sssamuelll/sam17/docs/superpowers/specs/2026-09-03-maestro-j2-recuperacion-design.md

# El maestro del J2: plazo, reinicio y cuenta, porque el silicio se cuelga

**Fecha**: 2026-09-03 · **Estado**: **v2 FIRMADA el 2026-09-10** · **Sujeto**: el cerebro (STM32N657, hub §S10) como maestro de las seis ranuras SPI del J2 · **Cierra**: #287 (puntos 1 a 3, cerrado) · **Cuelga de**: la cabecera del J2 (2026-09-02), el J2 punto a punto (2026-08-25), voz-total §9.2, el hub N657 (2026-08-30)

---

## 0. Qué es este papel, y qué no

Este papel decide **qué hace el cerebro cuando su propio periférico de SPI deja de responder**, y lo decide antes de escribir el driver, porque hay un defecto abierto en el silicio o en su driver que lo obliga: embassy-rs/embassy#5607, *«STM32N6 SPI Hanging»*, abierto desde 2026-03-05, sin diagnóstico, sin asignado, con la última actividad el 2026-06-24. El #287 trae la evidencia; aquí se diseña la respuesta.

Lo que el #287 destapó, en una línea: **el J2 tiene red de seguridad del lado del módulo y ninguna del lado del cerebro.** El módulo lleva watchdog de trama (voz-total §9.2), silencio por hardware sin CPU (motor-digital R-M5) y un receptor que rechaza entero y cuenta (cabecera D8). El cerebro, como maestro, no tiene nada: ni plazo, ni reinicio, ni cuenta. Un maestro colgado hoy se traduce en el módulo soltando las notas a los ~50 ms, y ahí se queda el instrumento.

Este papel lo arregla desde el marco de un fabricante, no desde el de un proyecto que espera a upstream: **el driver falla, se asume, y la recuperación es nuestra.** Lo que se pide del silicio es lo que el manual de referencia documenta; lo que se pide de embassy es lo que ya expone públicamente; y se dice cuál es la contribución que haría que el driver propio se retirara.

**Lo que NO es:**

- No diagnostica el defecto del N6. No hay Discovery (#231), y diagnosticar desde el sillón es fabricar.
- No rediseña la cabecera ni el punto a punto. El sobre, su CRC, la sesión, los registros de subida y `T_GAP` se quedan como están. Este papel les añade un cliente, y les manda dos enmiendas pequeñas (§10).
- No decide qué hace el instrumento con una ranura que reinicia mucho o que no contesta. Marca y sube; la política es de otro papel (§6).
- **Alcance: las seis ranuras SPI.** Las dos ranuras por USART síncrono con `CS` por GPIO que el censo del hub también sostiene (`micro_budget.py`, `HUB_RANURAS_USART = 2`; hub §10.3) son otro periférico con otra máquina de estados, y quedan fuera con su HUECO (§6, §9 riesgo 7). *(⚠ V-8)*
- No toca `pinout.rs`. El reparto de pines del hub es del censo y su reescritura es otra tanda.

---

## 1. Los clientes, con su fuente

| Cliente | Qué pide | Fuente |
|---|---|---|
| El músico | Que un fallo del bus no se oiga. Un cuelgue de 10-900 s de período no puede ser un release cada tanto | La regla del instrumento, y el #287 |
| El módulo de Voz | Que el maestro vuelva antes de que su watchdog de trama dispare | voz-total §9.2: *«sin trama válida en N ms (N del plan, ~50), todos los generadores van a release»* |
| La cabecera del J2 | Que la trama que llega, llegue entera o no llegue; que el CRC del sobre decida | D2: CRC-16/CCITT-FALSE *«de los PRIMEROS 4 + largo bytes»*, computado *«sobre el búfer al subir CS, con la unidad»*; D8: *«Un receptor que rechaza entero y cuenta»* |
| El censo del hub | Que el NSS lo maneje el periférico: `J2:SPI4_NSS=PE11` y equivalentes en SPI1-6 | `micro_budget.py`, hub §10.1 |
| El punto a punto | Que el reloj de cada enlace sea el sancionado, y que el maestro sea constante del cerebro por ranura | D2, D3 |
| El firmware del cerebro | Que la política se pruebe sin placa, en `core`, y que `fw` sea delgado | `fw/src/main.rs:6`: *«Capa DELGADA a propósito»* |
| El planificador del cerebro | Que siga siendo el único escritor del enlace | Cabecera R-C8: *«El enlace tiene un solo escritor en el cerebro: el planificador»* |
| Upstream | Que lo que aprendamos vuelva al hilo #5607 | El precedente de #911 y #6939 |

### 1.1 Lo que el issue dice, contra lo que tenemos *(⚠ filas 1 y 5 corregidas por S-2)*

| Hecho del hilo | Nuestro diseño | Consecuencia |
|---|---|---|
| En modo bloqueante, `RXP` no sube nunca: el maestro escribió, `TXC = 1`, y la recepción no vio nada. Con DMA se cuelga *«waiting for the end of transfer flag»* | El J2 es DMA en los dos extremos | El modo de fallo es **la recepción no termina** (H-1). Un plazo que solo cubra el fin de transferencia no lo ve: tiene que cubrir también la espera del DMA (D2) |
| Sale a 100 kHz y a alta frecuencia | 34,5 MHz (D8) | Bajar el reloj no es salida |
| Pasa con el bus al aire | 74 cm de cinta, sancionados | No es integridad de señal |
| Corrupción: el `CS` sube a mitad, un bit se duplica | CRC del sobre, receptor que rechaza entero | Se detecta; hay que absorberla sin que se oiga (D6) |
| El camino bloqueante y `write`/`transfer` con DMA van con `TSIZE = 0`; **`read` con DMA sí fija `TSIZE`** y también se cuelga | `TSIZE > 0` siempre (D1) | **`TSIZE` no es refugio.** Lo que sí es distinto: el `CS` lo mueve un GPIO en el hilo (`SSM = 1` en su volcado) y aquí lo mueve el periférico. Sin probar |
| Los dos reportantes usan `SPI5`; nadie probó otra instancia | Seis enlaces en `SPI1-6` | Pregunta upstream (§9, acción 1) |
| Escribir a `TXDR` desatasca el caso bloqueante; en DMA no | — | El reinicio es el del manual, no el paliativo |

> **Enmienda del 2026-09-08 (§1.1, alcance):** la premisa «nadie probó otra
> instancia» queda refutada. En [embassy-rs/embassy#5607](https://github.com/embassy-rs/embassy/issues/5607),
> jake-taf, uno de los reportantes originales, respondió el 2026-09-03:
> *«I have observed this problem on SPI1 as well»*. Hay cuelgues reportados en
> **dos instancias, SPI5 y SPI1**. El defecto no es exclusivo de SPI5; esta
> respuesta no demuestra que fallen todas las instancias del bloque ni
> identifica la causa. La pregunta de la fila ya tiene respuesta con ese alcance.

> **Enmienda del 2026-09-08 (§1.1, consecuencia de diseño):** cambiar de
> instancia no es una salida de esquemático acreditada por la evidencia. La
> recuperación es **obligatoria para las seis ranuras SPI**: el plazo de D3,
> los ocho pasos de D4 en su orden, la ventana deslizante y las dos marcas de
> salud de D7. La política vive en `software/nucleo/core/src/maestro_j2.rs` y
> el driver ejecuta la recuperación en `software/nucleo/fw/src/j2_spi.rs`
> (D8). Es un requisito del diseño aun sin diagnóstico, y ninguna ranura queda
> exenta por llevar una instancia distinta de SPI5.

### 1.2 Lo que embassy hace, leído en el código *(⚠ corregido por S-2)*

`embassy-stm32/src/spi/mod.rs`, `main` al 2026-09-03 (copia en el scratchpad de la sesión, 2130 líneas):

- **`read` con DMA** (`spi_v4`-`v6`) fija **`TSIZE = N`** por trozos (`:1332-1342`), arma el DMA de recepción, `SPE = 1`, `CSTART`, espera el futuro del DMA y luego `finish_dma`, que espera `EOT` en un bucle: `while !regs.sr().read().eot() {}` (`:1804-1808`). Al salir vuelve a `TSIZE = 0` (`:1372`).
- **`write` y `transfer`** no tocan `TSIZE`: heredan el `0` del constructor (`:488`) y `finish_dma` espera `TXC`. `transfer_inner` hace `join` de los dos futuros del DMA (`:1499`) y luego `finish_dma` (`:1501`).
- **Ese bucle es síncrono.** No cede al ejecutor. Un `embassy_time::with_timeout` alrededor de la llamada no puede vencerlo. Y el `join` de los futuros del DMA tampoco está bajo ningún plazo: si la recepción no termina (el modo del hilo), la tarea se queda ahí sin que exista siquiera un `TimeoutError` que recibir (H-1). Cuando el N6 se cuelga, **se congela la tarea y todo lo que comparta ejecutor con ella**.
- El SPI de embassy-stm32 **no usa su propia interrupción**: todo es DMA más sondeo. `EOTIE` no aparece en el archivo.
- **Sí maneja NSS por hardware**: `Spi` guarda `nss: CsPinType` (`:321`); `ssm = nss.is_none()` (`:390`); con pin de NSS y maestro, `SSOE = 1` (`:464`).
- **Sí apaga el SPI entre transferencias**: `set_spe(false)` al entrar a cada `write`/`read`/`transfer` y `set_spe(true)` antes de `CSTART`.

De aquí sigue: el driver de embassy tal cual **no sirve para el J2**, no por el defecto del N6, sino porque sus dos esperas no son cancelables. Eso contesta la fila 6 del §10 del hub para el SPI (§10, enmienda).

Lo que sí expone embassy, verificado en `main`, y que el driver propio usa sin tocar nada privado: `rcc::enable_and_reset::<T>()` (`rcc/mod.rs:622`), `dma::Channel::new` (`dma/mod.rs:80`) y `Channel::read`/`write(request, peri_addr, buf, opts) -> Transfer` (`gpdma/mod.rs:934`, `:1004`), el trait `spi::TxDma`/`RxDma` con `fn request(&self) -> Request` público (`macros.rs:162-173`), `embassy_time`, `InterruptExecutor` (`embassy-stm32/src/executor.rs:196`, `start(irq) -> SendSpawner`), y el `IWDG`, que el N657 sí trae (`stm32-data-generated/data/chips/STM32N657X0.json`).

---

## 2. Las decisiones

### D1. Toda transferencia del J2 lleva `TSIZE` y NSS por hardware, y son una sola decisión *(⚠ reescrita: la v1 ataba también el CRC de hardware, y la cabecera ya lo había descartado — S-1, V-1, H-4)*

El manual ata el NSS por hardware al contador. RM0486 Rev 4, §67.4.7, p. 3437:

> *«NSS output enable (SSOE = 1): this configuration is only used when the MCU is set as master. The NSS pin is managed by the hardware. The functionality is tied to CSTART and EOT control. As a consequence, the master must apply the proper TSIZE > 0 setting to control the NSS output correctly.»*

Y §67.4.12, p. 3447:

> *«If a hardware data counter is used (TSIZE bitfield of the SPI_CR2 register set to a nonzero value), the application software does not need to calculate the remaining number of data to be handled. The end of transfer automatically controls the CRC, as well as the hardware slave select management, when used.»*

O sea: el NSS por hardware que el censo ya reparte **no funciona sin `TSIZE`**. Los dos van juntos:

1. **`TSIZE = bytes clocados de la trama`**, la cuenta de la cabecera §4: `largo + 7` (sobre de 4, carga, CRC de 2, cola de 1), rellenada a la ventana del dialecto cuando toca (cabecera D6.3: en la Voz, ≥ `VENTANA_SUBIDA + 1 = 25`). Se conoce por construcción antes de cada transferencia. Nunca `0`. *(⚠ S-14, H-5: la v1 decía «sobre + cola» y omitía el CRC y el relleno)*
2. **`SSM = 0`, `SSOE = 1`, `SSOM = 0`**: el NSS baja con `CSTART` y sube con `EOT`. §67.4.7, p. 3438: *«When SSOM = 0 and SP = 000, the NSS signal is driven to the active level as soon as the master transfer starts (CSTART = 1) and it is kept active until its EOT flag is set or the transmission is suspended.»* El `CS` de la cabecera D3, *«el CS es la dirección»*, lo pone el periférico, no un GPIO.

**El CRC es el del sobre, y solo ese.** La cabecera D2 lo decidió: CRC-16/CCITT-FALSE sobre los primeros `4 + largo` bytes, dentro del sobre, computado con la unidad CRC del chip sobre el búfer, precisamente porque *«un receptor de largo variable no conoce `TSIZE`»*. El CRC del periférico SPI (`CRCEN`) viaja como trama aparte **después** de los `TSIZE` datos y se compara en el maestro contra lo que el esclavo shiftee en ese momento, que no es un CRC (§67.5.3, p. 3456: *«The length of the transfer must be defined by TSIZE. When the desired number of data is transferred, the TXCRC is transmitted and the data received on the line are compared to the RXCRC value.»*). Activarlo daría `CRCE` en cada giro y dos CRC en el cable. **`CRCEN = 0`.**

**Por qué importa contra el #5607, dicho sin exagerar:** el montaje del hilo mueve el `CS` con un GPIO. El nuestro lo mueve el periférico. Eso es lo único que separa los dos montajes, porque `TSIZE > 0` ya lo usa el `read` de embassy y también se cuelga (§1.1). No es prueba de nada; es una variable que el bring-up mueve (§9, riesgo 1).

> **Enmienda del 2026-09-08 (D1, NSS por hardware):** jake-taf respondió el
> 2026-09-03 en [#5607](https://github.com/embassy-rs/embassy/issues/5607):
> *«I haven't tried that mode.»*, sobre `SSM = 0, SSOE = 1`. No hay una prueba
> de ese modo documentada en la evidencia disponible. El bring-up (#231)
> aportará nuestro primer dato: si no se cuelga, será un hallazgo propio bajo
> las condiciones ensayadas; si se cuelga igual, el modo de NSS dejará de
> separar los casos con cuelgue. Sigue siendo **HUECO** el resultado con NSS
> por hardware; la recuperación de D4 sigue siendo requisito en ambos casos.

**Lo que trae de regalo:** con `TSIZE > 0` y `SSOM = 0`, el fin de la trama es un flanco de NSS generado por hardware al `EOT`, exacto al reloj. La cuenta de bytes en el flanco del esclavo (cabecera D6.4, H-14) recibe un flanco limpio.

### D2. Las dos esperas son cancelables, y el plazo abraza las dos *(⚠ reescrita: la v1 ponía el plazo solo sobre `EOT` — H-1, S-12, H-11)*

Una transferencia del J2 espera dos cosas: que el DMA termine (los dos canales, en full duplex) y que el periférico marque `EOT`. **Las dos esperas son futuros, y el plazo de D3 abraza las dos juntas:**

```
with_timeout(plazo, async {
    join(tx_dma, rx_dma).await;   // los Transfer de embassy, cancelables por Drop
    eot.await;                    // el futuro de la ISR
}).await
```

Si la recepción no termina nunca (el modo del hilo), el plazo vence en el `join`; si el DMA terminó y el periférico no marca `EOT`, vence en el segundo. En los dos casos la tarea recibe `TimeoutError` y ejecuta D4. Ninguna espera del J2 es un bucle sin cota (R-MJ2).

**El fin de transferencia es una interrupción.** El maestro habilita `EOTIE` y espera un futuro que resuelve la ISR. RM0486 §67.11.5, p. 3490: *«Bit 3 EOTIE: EOT, SUSP and TXC interrupt enable»*. Y §67.7, Tabla 661, p. 3458, la fila del evento:

| Interrupt event | Event flag | Enable control bit | Event clear method |
|---|---|---|---|
| End Of Transfer (full transfer sequence completed - based on TSIZE value) | EOT | EOTIE | Writing EOTC to 1 |

La ISR de `SPIn` hace lo mínimo: lee `SR`, guarda las banderas que importan (`EOT`, `SUSP`, `OVR`, `MODF`) junto con la **generación** de la transferencia en curso, limpia por `IFCR`, deshabilita `EOTIE`, y despierta (`AtomicWaker`). Solo `EOTIE` se habilita: con `TSIZE` y DMA no hay `OVR` en el maestro, `MODF` no aplica con un solo maestro por enlace (punto a punto D1), y el `CRCE` del periférico no se usa (D1). *(⚠ S-12c)*

**Tres reglas que cierran los huecos que la junta encontró en la espera** *(⚠ S-12, H-10, H-11)*:

1. **Cada transferencia tiene una generación** (`u32` por ranura, `+1` al armar). La tarea la escribe antes de armar y la ISR la copia junto a las banderas. La tarea acepta un resultado solo si la generación coincide; un `EOT` que llega después de vencido el plazo pertenece a una generación vieja, **se descarta y se cuenta** (`eot_tardios`), porque esa trama sí salió al cable y el módulo no la ve como perdida (§3.3, `perdidas ≥ rechazadas` cambia de lectura: ver §10).
2. **El resultado guardado se borra al armar**, antes de habilitar nada. Nunca se consume un búfer de la trama anterior.
3. **El `poll` del futuro de `EOT` registra el waker antes de mirar la bandera.** Al revés pierde el despertar y el plazo vence sobre una trama buena.

> **Enmienda del 2026-09-18 (D2 regla 1, lectura; revisión del driver, ruling R13):** el hardware no etiqueta el `EOT` con ninguna generación, así que lo único que la ISR puede copiar es la generación **armada en el instante en que corre**; la comparación de la regla 1 no puede fallar por sí sola. Lo que la regla 1 protege de verdad es un resultado guardado que la tarea no llegó a consumir: lo descarta y lo cuenta la regla 2 al armar (`Turno::armar`, en `core`). Y lo que protege a la generación es la disciplina de `EOTIE` (apagado en D4.1, encendido después de armar) más una cosa que faltaba: **una ISR ya pendiente en el NVIC cuando D4 apaga `EOTIE` corre después del reinicio**, y por eso D4 hace `NVIC::unpend` de la interrupción de la ranura tras el paso 1 y tras el paso 7.

**El orden de arranque, y por qué `EOTC` va donde va** *(⚠ S-12d, H-11)*: el manual dice en §67.11.6, p. 3492, que *«EOT is set by hardware as soon as a full transfer is complete, that is when SPI is re-enabled or when TSIZE number of data have been transmitted and/or received on the SPI. EOT is cleared when SPI is re-enabled or by writing 1 to the EOTC bit of the SPI_IFCR register optionally.»*, y en §67.11.6, p. 3490, que *«All the flags of this register are not cleared automatically when the SPI is reenabled.»* Las dos frases no encajan del todo, y este papel no elige cuál es la buena: **escribe `EOTC` después de `SPE = 1` y antes de `EOTIE = 1`**, con lo que da igual cuál sea. Es decisión propia por prudencia, no cita. El bring-up la mide (§9, riesgo 5). El orden completo:

```
SPE = 0 → TSIZE = N (CR2, solo con SPE = 0, p. 3484) → RXDMAEN → canales de DMA armados
→ TXDMAEN → SPE = 1 → EOTC → EOTIE = 1 → CSTART
```

Los pasos del DMA son los de §67.4.14, p. 3451: *«When starting communication using DMA, to prevent DMA channel management raising error events, these steps must be followed in order: 1. Enable the DMA Rx buffer in the RXDMAEN bit of the SPI_CFG1 register, if DMA Rx is used. 2. Enable DMA requests for Tx and Rx in DMA registers, if the DMA is used. 3. Enable the DMA Tx buffer in the TXDMAEN bit of the SPI_CFG1 register, if DMA Tx is used. 4. Enable the SPI by setting the SPE bit.»*

**El SPI está apagado entre transferencias, siempre.** El manual lo recomienda tres veces (p. 3448 *«it is recommended to disable the SPI and enable it again when the transfer is complete, even if the SPI configuration is not changed»*; p. 3492 *«SPI is strongly suggested to be disabled and re-enabled before next transfer starts despite its setting is not changed»*; y `TSIZE` solo se puede escribir con `SPE = 0`, p. 3484), embassy lo hace, y D4 lo necesita. *(⚠ S-4b)*

> **Enmienda del 2026-09-11 (D2, el hueco entre `SPE = 1` y `CSTART`; acta del 11-09, fichas 1 y 3):** el chip hermano tiene documentado un atasco del maestro que el orden de arriba no evita y, bajo una lectura del manual, provoca. ES0396 Rev 9 (STM32H750/H753, bloque `spi_v4`; el N657 es `spi_v5` y embassy los trata juntos), §2.14.2 «Master data transfer stall at system clock much faster than SCK», presente en todas las revisiones de silicio (A A A):
>
> *«With the system clock (spi_pclk) substantially faster than SCK (spi_ker_ck divided by a prescaler), SPI/I2S master data transfer can stall upon setting the CSTART bit within one SCK cycle after the EOT event (EOT flag raise) signaling the end of the previous transfer. Workaround. Apply one of the following measures: • Disable then enable SPI/I2S after each EOT event. • Upon EOT event, wait for at least one SCK cycle before setting CSTART. • Prevent EOT events from occurring, by setting transfer size to undefined (TSIZE = 0) and by triggering transmission exclusively by TXFIFO writes.»*
>
> Bajo la lectura literal de p. 3492 (*«EOT is set … when SPI is re-enabled»*), el `SPE = 1` del orden de arriba es él mismo un evento `EOT`, y `CSTART` llega tres escrituras APB después: **entre 15 y 60 ns** según pclk (cálculo de Halberg, junta del 11-09, H-1; no medido), contra **100 ns** de ciclo de SCK al piso de 10 MHz y 29 ns a los 34,5 MHz de D8. La solución 1 de la errata, apagar y encender, que D2 ya aplica, genera bajo esa lectura el evento que la solución 2 quiere evitar. Y ES0620 Rev 5 §2.2.1 (N657, #363) dice que el prescaler de APB no funciona y pclk replica siempre a hclk: la razón pclk/SCK no se puede bajar por ese camino.
>
> **Lo que cambia:** entre `SPE = 1` y `EOTC` el driver **lee de vuelta `CR1`** y **espera al menos un ciclo de SCK contado desde esa lectura**, en ciclos de CPU (80 a 800 MHz para 100 ns; 24 para 29 ns), no con `embassy_time`, cuyo grano de 1 µs es diez veces el ciclo. La lectura de vuelta es el anclaje: según Halberg, una escritura a memoria Device puede quedar en vuelo y el retardo transcurrir antes de que `SPE = 1` llegue al periférico; una lectura devuelve cuando el periférico contesta. Coste: 0,08 % del giro por ranura. El orden queda:
>
> ```
> SPE = 0 → TSIZE = N → RXDMAEN → canales de DMA armados → TXDMAEN
> → SPE = 1 → leer CR1 → esperar ≥ 1 T_SCK → EOTC → EOTIE = 1 → CSTART
> ```
>
> **Estado de la evidencia:** ES0620 Rev 5 (agosto 2026), la errata del N657, **no lista ningún ítem del periférico SPI**. La enmienda entra **por analogía** con el H7 y así queda marcada hasta que la placa la mida. La medida que dirime la lectura cuesta un acceso: con nada armado, escribir `SPE = 1` y leer `SR.EOT`. Si vuelve 1, la hipótesis está viva y todo armado cae dentro de la ventana al piso; si vuelve 0, el `EOT` anterior fue el de la trama del giro previo y D2 ya la cubría con más de 100 µs de sobra. Después, el barrido del retardo (§9, enmienda del 11-09, punto 3): una tasa de cuelgue que dependa del retardo es la firma de la errata; una que no, no lo es.
>
> **Medido el 2026-10-01 en la NUCLEO-N657X0-Q** (firmware `259bc91`, binario `control_positivo`; una corrida anterior con el mismo código sin commitear dio lo mismo): `eot_al_encender = 0` con el SPI5 recién reseteado (esclavo) y `= 0` con `MASTER = 1`. Prender no levanta `EOT`: por lo escrito arriba, D2 ya la cubría, y la errata 2.14.2 no es el mecanismo de #5607 en esta configuración (junta de Halberg, 11-09). Queda el barrido del retardo, que es lo que dice si la tasa depende de él.

> **Enmienda del 2026-10-14 (D2, `TXTF` al armar; medido en la NUCLEO-N657X0-Q):** el orden de arranque limpiaba `EOT` y nada más, y `TXTF` se queda puesto de una transferencia a la siguiente. §67.11.6, p. 3492: *«TXTF is set by hardware as soon as all of the data packets in a transfer have been submitted for transmission by application software or DMA, that is when TSIZE number of data have been pushed into the TxFIFO. This bit is cleared by software write 1 to the TXTFC bit of the SPI_IFCR exclusively.»* Ni `SPE = 0` ni rehabilitar lo borran, y el cierre de una transferencia buena no escribía `IFCR`. Con `TXTF` puesto al armar, el GPDMA no recibe ninguna petición de `TXDR`: en placa, el canal de transmisión se queda con sus 25 bytes (`CxBR1.BNDT = 25`), el maestro no saca reloj y el plazo vence. Pasaba en el **segundo giro de cada arranque**. Embassy limpia todas las banderas una sola vez, al configurar (`spi/mod.rs:462`), y transfiere con `TSIZE = 0`. El manual no dice si `TXTF` se pone con `TSIZE = 0` (p. 3492 lo liga a que `TSIZE` datos hayan entrado en la TxFIFO) y este banco no lo ha medido, así que no se sabe si el camino bloqueante de embassy lo sufre. **Lo que cambia:** `TXTFC` justo después del `SPE = 0` del armado, antes de tocar `TSIZE` y el DMA:
>
> ```
> SPE = 0 → TXTFC → TSIZE = N → RXDMAEN → canales de DMA armados → TXDMAEN
> → SPE = 1 → leer CR1 → esperar ≥ 1 T_SCK → EOTC → EOTIE = 1 → CSTART
> ```
>
> Medido después del cambio: 20 000 giros seguidos de 25 bytes a 8 MHz, los 20 000 con `EOT` en plazo y la subida exacta, y el esclavo contó 20 000 tramas enteras.

### D3. Toda espera tiene plazo, y el plazo sale de R-E1

El plazo es **por mensaje**, no global:

```
plazo(msg) = FACTOR_PLAZO × t_nominal(msg) + T_SUELO_PLAZO
t_nominal(msg) = bytes_clocados(msg) × 8 / f_reloj_sancionado(ranura)
```

- `bytes_clocados` es el de la cabecera §4 (sobre + carga + CRC + cola, con relleno), ya presupuestado en `trama_j2_budget.py`. Es el mismo número que `TSIZE` (D1).
- `f_reloj_sancionado` es el de la ranura (punto a punto D2, `sancion_j2.csv`), o el piso legado si no hay fila. Hoy no hay fila: el instrumento corre al piso.
- `FACTOR_PLAZO = 2` y `T_SUELO_PLAZO = 20 µs`: **ESTIMADO**, sin fuente. El factor cubre `T_GAP` (2 µs provisional), `MSSI`/`MIDI` si se usan, y la latencia de la ISR; el suelo evita que un `HOLA` de 9 bytes (cabecera §4) a 34,5 MHz, 2,1 µs, tenga un plazo de 4 µs. En el enlace de la Voz el `HOLA` va rellenado a 25 bytes, 5,8 µs. *(⚠ S-9: la v1 decía 7 bytes)* Los sella el bring-up con osciloscopio (§9, riesgo 2).
- **Cota:** por R-E1 ningún mensaje dura más de 100 µs al piso, así que `plazo ≤ 220 µs` para cualquier mensaje. El mensaje real más largo, `SET` de 16, son 82,4 µs al piso y 184,8 µs de plazo. El presupuesto asevera la cota.

**Lo que NO se pone bajo plazo:** el `T_GAP` entre mensajes y la cadencia del giro. Esos son del planificador (cabecera D8) y no tienen nada que colgarse.

> **Nota del 2026-09-19 (D3, la cota contra el reloj real):** los 82,4 µs y los 184,8 de arriba suponen que el enlace cloca a los 10 MHz del piso. **No es lo que sale.** El `MBR` solo da potencias de dos y redondea hacia abajo, y el kernel del SPI5 es `pclk2` = 32 MHz (no el HSI de 64: el mux se queda en su cero, `Spisel45::Pclk2`; la cadena está en `j2_spi::Ranura::f_sck_hz` y en el `//!` de `control_positivo`). Pedir 10 MHz da `/4`, o sea **8 MHz reales**, y con ese reloj:
> 
> - el `SET` de dieciséis, 103 bytes clocados, dura **103 µs** — por encima de los **100 µs de R-E1**;
> - su plazo sale `2 × 103 + 20` = **226 µs** — por encima de los **220 µs** que esta misma sección publica como cota.
> 
> Las dos son la misma cosa vista dos veces, y ninguna es un defecto del driver: **el driver usa el `f_sck` real y lo publica** (`Ranura::f_sck_hz`, la columna `reloj_MHz` del CSV y la línea de arranque de los cuatro binarios), así que el plazo que calcula es el correcto para el reloj que hay. Lo que está mal es la premisa de que el piso son 10 MHz clocados. Elegir el piso de verdad —subir el kernel, bajar el mensaje más largo, o sancionar la ranura— es el **#380**, y hasta entonces esta cota queda **declarada y no cumplida** para el `SET` de dieciséis. Ningún otro mensaje de la tabla de la cabecera §4 la roza: el siguiente, `BAHIA` con 71 bytes, son 71 µs y 162 de plazo.

### D4. Al expirar, el periférico se reinicia según el manual, entero y en orden, y el reinicio se cuenta *(⚠ reescrita: la v1 omitía un paso, encendía al final y dejaba `EOTIE` armado — S-4, S-12a, S-13, H-8)*

Un plazo vencido no se reintenta: se reinicia. La receta es la del RM0486, completa, y termina con el SPI **apagado**, que es como está siempre entre transferencias (D2).

> **Enmendada el 2026-10-14:** los pasos 3 a 7 de la receta se sustituyen por un reset del periférico por RCC. La enmienda está dentro del paso 2, antes del paso 3.

1. **Silenciar la ISR.** `EOTIE = 0`. Si no, el `CSUSP` del paso 3 produce `SUSP`, `SUSP` dispara la ISR (`EOTIE` cubre `SUSP`, p. 3490), y la ISR limpia `SUSPC` antes de que el paso 3 lo vea. *(⚠ S-12a)*
2. **Soltar el DMA.** Los dos `Transfer` de embassy se sueltan: su `Drop` (`gpdma/mod.rs:1287-1295`) llama a `request_reset()` y espera a que el canal pare; `request_reset` (`:902-910`) hace `request_pause()`, espera `is_running() == false`, y resetea el canal. Esa espera es un bucle con cota práctica (la pausa actúa al fin de la ráfaga en curso) pero sin cota escrita: si el canal de GPDMA mismo no responde, ahí se queda, y eso lo cubre el IWDG del hub (D5), no este papel (§9, riesgo 6). Esto es el paso 1 del cierre del manual, §67.4.14, p. 3451: *«To close communication, it is mandatory to follow these steps in order: 1. Disable DMA requests for Tx and Rx in the DMA registers, if the DMA issued. 2. Disable the SPI by following the SPI disable procedure. 3. Disable DMA Tx and Rx buffers by clearing the TXDMAEN and RXDMAEN bits of the SPI_CFG1 register, if DMA Tx and/or DMA Rx are used.»*

   > **Enmienda del 2026-09-18 (D4 paso 2 y R-MJ2; #368, riesgo 6 de la junta del 11-09):**
   > la espera del `Drop` deja de ser «de embassy y declarada» y pasa a tener **cota
   > propia**. El driver no suelta ningún `Transfer` mientras su canal pueda estar
   > corriendo: pide `request_pause()` a los dos canales (una escritura de
   > `CxCR.SUSP`, sin bucle; `gpdma/mod.rs:882-887`), sondea `is_running()`
   > como máximo **`T_CANAL` (ESTIMADO 10 µs, de la clase de `T_SUSP`)** y solo
   > entonces los suelta: el `Drop` de embassy (`request_reset()` + su espera,
   > `gpdma/mod.rs:1287-1295`) entra y sale al instante con el canal ya suspendido.
   > Si un canal no para dentro de la cota, el driver **escala**: deja los dos
   > `Transfer` en su `ManuallyDrop` sin soltar (no se llama a `drop`; un
   > `mem::forget` sobre un `ManuallyDrop` no hace nada) y resetea el GPDMA1 entero por RCC
   > (`rcc::enable_and_reset::<GPDMA1>()`; el generador de embassy implementa
   > `RccPeripheral` para `GPDMA1`). Las otras cinco ranuras ven sus futuros de DMA
   > resolverse, no reciben `EOT`, vencen su plazo y ejecutan D4 cada una: un
   > reinicio de las seis ranuras **bajo control y dentro de los 50 ms del módulo**,
   > no un reinicio del chip. Se cuenta aparte (`escaladas_gpdma`, en `fw`, no en
   > la política). El IWDG del hub deja de ser la cobertura del riesgo 6: es la red
   > de lo que ni un reset de RCC arregla, que por construcción no existe. Por qué
   > no la otra salida del issue (correr el reinicio en una tarea fuera del
   > ejecutor): una espera sin cota bloquea al ejecutor donde gire, y todos tienen
   > algo debajo que no puede parar. Los pasos están en
   > `docs/superpowers/plans/2026-09-18-j2-fase-b.md`, tarea 7d.
   >
   > *Correccion del mismo 18-09:* la primera redaccion de esta enmienda mandaba
   > `request_reset()` y luego sondear con cota. `request_reset()` de embassy ya
   > contiene `request_pause(); while is_running() {}` sin cota (`gpdma/mod.rs:902-910`,
   > que este mismo paso cita arriba): la cota habria sido codigo muerto. Lo cazo
   > la revision del driver, no el plan. La forma que vale es la de arriba.

   > **Enmienda del 2026-10-14 (D4 pasos 3 a 7 y D4.2; medido en la NUCLEO-N657X0-Q): los pasos 3 a 7 de abajo se sustituyen por un reset del periférico por RCC.** La receta dejaba el SPI muerto. Si la suspensión del paso 3 no llega a aceptarse antes del `SPE = 0` del paso 5, queda pendiente: sobrevive al apagado y a rehabilitar, y ningún `CSTART` posterior saca un solo reloj. El DMA llena la FIFO (`CxBR1.BNDT` del canal de transmisión baja de 25 a 9), no sube nada y el plazo vence en cada giro, para siempre. La suspensión no se aceptó en los dos casos medidos:
   >
   > - **un maestro parado con `CSTART = 1` y la FIFO vacía**, que es el estado de un cuelgue: tras `CSUSP` y 10 µs, `CR1` sigue en `0x201` (`SPE` y `CSTART`) y `SUSP` no sube. La frase de p. 3483 (*«the CSTART bit is reset at the end of the current frame»*) no tiene trama en curso que terminar;
   > - **un aborto a mitad de trama a 125 kHz**, donde un byte dura 64 µs y `T_SUSP` eran 10.
   >
   > El mismo atasco limpiado solo con `SPE = 0`, sin `CSUSP`, sí se recupera. Pero el banco acaba de enseñar que `SPE = 0` no limpia todo el estado interno, aunque p. 3484 diga *«the internal state machine is reseted»*: la suspensión pendiente sobrevive. Lo único que revivió el SPI envenenado fue el reset por RCC, y es lo único que no depende de qué haya dentro. Esto contesta los hallazgos 9 y 15 de Serrano en la junta del 11-09 (*«¿el reinicio de D4 incluye reset por RCC o no?»*): sin él, el reinicio no curaba. Lo que sigue sin evidencia es que el reset cure **el cuelgue del N6**, que este banco no ha reproducido; cura los dos estados que sí se produjeron.
   >
   > La receta queda en seis pasos:
   >
   > 1. silenciar la ISR (`EOTIE = 0` y `NVIC::unpend`), sin cambios;
   > 2. soltar el DMA con cota `T_CANAL`, sin cambios;
   > 3. **resetear el SPI por RCC**, con el reset que de verdad resetea (`rcc::disable` y después `rcc::enable_and_reset`; ver el último párrafo). Deja todos los registros en su valor de reset: `SPE = 0`, los dos `DMAEN` y `IER` a cero y las banderas limpias, que es lo que hacían los pasos 5 a 7, y se lleva además lo que esos pasos no alcanzan;
   > 4. **reescribir `CFG2` y `CFG1`** tal como los dejó la construcción (D1). `CFG2` primero: con `AFCNTR = 1`, NSS y SCK vuelven a su nivel inactivo. Entre el reset y esa escritura el SPI no maneja NSS ni SCK, y el `CS` queda un instante a lo que ponga el esclavo (en el banco, el pull-up de PE11). La trama ya estaba perdida (p. 3449);
   > 5. `NVIC::unpend` otra vez, por lo mismo que antes;
   > 6. contar y seguir (el paso 8 de abajo).
   >
   > `T_SUSP` desaparece, y con él uno de los dos sondeos acotados de R-MJ2; queda `T_CANAL`. **Medido después del cambio:** un aborto a mitad de trama a 125 kHz deja el SPI en sus valores de reset y los dos giros siguientes salen bien; un SPI envenenado a propósito vence su primer giro, el D4 de ese giro lo revive y los dos siguientes salen bien.
   >
   > **D4.2, la escalada, tampoco reseteaba nada.** `rcc::enable_and_reset` de embassy solo pulsa el bit de reset si el reloj del periférico está apagado; con el reloj encendido se lo salta (`rcc/mod.rs`, `enable_and_reset_with_cs_inner`, rama `skip reset`). El GPDMA1 se enciende al arrancar, así que la escalada de la enmienda del 18-09 dejaba los canales como estaban y devolvía `Escalado` igual. Medido: con `enable_and_reset` solo, el `CxCR` del canal 0 no cambia; con `rcc::disable` delante vuelve a cero y los dos canales del esclavo quedan en reposo. La escalada va ahora por ese par, igual que el paso 3. Vale para SPI1-6 y GPDMA1 porque ninguno lleva cuenta de referencias en el `_generated.rs` (`refcount_idx = None`), y `disable` apaga el reloj sin preguntar.

3. **Suspender, con cota.** `CSUSP = 1` y sondear `SUSP = 1` **como máximo `T_SUSP` (ESTIMADO 10 µs)**, contando con `embassy_time::Instant` (tick declarado en el plan; 1 MHz cubre esta cota) o con ciclos. §67.11.1, p. 3483: *«In master mode, when this bit is set by software, the CSTART bit is reset at the end of the current frame and communication is suspended. The user has to check SUSP flag to check end of the frame transfer.»* Es una espera síncrona **acotada**, que R-MJ2 permite: es el único sitio donde un sondeo con cota es la herramienta honesta, porque el periférico está mintiendo. *(⚠ S-13, V-11)*
4. **Limpiar `SUSP` incondicionalmente.** `SUSPC = 1`, haya llegado `SUSP` o no. §67.11.6, p. 3491: *«This bit must be cleared prior to disabling the SPI. This is done by setting the SUSPC bit of SPI_IFCR exclusively.»* Escribir `SUSPC` sin `SUSP` no hace nada, y escribirlo con `SUSP` recién llegado (entre la cota y el apagado) evita apagar con la suspensión a medio aceptar. *(⚠ S-4c)*
5. **Apagar.** `SPE = 0`. §67.11.1, p. 3484:

   > *«When SPE = 0 any SPI operation is stopped and disabled, all the pending requests of the events with enabled interrupt are blocked except the MODF interrupt request (but their pending still propagates the request of the spi_plck clock), the NSS output is deactivated at master, the RDY signal keeps not ready status at slave, the internal state machine is reseted, all the FIFOs content is flushed, CRC calculation initialized, receive data register is read zero.»*

   Se acepta la pérdida de la trama en curso. §67.4.12, p. 3449: *«Caution: If the SPE bit is cleared in master mode while the transfer is ongoing without any suspension, the clock is stopped even if the current frame transmission is not complete, and the content of the FIFOs is flushed and lost.»* Esa trama ya estaba perdida. *(⚠ S-3: la cita va entera; la v1 la había recortado)*
6. **Apagar los búferes de DMA del periférico.** `TXDMAEN = 0`, `RXDMAEN = 0` en `CFG1`, que solo se puede escribir con `SPE = 0` (p. 3484: *«The content of this register is write protected when SPI is enabled.»*). Es el paso 3 del cierre del manual, y la v1 no lo tenía. *(⚠ S-4a)*
7. **Limpiar banderas.** `IFCR`: `EOTC`, `TXTFC`, `OVRC`, `SUSPC`, `MODFC`. Las de `SR` no se limpian solas (p. 3490).
8. **Contar y seguir.** `plazos_vencidos[ranura] += 1`. La ranura queda como entre transferencias: apagada y limpia. El planificador sigue con el **siguiente giro**, no con la trama perdida: el registro de subida se muestrea (cabecera D6), y lo que baja se reafirma (D7), así que no hay nada que retransmitir. *Salvo* un `EVENTO`: ese no tiene red, y así lo dice la cabecera (D7 tabla: *«un `dispara` perdido es un golpe perdido»*). Ver D6 y §3.

**Lo que le pasa al esclavo, y lo que este papel le manda al papel del módulo** *(⚠ S-5, V-9: la v1 decía «el flanco lo realinea», y la cita que lo sostenía es del esclavo recién habilitado, no del interrumpido)*: el `SPE = 0` desactiva el NSS del maestro (p. 3484), así que el módulo ve el `CS` subir a mitad de trama. Por la cabecera D6.4 cuenta bytes en el flanco y ve una trama corta; por D8 la rechaza entera y cuenta. Lo que el manual dice del esclavo interrumpido es una sola frase, §67.4.13, p. 3450: *«In slave mode, any ongoing data are lost when disabling the SPI.»* De aquí sigue que la limpieza del esclavo es **apagar y encender su SPI**, y que un esclavo que solo rearme el DMA puede arrastrar medio byte en el registro de desplazamiento y rechazar también las tramas siguientes. **Enmienda mandada al papel del módulo (§10):** al contar corto en el flanco de `CS`, el módulo hace `SPE = 0` → `SPE = 1` en su SPI antes de rearmar el DMA de recepción. Es una línea en su ISR, y es la única forma que el manual documenta de dejar el esclavo limpio.

**La `secuencia` de la trama abortada se consumió.** El planificador la asignó y el módulo no la aceptó, así que el módulo verá un hueco y lo contará en `perdidas` (cabecera §3.3, R-C3). Es correcto y esperable: en el bring-up, `perdidas` del módulo se cruza con `plazos_vencidos + eot_tardios` del cerebro (D2 regla 1), y la diferencia es lo que de verdad se perdió por el cable.

**Lo que NO se hace:** escribir a `TXDR` para desatascar. Es el paliativo del hilo para el caso bloqueante, no funciona en DMA, y meter un byte en el bus a mitad de un estado desconocido es peor que apagar.

> **Enmienda del 2026-09-08 (D4, dato del mecanismo):** jake-taf confirmó el
> 2026-09-03 en [#5607](https://github.com/embassy-rs/embassy/issues/5607):
> *«Interesting. I stuck with blocking since I have a workaround when it gets stuck (`SPI1.txdr8().write_value(0)`), but both have the problem»*.
> Confirma que usa ese paliativo en el camino bloqueante y que el cuelgue
> ocurre tanto en el bloqueante como con DMA. La prohibición de escribir a
> `TXDR` para desatascar sigue en pie, tal cual (R-MJ3).

### D5. El J2 corre en su propio ejecutor, con una tarea por ranura; el IWDG es del hub *(⚠ reescrita entera: la v1 tenía un vigía y alimentaba el IWDG desde el J2 — V-4, V-5, V-6, S-7, S-8, H-1, H-2, H-6, H-9)*

La v1 ponía un vigía en un ejecutor de interrupción que reiniciaba ranuras estancadas. La junta lo tumbó por tres lados que no admiten parche: no cubre ningún fallo que D2-D4 no cubran (si la tarea está viva, el plazo gana; si el ejecutor está congelado, reiniciar el SPI no lo descongela); no puede soltar los `Transfer` que posee la tarea, así que corre otra receta y deja dos dueños del canal; y una sección crítica que no suelta lo congela con lo que vigila. Era otra mano en el mismo volante, y R-C8 dice un solo escritor. **Muere.** Lo que queda es más simple y es lo que corre:

1. **Seis tareas, una por ranura**, cada una con su plazo (D3), su reinicio (D4) y su máquina (D7). En serie no caben: seis `NADA` de 25 bytes al piso son 120 µs más seis `T_GAP`, 132 µs en un giro de 125 (S-8). Los seis periféricos y sus doce canales de DMA corren en paralelo por hardware; las tareas solo los atienden. Un plazo vencido en una ranura no retrasa a las otras cinco, y la cuenta de D7 es por ranura: un cuelgue en una no ensucia la ventana de las demás (H-1).
2. **El planificador sigue siendo el único escritor del enlace** (R-C8). Decide qué baja por cada ranura en cada giro; las seis tareas son el transporte, como lo son los canales de DMA. No deciden nada del protocolo.
3. **Las seis tareas viven en un `InterruptExecutor` propio** (`embassy-stm32/src/executor.rs:196`), a prioridad por encima del ejecutor de hilo donde viven la pantalla, el USB y el MIDI (`fw/src/main.rs`). Una tarea de pantalla que retenga la CPU 15 ms no retrasa un giro del J2 ni un microsegundo; sin esto, la simulación de Halberg da giros perdidos a partir de 6 ms de retención y el módulo soltando a 50 (H-9). El J2 es tiempo real a 8 kHz y la pantalla no; no comparten ejecutor.
4. **El IWDG es del chip, no del J2.** Alimentarlo desde el planificador del enlace definía la vida del instrumento como «el J2 dio un giro», y con una ranura sin módulo lo habría disparado diez veces por segundo (H-6). Este papel **no decide** quién alimenta el IWDG ni con qué plazo. Le manda al papel del hub (§10) un **supervisor de vitalidad**: cada subsistema con requisito de tiempo real (el J2, la pantalla, el USB, la radio) escribe un sello; el supervisor alimenta el IWDG solo si todos los que deben estar vivos lo están. Lo que el J2 aporta es **un sello por ranura activa**, escrito al armar cada transferencia (no al completarla: una ranura reiniciando también está viva). Y le manda una cota: **el plazo del IWDG es estrictamente mayor que la ventana del watchdog de trama del módulo (~50 ms)**, para que cuando el chip se reinicie el módulo ya esté en release por su cuenta y el reinicio no añada silencio: lo termina de ordenar. Cuánto silencio añade el arranque del cerebro (descubrimiento por I²C, `HOLA`, los 7,9 ms de refresco de la cabecera D5) no está cuantificado y es HUECO del hub (S-10).

> **Enmienda del 2026-09-18 (D5.1 y §3; revisión del ejecutor, ruling R15):** tras un plazo vencido la tarea de la ranura **se realinea** al periodo (`Ticker::reset()`), no recupera los tics perdidos. Sin esto el `Ticker` de embassy clocaría en ráfaga hasta reengancharse y dejaría fronteras de trama con gap ≈ 0, justo cuando el esclavo acaba de que le arranquen el `CS`: borraría el `T_GAP` de la cabecera D8 (2 µs provisional, HUECO). El techo de recuperación de §3 se mantiene: 220 + 20 + 125 = 365 µs < 490.

> **Enmienda del 2026-10-16 (D5.1 y D5.4; el lazo no puede acaparar la CPU; medido en la NUCLEO-N657X0-Q):**
>
> **Lo que pasó.** El 15-10 se lanzó `resistencia_j2`, que pone la ranura 0 dentro del `EJECUTOR_J2` como lo hará el instrumento, y no publicó nada. Un giro cuesta más que el periodo y el `Ticker` de embassy recupera los tics perdidos (`embassy-time/src/timer.rs:470-480`), así que el ejecutor encadenaba giros sin parar y no se quedaba nunca sin trabajo. Medido por el depurador: `SELLOS[0]` subía a unos 2 700 por segundo, el contador de vueltas del hilo no se movió en minutos y `main` —que lanza el esclavo y publica las filas— no llegó a ejecutarse: `TRAMAS_OK = 0`, `subidas_malas = giros` y `muda = 1`. En el instrumento, el hilo (USB, MIDI, pantalla) habría pasado hambre igual.
>
> **Lo que cambia.**
>
> 1. **El calendario es de `core`** (`Calendario`, probado en el host). A tiempo sigue la rejilla del periodo. Si el giro, **y todo lo que la tarea hace con él**, acaba cuando ya tocaba el siguiente, no recupera nada: deja **un periodo entero de hueco** y cuenta un atraso (`atrasos`, publicado con las demás cuentas, saturado y no vuelve a cero). Es el `Ticker::reset` de la enmienda del 18-09 aplicado a cualquier atraso y no solo al plazo vencido; el hueco sigue siendo el que el esclavo necesita para rearmar (`T_GAP`).
> 2. **Un atraso es un fallo del presupuesto de CPU, no del módulo.** No mueve `inestable` ni `muda`, y D7.1 no cambia: la salud no baja la cadencia. Lo que baja la cadencia es la carga, y lo dice un contador.
> 3. **El periodo del banco puede ser más largo que el del instrumento, nunca más corto.** `lanzar_ranuras` recibe `periodo_us` y rechaza menos de `PERIODO_GIRO_US`. `resistencia_j2` corre a 1 kHz porque a 125 µs la CPU de la Nucleo (64 MHz, sin cachés) no da para el maestro y el esclavo del banco juntos: con el esclavo en el mismo ejecutor el hilo no recibió ni una vuelta en minutos y el binario no habría podido publicar una fila. A 1 ms, el hilo conserva el 54 % de la CPU y `atrasos` casi no sube (uno en 316 000 giros, y cuatro en los 86,4 millones de las 24 h del soak del 17-10). **La fila de esa corrida vale para 1 kHz, no para 8.**
> 4. **El esclavo del banco nace antes que el maestro.** `arrancar` se parte en `iniciar_ejecutor` y `lanzar_ranuras`: con un solo paso, el maestro giraba desde el primer instante contra un esclavo que todavía no existía y los primeros giros salían como `subidas_malas`.
> 5. **El IWDG lo alimenta el hilo** (requisito mandado al hub, #291). D5.4 dice que el sello sube al armar; el 15-10 subía a 2 700 por segundo con el hilo muerto, así que un supervisor que lea el sello no habría visto nada y el instrumento se habría quedado congelado sin reiniciarse. Alimentar el IWDG desde la prioridad más baja, después de comprobar el sello de las ranuras, es la única red que cubre el caso en que la CPU no alcanza: la sobrecarga acaba en un reinicio, no en un congelamiento.
>
> **Lo que el papel no tenía: un presupuesto de CPU para un giro normal.** D7.2 acota la CPU de los *reinicios* (16 % por ranura) y no dice nada de la de los giros que salen bien. Medido con `carga_j2` (maestro solo, 64 MHz, a 1 kHz; el mismo binario repite a ±1 ciclo y entre compilaciones distintas del código varía hasta un 10 %): un giro cuesta en el ejecutor del J2 **unos 17 400 ciclos sin cachés y 14 000 con la I-cache encendida**, y de esos solo 6 600 y 5 200 son código de la tarea; el resto, 10 800 y 8 800, es la maquinaria de futuros y el despacho del ejecutor. Al hilo le quedan el **69 %** y el **75 %** de la CPU. Lo que cuenta contra el límite de abajo es el J2 entero —con la ISR del SPI, el DMA y el reloj de embassy, no solo el manejador del ejecutor—, y sale de lo que el hilo no usa: **20 200 y 16 100 ciclos por giro**. Seis ranuras a 8 kHz son 48 000 giros por segundo: con ese coste son más de un núcleo entero a 800 MHz.
>
> **Firmado por Samuel el 2026-10-16** («firmamos el reparto de CPU del J2»): el J2 del hub —las seis ranuras a 8 kHz, con sus ISR, el despacho del ejecutor y los DMA— gasta **como máximo el 15 % de un núcleo del N657 a 800 MHz**, el punto de diseño del papel de alimentación (*«VOS high a 800 MHz»*): 120 millones de ciclos por segundo, o sea **2 500 ciclos por giro**. Es la primera fila del censo de CPU del hub, que no existe: `carga_motor_budget.py` es del motor y dice que sus filas heredadas no son un censo del hub, y el resto del reparto (pantalla, USB, MIDI, escritor de CV) sigue sin firmar. El oyente J2 de ese libro (20 a 50 ciclos por muestra) es el lado esclavo y no se toca. **El límite se comprueba midiendo `carga_j2` con el reloj y las cachés del hub** y anotando la fila en `carga_j2.csv`; `recuperacion_j2_budget.py` la lee y falla si una fila a 800 MHz lo pasa. Hoy solo hay filas de la Nucleo a 64 MHz: 20 160 ciclos sin cachés y 16 112 con I-cache, **8,1 y 6,4 veces el límite** (el manejador del ejecutor solo, sin la ISR del SPI, el DMA ni el reloj, son 17 415 y 14 004). No son el reloj del hub. La exploración del 17-10 a 800 MHz, que no es una fila porque le falta la región MPU de los búferes del DMA (R-MJ7), dice lo mismo: **8 000 ciclos por giro con las dos cachés (3,2 veces el límite)**, 58 000 con solo la I-cache y 82 000 sin cachés. Con tres ranuras girando son 8 167 por giro: el coste no se reparte entre ranuras, y las seis serían cerca de la mitad de un núcleo (48 %). De esos 8 000, solo 2 700 son código de la tarea; los otros 5 300 son la maquinaria de futuros y el despacho del ejecutor (3 100, 1,24 veces el límite por sí solos), la ISR del SPI y unos 1 950 sin atribuir. El mismo giro hecho por ISR, sin ejecutor (`j2_isr`, una cota: sin plazo ni D4, sin esclavo), mide **1 500**. Qué forma tiene el transporte para caber queda abierto, y cambiarla es cambiar D5.1: va por brief, papel y junta antes de la firma.
>
> Es el riesgo 9 de §9.
>
> **Acta del 2026-10-17 (el reparto de CPU del J2; D5.1 y riesgo 9).** Firmada por Samuel tras la junta del transporte (`docs/superpowers/juntas/2026-10-17-j2-transporte/acta-2026-10-17.md`); no cambia el texto firmado de arriba, lo precisa:
>
> 1. **Qué cuenta contra los 2 500 ciclos por giro:** el trabajo propio del enlace —armar y cerrar cada transferencia, el tic o las interrupciones del J2, el DMA, la comprobación de la subida (el CRC del sobre) y los contadores de salud de la política—. **No cuenta** decidir qué se envía (componer la trama a partir de notas, CV y pantalla), que será una fila aparte del censo de CPU del hub.
> 2. **El 15 % queda PROVISIONAL** hasta que exista el censo de CPU del hub: la fila del J2 era la primera de un libro que no existía. El transporte de D5.1 sigue en vigor. La puerta conserva el límite y sigue sin medida a 800 MHz con las cachés del hub.
> 3. **Se construye un prototipo de banco** del transporte «por tic» (`papel-v2.md` de la junta), acotado en el tiempo, que no toca nada firmado ni el binario del instrumento.
>
> Cambiar D5.1 sigue exigiendo brief, papel, junta y firma.
>
> **Actas del 2026-10-19 (el transporte por tic; D4.2, D5.1, R-MJ4).** Firmadas por Samuel tras la segunda a la sexta pasada de la junta del transporte (`acta-2026-10-19.md` y `acta-2026-10-19-tercera.md`, con el papel `papel-v3.md`, en `docs/superpowers/juntas/2026-10-17-j2-transporte/`). No cambian el texto de arriba, que sigue en vigor hasta que se cumplan las doce condiciones de §5.2 del papel:
>
> 1. **El transporte por tic es el diseño que se construye** (ficha A): una máquina por ranura movida por un tic de 125 µs, con el planificador y la recuperación en niveles por debajo. Lo que reescribe de D2, D4, D5.1, D7 y R-MJ2 a R-MJ4 está en §6 del papel.
> 2. **La escalada del GPDMA1 (D4.2) la autoriza un presupuesto** (ficha B): como mucho 6 en cualquier ventana de 1 s, y 1 ms entre dos concedidas, que despierta el tic.
> 3. **Las cotas de los estados de recuperación** (ficha C): `Vencida` 25 ms y `Reiniciando` 14 ms, con dos asertos en `lanzar`. **Dependen de dos números que no son del J2:**
>    - **El techo de silencio del módulo, que es de voz-total:** `T_WATCHDOG_TRAMA` = 50 ms, ESTIMADO, con una tolerancia del oscilador del módulo de ± 2 %, ESTIMADA. El aserto del módulo lo compara con el mayor hueco entre tramas de una ranura que se recupera, 39,75 ms. Si voz-total lo baja de unos 41 ms, la ficha C vuelve a la mesa.
>    - **Que el censo del hub (R-H6) excluya la saturación sostenida de las interrupciones de nivel 2:** con ellas ocupadas ~94 % durante ~100 ms, un bloqueo largo del GPDMA1 encadena incidentes, las ranuras sobreviven y los módulos pasan de 60 a 85 ms sin trama (S). El aserto del módulo vale por incidente y no lo ve.
>
>    Y R-H1, la ventana de inanición de 12 ms por nivel, también es del hub.
> 4. **El enlace del J2 vive en TCM** (ficha H, R-H4 del papel), **el CRC del sobre se calcula en el cerebro con una tabla** (ficha I; enmienda del 19-10 en D2 de la cabecera del J2), y **la fila del J2 en el censo de CPU es del 14,1 al 14,5 % de un núcleo (E)** (ficha J). La salida de la excepción y la entrada del planificador quedan por medir, y la pasada de optimización corre solo si el total medido pasa del 15,0 %.

### D6. La corrupción la absorbe el CRC del sobre; lo que tiene red se repara solo, y lo que no la tiene se dice *(⚠ precisada: V-7, S-10, S-11, H-4)*

El segundo síntoma del hilo, el bit duplicado con el `CS` subiendo antes, **no necesita nada nuevo**:

- El CRC del sobre (cabecera D2, con la unidad) la caza en el maestro y en el esclavo (D8: rechaza entero y cuenta). El maestro cuenta `subidas_malas`.
- En bajada, `TONO` completo sale a ≥ 1 kHz aunque nada cambie (cabecera D4): una trama de deltas perdida se repara sola en ≤ 1 ms. `SET`, `BAHIA` y `COMPUERTA` se reafirman (D7). La simulación de Halberg (sim4) lo confirma: a la tasa de corrupción del hilo y a cien veces esa tasa, ningún tono viejo dura más de 1,0 ms; a diez mil veces, 2,0 ms; hasta una pérdida de una trama por cada cien, ninguno pasa de 5 ms.
- **`EVENTO` no tiene red**, y eso lo decidió la cabecera (D7: *«un `dispara` perdido es un golpe perdido»*), no este papel. Un cuelgue o una corrupción que caiga en un giro con `EVENTO` es un golpe perdido. Es una **probabilidad**, no un invariante: `P(golpe perdido por cuelgue) = giros_perdidos_por_cuelgue × P(EVENTO en un giro)`, y el segundo factor depende de lo que el músico toca. El presupuesto lo deja como función con sus dos parámetros (§8); no le pone cifra, porque la tasa de cuelgues es de la Discovery y la densidad de eventos es del músico.
- **En subida, una lectura corrupta se pierde hasta la próxima publicación de ese registro**, no 125 µs: el módulo avanza de registro cuando contó bytes suficientes (cabecera D6.2), no cuando el maestro validó. `SALUD` y `ESTADO_VOZ` se publican a 1 Hz, así que una muestra corrupta es un segundo sin esa muestra; como los contadores son totales desde la sesión (cabecera §3.3), la siguiente muestra los trae. *(⚠ S-11)*

**La tasa del hilo no se normaliza.** La v1 dividía *«una o dos veces por minuto»* de otro montaje entre nuestras tramas por segundo y llamaba a eso una tasa por trama. No lo es: reloj, largo y cadencia de aquel montaje no son los nuestros. Lo que el hilo aporta son dos órdenes de magnitud a medir en el nuestro: cuelgues con período de 10-900 s y corrupción de una o dos por minuto. La Discovery mide las nuestras (§9, riesgo 1).

### D7. La ranura nunca deja de girar: la salud es una marca que sube, no una cadencia que baja *(⚠ reescrita entera: la v1 tenía sondeo lento con `HOLA`, umbrales de vuelta y backoff — V-2, V-3, V-10, S-6, S-15, H-2, H-7, H-13)*

La v1 declaraba «enferma» una ranura con muchos reinicios y la pasaba a un sondeo cada 100 ms con `HOLA`. La junta lo tumbó cuatro veces: `HOLA` abre sesión y suelta las notas (cabecera D5, R-C7); 100 ms entre tramas garantiza el release del módulo a los 50; volver a sana costaba diez segundos de silencio; y la simulación de Halberg (sim3) dice que **sin ese mecanismo ningún hueco llega a 50 ms hasta que la mitad de las tramas se cuelgan**, mientras que con él la ranura oscila entre sana y enferma a partir de cuatro cuelgues por segundo y el módulo pasa la mayor parte del tiempo en release. Hacía daño y no aportaba. **Muere.**

Lo que queda:

1. **El planificador gira a 8 kHz por toda ranura activa, siempre.** Un plazo vencido se reinicia (D4) y el giro siguiente sale a su hora. No hay cadencia reducida, no hay backoff, no hay sondeo, no hay «vuelta a sana» y por tanto no hay refresco especial: el bloque completo a 1 kHz y las reafirmaciones de la cabecera D7 hacen ese trabajo solos, porque nunca dejaron de hacerlo.
2. **El coste de CPU está acotado por construcción**, no por umbral: como máximo un reinicio por giro por ranura, `8000 × T_REINICIO` por segundo. Con `T_REINICIO` ESTIMADO 20 µs son 16 % de un núcleo por ranura con **todas** sus tramas colgándose, 96 % con las seis. Eso es el instrumento roto, y se acepta que un instrumento roto gaste CPU en intentar no estarlo. El presupuesto lo asevera como cota (§8). *(Solo los reinicios: el coste de un giro normal no está acotado por construcción. Su límite, firmado el 16-10, es de 2 500 ciclos por giro: ver la enmienda de D5.1 y el riesgo 9.)*
3. **La salud son dos marcas por ranura, calculadas sobre una ventana deslizante, y suben al instrumento:**
   - **`inestable`**: `plazos_vencidos` en la última `VENTANA_SALUD` (ESTIMADO 1 s) ≥ `UMBRAL_INESTABLE` (ESTIMADO 10). Es información, no acción: no cambia lo que la tarea hace.
   - **`muda`**: `subidas_malas` seguidas ≥ `UMBRAL_MUDA` (ESTIMADO 40, o sea 5 ms). Es el testigo que la v1 no tenía (V-10): la subida lleva el sobre con su CRC en cada giro (cabecera D6.1), así que el maestro sabe en cada giro si el módulo contestó bien. Un módulo muerto (MISO en pull-down, ceros) es `muda` en 5 ms aunque el periférico del cerebro dé `EOT` perfecto. `giros` mide *«mi periférico terminó»*; `subidas_ok` mide *«el módulo contestó»*; son dos cosas y se cuentan aparte.
   - Ninguna marca cambia la cadencia ni manda `HOLA`. `HOLA` se manda cuando la cabecera D5 dice: al muestrear `sesión = 0`. Una ranura `muda` no muestrea nada, así que no manda `HOLA`; sigue clocando lo que el planificador diga, y la marca sube.
4. **`Vacia`**: una ranura sin identidad por I²C (punto a punto D2: el descubrimiento precede a *«la primera palabra de SPI»*) no entra al lazo. No se cloca, no se cuenta, no tiene marcas. Sin esto, cada ranura vacía contaría `subidas_malas` a 8 kHz y daría la vuelta al `u32` en seis días de instrumento encendido (S-15). Entra al lazo cuando el descubrimiento le da identidad; sale cuando se la quita.
5. **Los contadores por ranura**, totales desde el arranque, `u32`: `giros`, `plazos_vencidos`, `eot_tardios`, `subidas_ok`, `subidas_malas`. No viajan por el J2: son del cerebro, los lee la pantalla y el registro de salud del cerebro, y se cruzan en el bring-up con `perdidas` y `rechazadas_*` del módulo (cabecera §3.3), que son la otra mitad de la misma historia.

**Lo que NO decide este papel:** qué hace el instrumento con una ranura `inestable` o `muda`. Retirar sus voces del reparto, avisar en pantalla, o seguir mandando: eso toca la política de partes y voces (`partes.rs`, `Repartidor`) y es decisión de otro papel (§6). Aquí las marcas **suben**, nada más.

### D8. Dónde vive el código, qué es cada pieza, y qué se contribuye upstream *(⚠ precisada: V-12, H-12)*

- **La política, en `core`**: `software/nucleo/core/src/maestro_j2.rs`. Una máquina por ranura, sin hardware, sin `async`: dos estados (`Vacia`, `Activa`), recibe eventos (`Identidad(Option<_>)`, `Armada`, `GiroOk`, `PlazoVencido`, `EotTardio`, `SubidaOk`, `SubidaMala`, `Tick`) y devuelve una acción (`Nada`, `Reiniciar`) y las marcas (`inestable`, `muda`). Los umbrales son un `struct Umbrales` con sus valores ESTIMADO y su fuente, parámetro del constructor. Se prueba entera en el host (§7).
- **El driver, en `fw`**: `software/nucleo/fw/src/j2_spi.rs`. Es lo que es: **un driver genérico de SPI maestro para `spi_v4`, con `TSIZE`, NSS por hardware, y las dos esperas cancelables**, escrito porque el de embassy no cancela. **No sabe nada del sobre.** Recibe un búfer de bajada, un búfer de subida y un largo; devuelve `Ok`, `PlazoVencido` o `EotTardio`. La v1 lo llamaba «el driver de nuestro bus propietario», y la junta señaló que eso era una etiqueta: cada rasgo del driver es del periférico, ninguno del J2. La frontera queda trazada: **`fw` cloca bytes; `core` sabe qué son.** Si la semántica del sobre alguna vez aparece en `j2_spi.rs`, es un defecto.
- **Los búferes de DMA viven en memoria no cacheable.** El Cortex-M55 del N657 tiene D-cache; un búfer de recepción cacheado da *«CRC bueno en el cable, basura en RAM»*, que es exactamente lo que el bring-up atribuiría al silicio (H-12). El plan de implementación elige entre región MPU no cacheable e invalidación explícita; este papel solo exige que sea una de las dos.
- **Upstream, dos cosas, en este orden:**
  1. **Un comentario en #5607** (§9, acción 1), ya redactado en el scratchpad de la sesión: que los dos reportes usan `SPI5` y nadie probó otra instancia; que el camino bloqueante y `write`/`transfer` van con `TSIZE = 0` y `read` no, así que `TSIZE` solo no discrimina; que p. 3492 dice que `EOT` se pone al rehabilitar y el driver no lo limpia tras `SPE = 1`, como hipótesis; y que ambos mueven el `CS` por GPIO, y si alguien lo vio con NSS por hardware. Y si la comparación con el HAL de C del 2026-06-24 se llegó a correr. Es una pregunta, no un parche. Sale con la cuenta de Samuel.
  2. **Un PR a embassy**, cuando haya Discovery: las dos esperas de `spi_v4`-`v6` como futuros (`EOTIE` para `EOT`; el `join` del DMA ya lo es) con un `with_timeout` opcional, y `TSIZE` en `write`/`transfer`. Si entra, `j2_spi.rs` se retira y el J2 vuelve a `embassy_stm32::spi`. No es tarea de este papel; es su cierre deseable.

---

## 3. Los números *(⚠ recalculados por S-9, S-10, H-3)*

Todo lo de esta sección lo asevera `recuperacion_j2_budget.py` (§8). Aquí, en prosa, con la fuente de cada cifra.

| Cifra | Valor | De dónde |
|---|---|---|
| Cadencia del lazo | 8 kHz, 125 µs por giro | `trama_j2_budget.F_LAZO_HZ` |
| Reloj del enlace, D8 | 34,5 MHz | `enlace_budget.F_PELDANO_2_HZ` |
| Reloj de hoy | 10 MHz, el piso | `sancion_j2.csv` vacío |
| Mensaje más largo | ≤ 100 µs al piso (cota); `SET` de 16 = 82,4 µs | `trama_j2_budget.T_MENSAJE_MAX_S` (R-E1); cabecera §4 |
| Plazo máximo por mensaje (D3) | 2 × 100 + 20 = **220 µs** (cota); 184,8 real | ESTIMADO (`FACTOR_PLAZO`, `T_SUELO_PLAZO`) |
| Reinicio del periférico (D4) | **20 µs**, ESTIMADO, sin «≤»: soltar los canales del GPDMA (sin cifra), el reset del SPI por RCC y dos registros (sin cifra); hasta la enmienda del 2026-10-14 era `T_SUSP` 10 en vez del reset | el bring-up lo mide |
| Recuperación, peor caso | plazo + reinicio + alineación al giro + un giro = 220 + 20 + 125 + 125 = **490 µs**, o sea **3 giros** | aritmética; la v1 decía 2 |
| Ventana del módulo | **~50 ms** = 400 giros | voz-total §9.2, ESTIMADO (*«N del plan»*) |
| **Margen** | 50 ms / 490 µs = **102×** | la cifra que este papel defiende; la v1 decía 200 |
| CPU de un giro normal, sin reinicio | **límite firmado el 16-10: 2 500 ciclos por giro** (15 % de un núcleo a 800 MHz, seis ranuras a 8 kHz). Medido en la Nucleo a 64 MHz: ~20 200 sin cachés, ~16 100 con I-cache; a 800 MHz con las dos cachés (exploración, sin MPU) ~8 000: **no cumple** | `carga_j2`, `carga_j2.csv`; riesgo 9 |
| CPU por reinicios, peor caso | 8000 × 20 µs = **16 % de un núcleo por ranura**, 96 % con las seis colgándose siempre | D7.2, cota por construcción |
| Corrupción con red (D6) | `TONO` viejo ≤ 1,0 ms a la tasa del hilo y a 100×; ≤ 2,0 ms a 10 000×; ≤ 2,75 ms a 1 trama de cada 100 | sim4 de la junta |
| Corrupción sin red (D6) | `P(golpe perdido) = 3 × P(EVENTO en un giro)` por cuelgue | función, sin cifra: los dos parámetros son de la Discovery y del músico |
| `u32` | 2³² / 8000 = 6,2 días de un evento por giro | solo importa con ranuras vacías contando, y D7.4 lo evita |

**La lectura:** el peor caso de un reinicio le cuesta al músico **tres giros**, cuatro décimas de milisegundo, y el módulo no se entera porque su watchdog está cien veces más lejos. Si el giro perdido llevaba un `EVENTO`, ese golpe se perdió, y eso es de la cabecera. Lo que sí se entera es el contador. Si el defecto del hilo sale en nuestro montaje con su período de 10-900 s, el instrumento suena igual y el registro dice cuántas veces se recuperó. Eso es lo que un fabricante quiere: **el fallo existe, está contado, y lo que puede no cruzar al músico, no cruza; lo que sí puede, está dicho.**

**Los 50 ms tienen dos caras, y este papel escribe solo una** *(⚠ V-7)*: voz-total los quiere pequeños (*«trama perdida ≠ sustain infinito»*: es el techo del sustain fantasma) y este papel los quiere grandes (es el piso del margen). El presupuesto asevera `recuperación × 10 < T_WATCHDOG_TRAMA`; la cota de arriba, cuánto sustain fantasma es tolerable, no está escrita en ningún papel y queda como HUECO de voz-total (§10).

---

## 4. Las reglas

- **R-MJ1.** Ninguna transferencia del J2 en el cerebro corre con `TSIZE = 0`. Falla al compilar: `TSIZE` sale de un `NonZeroU16`. Y `TSIZE` es el largo clocado de la cabecera §4, con relleno.
- **R-MJ2.** Ninguna espera del J2 en el cerebro es un bucle síncrono **sin cota**. Las dos esperas de la transferencia son futuros bajo plazo (D2); el sondeo de `SUSP` en D4 tenía cota escrita (`T_SUSP`; desapareció con la enmienda del 2026-10-14, que resetea por RCC); la espera del `Drop` del GPDMA tiene cota escrita (`T_CANAL`, D4.2, enmienda del 18-09) y escalada al reset del GPDMA1 por RCC. *(⚠ V-11, S-13: la v1 decía «ningún bucle» y su grep no habría visto ni el `Drop` ni `T_SUSP`)*
- **R-MJ3.** El reinicio del periférico sigue los pasos de D4 en ese orden, y cada paso cita su página. *(Eran ocho; desde la enmienda del 2026-10-14 son seis.)* No se escribe a `TXDR` para desatascar.
- **R-MJ4.** Los umbrales de D3 y D7 son parámetros, no literales. Viven en un solo `struct Umbrales` con sus valores ESTIMADO y su fuente, y `recuperacion_j2_budget.py` los lee de `maestro_j2.rs`, no los copia.
- **R-MJ5.** Cada ranura activa tiene su tarea, y las seis viven en el ejecutor del J2, no en el de hilo. Ninguna tarea del ejecutor de hilo puede retrasar un giro.
- **R-MJ6.** Una ranura sin identidad no se cloca ni se cuenta.
- **R-MJ7.** Los búferes de DMA del J2 están en memoria no cacheable o se invalidan antes de leerse. Una de las dos, dicha en el plan.
- **R-MJ8.** El bring-up de la Discovery registra la prueba de resistencia en `software/nucleo/fw/resistencia_j2.csv` con las columnas de §8, y el presupuesto sale con `HUECO` hasta que haya fila.

---

## 5. Qué muere, qué sobrevive, qué nace

**Muere:**
- La idea de que el J2 del cerebro use `embassy_stm32::spi::Spi` tal cual. Vive hasta que embassy tenga las dos esperas cancelables (D8.2).
- *«El bring-up lo sella»* como única respuesta al cuelgue del SPI. Ahora hay diseño antes del bring-up.
- **De la v1, por la junta**: el CRC de hardware del SPI; el vigía; la ranura enferma con sondeo lento; el IWDG alimentado por el J2; «el flanco realinea al esclavo».

**Sobrevive intacto:**
- Toda la cabecera del J2: sobre y su CRC, sesión, registros, `T_GAP`, el byte de cola, `NADA`. Este papel es un cliente suyo y le manda dos enmiendas de una línea (§10).
- El watchdog de trama del módulo y R-M5. Siguen siendo la red del otro lado.
- El reparto de pines del censo: el NSS por hardware ya estaba.

**Nace:**
- `maestro_j2.rs` en `core`, con sus tests.
- `j2_spi.rs` en `fw`, el driver genérico con esperas cancelables.
- El ejecutor del J2, con seis tareas.
- Cinco contadores y dos marcas por ranura en el estado del cerebro.
- `recuperacion_j2_budget.py` y `resistencia_j2.csv`.
- Dos requisitos al hub: el supervisor de vitalidad y el ejecutor del J2 (§10).

---

## 6. Lo que este papel NO decide, con su dueño

| Qué | Dueño |
|---|---|
| Qué hace el instrumento con una ranura `inestable` o `muda` (voces, pantalla) | Papel de la política de partes y voces; toca `partes.rs` y `Repartidor` |
| Las dos ranuras por USART síncrono: plazo, reinicio y cuenta con otro periférico | Su propio papel, cuando esas ranuras tengan módulo (§9, riesgo 7) |
| Quién alimenta el IWDG, con qué plazo, y cuánto silencio añade un reinicio del cerebro | El papel del hub (§10) |
| Cómo el módulo deja limpio su SPI al contar corto en el flanco | El papel del módulo (§10) |
| Si el defecto del N6 es de instancia o del bloque | Upstream (#5607) y la Discovery (#231) |
| El valor real de cada ESTIMADO de §3 | El bring-up, con osciloscopio y horas |
| La cota superior de los 50 ms (cuánto sustain fantasma es tolerable) | voz-total (§10) |
| Región MPU no cacheable o invalidación explícita para los búferes | El plan de implementación |
| La contribución upstream de las esperas cancelables | Su propio PR, cuando haya Discovery |

> **Enmienda del 2026-09-08 (§6, fila del alcance):** **cerrada por upstream
> el 2026-09-03 la pregunta de si el cuelgue es exclusivo de SPI5**. jake-taf
> respondió en [#5607](https://github.com/embassy-rs/embassy/issues/5607):
> *«I have observed this problem on SPI1 as well»*. El alcance observado ya
> abarca SPI5 y SPI1 (§1.1). Lo que sigue abierto es la **causa: silicio o
> driver**. Este cierre no acredita una reproducción en las seis instancias;
> el resultado en nuestro montaje con NSS por hardware sigue siendo HUECO
> de #231 (D1, §9 riesgo 1).

---

## 7. Los tests *(⚠ reescritos: la máquina de la v2 es más chica)*

Todos en `core`, sin hardware, sobre `maestro_j2.rs`. La numeración es la del plan que sigue a este papel.

1. **`Vacia` no cloca ni cuenta**: cualquier evento distinto de `Identidad(Some)` devuelve `Nada` y deja los contadores en cero.
2. **`Identidad(Some)` activa; `Identidad(None)` vacía** y conserva los contadores (son totales desde el arranque, no desde la identidad).
3. **`GiroOk` cuenta `giros`**; **`SubidaOk`/`SubidaMala` cuentan lo suyo** y no cambian la acción.
4. **`PlazoVencido` devuelve `Reiniciar`** y cuenta `plazos_vencidos`; el siguiente `GiroOk` cuenta como siempre (no hay estado intermedio que salir).
5. **`EotTardio` cuenta y no reinicia.**
6. **`inestable` sube al décimo `PlazoVencido` en un segundo** (`≥ UMBRAL_INESTABLE`; el décimo cabe justo, el noveno no) **y baja cuando la ventana desliza** (diez repartidos en más de un segundo no la suben).
7. **`muda` sube a las cuarenta `SubidaMala` seguidas y baja con una `SubidaOk`.**
8. **Las marcas nunca cambian la acción**: con `inestable` y `muda` puestas, `PlazoVencido` sigue devolviendo `Reiniciar` y `GiroOk` sigue devolviendo `Nada`.
9. **Los contadores son monótonos**: ningún evento los baja.
10. **`Umbrales` rechaza en construcción** `TSIZE` cero (R-MJ1 en el tipo) y `UMBRAL_MUDA × 125 µs ≥ T_WATCHDOG_TRAMA` (la marca tiene que subir antes de que el módulo suelte, o no sirve para avisar).
11. **Mutación**: seis máquinas independientes; un `PlazoVencido` en la ranura 3 no toca ninguna cuenta de las otras cinco.
12. **El presupuesto lee los umbrales del artefacto**: `recuperacion_j2_budget.py` falla si `struct Umbrales` cambia de forma o de nombre (R-MJ4).

---

## 8. Los guiones

**`hardware/02-midi-cv/recuperacion_j2_budget.py`** (nuevo). Importa `F_LAZO_HZ` y `T_MENSAJE_MAX_S` de `trama_j2_budget`, `F_PELDANO_2_HZ` de `enlace_budget`, y lee `struct Umbrales` de `maestro_j2.rs` por regex (como `pio_budget.py` leía `pinout.rs`). Declara `T_WATCHDOG_TRAMA_S = 50e-3` con su fuente y ESTIMADO, y `T_REINICIO_S = 20e-6` ESTIMADO. Asevera:

- `plazo(msg) ≤ FACTOR × T_MENSAJE_MAX + SUELO` para cada mensaje de la cabecera §4, al piso y a D8.
- `t_recuperacion = plazo_max + T_REINICIO + 2/F_LAZO` (alineación más un giro) y `t_recuperacion × 10 < T_WATCHDOG_TRAMA` (margen ≥ 10×; hoy da 102×).
- `UMBRAL_MUDA / F_LAZO < T_WATCHDOG_TRAMA` (la marca `muda` sube antes de que el módulo suelte).
- CPU por reinicios, peor caso: `F_LAZO × T_REINICIO` por ranura, impreso, sin aserto (es cota, no presupuesto).
- `P(golpe perdido por cuelgue) = 3 × p_evento`, impresa como función para `p_evento` en `{1e-3, 1e-2, 1e-1}`, sin aserto: los dos parámetros no son de este guion.
- `T_IWDG > T_WATCHDOG_TRAMA` **como requisito mandado al hub**, leído de donde el hub lo declare cuando lo declare; hasta entonces, HUECO impreso.

Sale con `2` (HUECO) mientras `resistencia_j2.csv` no tenga fila o el hub no declare `T_IWDG`; con `0` cuando los dos existan y los ESTIMADO se hayan sustituido; con `1` si algún aserto falla.

> **Enmienda del 2026-10-20 (#369): la fila se juzga, no se cuenta.** Contra el horizonte `H` de «cero artefactos audibles» (acta del 11-09, ficha 2), que Samuel fijó el 20-10 en **8 h**, un día entero de estudio o de concierto, por transferencia: cada plazo vencido, EOT tardío o subida mala cuenta como artefacto; los fallos cuentan de todas las filas y las transferencias solo de las filas al lazo del hub (≥ 0,9 × 8 kHz), sumadas entre ranuras. Sale con `1` si la tasa vista da un fallo o más en las `H` horas del instrumento (seis ranuras a 8 kHz); con `2` si falta `H` o si la cota de Poisson al 95 % todavía no queda por debajo de uno (y entonces imprime cuántas horas de soak faltan); la resistencia queda cubierta cuando sí queda. Con cero fallos, eso pide `3·H` horas limpias con las seis ranuras, o `18·H` con una: con `H = 8`, 24 h con seis, 48 h con tres (una Nucleo, tres pares maestro-esclavo) y 144 h con una.

**`software/nucleo/fw/resistencia_j2.csv`** (nuevo, vacío hasta la Discovery). Columnas: `ranura, instancia, tsize, nss, reloj_MHz, horas, giros, plazos_vencidos, eot_tardios, subidas_malas, fecha, placa`.

---

## 9. Riesgos, con su criterio de cierre

| # | Riesgo | Cierre |
|---|---|---|
| 1 | **El defecto del N6 sale igual con NSS por hardware.** No cambia el diseño (D4 lo cubre), pero sí la tasa y el desgaste | La Discovery, un enlace a 8 kHz durante ≥ 24 h, `resistencia_j2.csv` con fila. Si la tasa es del orden del hilo (período de minutos a horas), el diseño aguanta con margen de sobra; si es de varias por segundo, hay que mirar el driver de `fw` antes de culpar al silicio |
| 2 | **Los ESTIMADO de D3 se quedan cortos** y el plazo vence en tramas sanas (falsos reinicios) | Osciloscopio en el bring-up: `t_real(msg)` contra `t_nominal(msg)`; `FACTOR_PLAZO` se fija con ≥ 3× el peor exceso medido |
| 3 | **El módulo no limpia su SPI al contar corto** y arrastra medio byte: las tramas siguientes fallan CRC hasta que algo lo realinee | La enmienda al papel del módulo (§10) y su test: abortar una trama a mitad de byte desde el maestro y ver que la siguiente se acepta |
| 4 | ~~embassy-stm32 no expone lo que el driver propio necesita~~ | **Cerrado en la v2**: verificado en `main` (§1.2, último párrafo). Queda que compile, y eso es el primer paso del plan |
| 5 | **`EOT` se pone al rehabilitar** (p. 3492) y el orden `SPE = 1 → EOTC → EOTIE` de D2 no basta por alguna razón que el manual no dice | Bring-up: cien mil transferencias contando `eot_tardios` y `plazos_vencidos` con el bus al aire; si alguno sube sin cuelgue real, el orden se revisa |
| 6 | **El canal de GPDMA no responde al reset** y el `Drop` del `Transfer` de embassy se queda en su bucle | **Enmendado el 18-09:** cota `T_CANAL` al soltar y escalada al reset del GPDMA1 por RCC (D4.2), en vez de «lo cubre el IWDG». Cierra en la placa: inducir un canal trabado (pausarlo por registro desde otra tarea, con el bus al aire) y ver que las otras cinco ranuras siguen girando y que `escaladas_gpdma` sube en uno. *(2026-10-14: hasta hoy ese reset no ocurría, porque `enable_and_reset` se lo salta con el reloj encendido; ver la enmienda del 14-10 en D4)* |
| 7 | **Las dos ranuras por USART síncrono** no tienen plazo, reinicio ni cuenta | Su propio papel antes de que lleven módulo; hasta entonces son repuesto sin módulo, y el planificador las trata como `Vacia` |
| 8 | **Un búfer de DMA cacheado** da datos viejos con CRC bueno | R-MJ7 en el plan; el test de bring-up compara el búfer contra el analizador lógico |
| 9 | **El coste de CPU de un giro normal no cabe en el reparto firmado** (2 500 ciclos por giro, el 15 % de un núcleo a 800 MHz): medido en la Nucleo son ~20 200 sin cachés a 64 MHz y ~8 000 a 800 MHz con las dos cachés (exploración, sin MPU), 3,2 veces el límite, y el lazo que no cabe deja sin CPU al hilo | `carga_j2` con el reloj de diseño y las cachés del hub, anotado en `carga_j2.csv`: el cierre es una fila a 800 MHz con **≤ 2 500 ciclos por giro**. Mientras tanto, la sobrecarga acaba en un atraso contado (D5.1, enmienda del 16-10) y, con el IWDG alimentado desde el hilo, en un reinicio y no en un congelamiento |

**Acciones que este papel manda, baratas:**

1. **Comentar en #5607** con el borrador de D8.1. Sale con la cuenta de Samuel; se pide en la conversación.
2. **Añadir a #231** la prueba de resistencia y el osciloscopio de D3 como cuarta y quinta razón de la Discovery.
3. **Cerrar #287** cuando este papel se firme: sus puntos 1 a 3 quedan decididos aquí.

> **Enmienda del 2026-09-08 (§9, acción 1; D8.1):** **hecha el 2026-09-03**.
> Samuel publicó la pregunta en [#5607](https://github.com/embassy-rs/embassy/issues/5607)
> y jake-taf respondió ese mismo día. Este intercambio también supera el
> corte de actividad del 2026-06-24 citado en §0. Sobre C, la respuesta fue:
> *«We wrote some small test firmware for C, but had issues getting probe-rs working on C.»*
> No aporta un resultado de la comparación contra el HAL de C; ese resultado
> sigue siendo **HUECO**, y **silicio contra driver sigue sin dirimir**. La
> hipótesis del `EOT` releído (punto 3 de la pregunta, D8.1) no fue contestada.

> **Enmienda del 2026-09-11 (§9; acta del 11-09, firmada por Samuel en el artifact «Acta del J2»):**
>
> 1. **Puerta de fabricación** (ficha 1). Ninguna PCB con N657 sale al taller sin una fila medida en `resistencia_j2.csv`. Antes era criterio de cierre del riesgo 1; desde hoy es prohibición. `recuperacion_j2_budget.py` la imprime como condición y deja de devolver 2 fijo (#369).
> 2. **El límite que descarta al chip** (ficha 2): **cero artefactos audibles atribuibles al bus.** Samuel lo eligió sobre la opción que la junta recomendaba (≤ 1 por 10 h de toque, que equivalía a un cuelgue cada 49 s en el instrumento). Para ser medible necesita un **horizonte**, cero en cuántas horas de instrumento, que queda **HUECO** y es suyo. La aritmética que lo convierte en puerta: con cero eventos en T horas de soak, la tasa queda por debajo de 3/T al 95 % (regla de tres, Poisson); «cero en H horas» exige del orden de 3·H horas limpias con el control positivo hecho. El riesgo 1 deja de cerrar «con fila»: cierra cuando la cota medida multiplicada por H queda por debajo de uno.
> 3. **El soak no va primero: va el control positivo.** Un soak limpio no ejecuta D4 y no distingue «no nos afecta» de «el banco no lo ve». Orden del día de la placa (Halberg, H-7): (0) `SPE = 1` sin armar nada y leer `SR.EOT`; (1) reproducir la configuración de jake-taf (embassy, 100 kHz, CS por GPIO, `TSIZE = 0`, `blocking_read`), donde 1 h da 98 % de potencia contra el extremo suave del hilo; (2) barrido del retardo entre `SPE = 1` y `CSTART` en {0, ¼, ½, 1, 2, 4} × T_SCK en esa configuración; (3) nuestra configuración con el driver de embassy; (4) el driver propio; (5) el HAL de C de ST solo si queda un cuelgue que el propio no limpia. Con la tasa por armado, 15 min en una ranura contestan p < 4,2e-7 al 95 %; 24 h contestan la hipótesis por tiempo (λ < 0,125/h).
>
>    *Lectura del 18-09 (fase B, rulings R4 y R22), con el reloj corregido el 2026-09-19:* el barrido del retardo (2) corre sobre **la configuración con `EOT`** (`TSIZE > 0`, NSS por hardware, el driver propio), no sobre la de jake-taf: el mecanismo de ES0396 §2.14.2 necesita eventos `EOT`, y con `TSIZE = 0` no los hay (es el tercer workaround de esa misma errata). Y el control positivo (1) corre a **125 kHz**, no a 100 ni a los 250 que dijo la primera redacción: el kernel del SPI5 **no es el HSI de 64 MHz, es `pclk2` y son 32**. El mux se queda en su cero —`ClockMux::default()` es `mem::zeroed()` (`_generated.rs:5317-5319`) e `init()` escribe `set_spi5sel` incondicionalmente (`:5397`)— y ese cero es `Spisel45::Pclk2` (metapac `rcc_n6.rs:43346-43348`); `pclk2` es `sys / hpre / ppre2` (embassy `rcc/n6.rs:462`, publicado en `:1413`), y con los defectos que `usb::configuracion()` no toca (`sys: Hsi`, `ahb: Div2`, `apb2: Div1`) eso es 64 / 2 / 1 = 32 MHz. Con 32 MHz el divisor máximo de `MBR`, /256, da 125 kHz. La hipótesis por tiempo (un cuelgue cada ~900 s) no cambia y la por armado gana potencia; **la variante «plan B a 125 kHz» que decía esta lectura se retira: 125 kHz es ya lo que sale por defecto**, sin tocar el mux.
>
>    *Medido el 2026-10-01 en la NUCLEO-N657X0-Q* (firmware `ca07f94`; el `-sucio` de la línea de arranque son cuatro PNG borrados en `case/renders`, nada del firmware): **64 minutos, 6 643 199 lecturas de 8 bytes a 125 kHz, 0 cuelgues.** El ritmo no se movió: 103 800 lecturas en cada minuto. **El control positivo no dio positivo.** Eso no dice que el N657 esté libre del defecto; dice que el banco todavía no ha demostrado que lo ve. El cero pesa distinto según contra qué período del hilo se lea:
>
>    - Contra el **primer reporte** de [#5607](https://github.com/embassy-rs/embassy/issues/5607) (*«after running the below test code snippet for 10-900 seconds»*, embassy `3651d8ef`, marzo, en la DK): se esperaban 4,3 cuelgues en 64 min, y ver cero tiene un 1,4 % de probabilidad. Esa tasa no está en este banco.
>    - Contra lo que **jake-taf** midió después, con builds más nuevos (*«anywhere from several minutes to two hours»*, 2026-05-14; *«every 30-120 minutes regardless of how often I write/read to SPI»*, 2026-05-26): se esperaban entre 0,5 y 2,1, y ver cero tiene entre un 12 % y un 59 %. **Una hora no contesta.** El «98 % de potencia» de este punto se calculó contra los 900 s del primer reporte; contra 120 min hacen falta unas 6 h para el 95 % (120 min × ln 20, la misma regla de tres del punto 2).
>    - **El repro no fue tal cual**, en tres cosas. El reloj: 125 kHz contra 100, ya dicho arriba. El bucle: aquí `CS` + `blocking_read` de 8 bytes; el del primer reporte es `CS` + `write` de 2 bytes + `read` de 1 + dos `info!` por vuelta. Y el driver: el `spi/mod.rs` de embassy lleva 22 commits después del `24e5731` que jake-taf reporta el 2026-06-12, entre ellos `60681501c` (2026-06-08, *«delay receive until corresponding rx»*), que toca el camino de recepción de `transfer_words`. El MISO al aire **no** es diferencia: el primer reporte dice *«It happens even when nothing is connected to the SPI bus»*.
>
>    Qué se hace con un control que no dio positivo lo decidió Samuel el mismo día, entre tres opciones (A: el mismo binario 6 h; B: el bucle del primer reporte 6 h; C: preguntarle a jake-taf en #5607 si con el embassy de hoy se le sigue colgando):
>
>    > «vamos a hacer las tres cosas. empezando desde ya mismo»
>
>    A y B van en fila porque la placa es una sola. Con A ya en marcha, Samuel dijo: «haremos hasta A, B lo lanzaremos mañana». B va con `--features bucle-del-reporte` (EN-PLACA, punto (1)). C salió a las 14:20 (12:20 UTC), con la cuenta de Samuel: [comentario en #5607](https://github.com/embassy-rs/embassy/issues/5607#issuecomment-5931298173), con la (0), esta (1) y la pregunta.
>
>    **A, medida el 2026-10-01** (firmware `4d2d6f2`, el mismo `-sucio` de los PNG; de 14:12:21 a 20:13:51): **358 minutos, 37 160 399 lecturas, 0 cuelgues y 0 líneas de error.** Las 358 filas del log van seguidas y todas con las mismas 103 800 lecturas. Faltan las filas 359 y 360. *Corregido el 2026-10-04:* no fue el búfer, fue el reloj de la placa. Su HSI va entre un 0,82 % y un 0,85 % lento contra el reloj de la PC: en cuatro corridas, la última fila de cada log se escribe a los 361,1, 361,0, 60,5 y 804,8 minutos reales para 358, 358, 60 y 798 minutos de la placa. Eso cae dentro de los ±5 % de DS14791 Rev 10, p. 165. En los 361,5 minutos que duró la corrida, la placa contó 358. Con 0 cuelgues en 358 min, la probabilidad de verlo si el periodo medio fuera de 15 min es 4e-11; de 30 min, 6,6e-6; de 60 min, 0,26 %; de 120 min, 5 %. **Un cuelgue cada 2 horas o menos queda descartado al 95 %** (regla de tres: un periodo medio de ≥ 119 min), en esta configuración y esta placa. Eso cubre casi entero el rango «every 30-120 minutes» de jake-taf. No dice que el defecto no exista: puede ser más raro, depender del bucle del primer reporte (B) o de algo de su montaje.
>
>    **La respuesta de jake-taf a C** (el mismo día, en el hilo): «Good question, I recently updated to the latest embassy yesterday, so let me rerun and see» (13:23 UTC) y «I’ll do a run overnight and report back in the morning to see if any stalls occurred» (15:47 UTC).
>
>    **B, medida el 2026-10-02** (firmware `7a01671`, `-sucio` por los PNG; de 09:45:24 a 15:46:54): **358 minutos, 78 174 777 vueltas, 0 cuelgues y 0 líneas de error.** Cada vuelta arma el periférico dos veces. Hubo entre 218 364 y 218 366 vueltas en cada minuto.
>
>    **El resultado de jake-taf, el 2026-10-02** (13:13 UTC), con `main` de hace unos dos días: «Unfortunately I still have SPI issues on `main` (from ~2 days ago). I saw `SPI1` lock up five times overnight. I also regularly get CRC errors reading SPI, though I haven't looked to see if those are the bit smear issue.» Son cinco bloqueos en 14,1 h, a las 5,5, 5,9, 6,0, 6,1 y 13,3 h de encendido, con el reloj «set to 100kHz still». Embassy no lo arregló, así que su versión sale de la lista de diferencias entre los dos bancos. Las que quedan: su montaje lleva un chip real con CRC al otro lado, un vigía propio y SPI1.
>
>    **El eco, decidido por Samuel el 2026-10-02** (EN-PLACA, punto (1)). Es un puente de D12 (MISO, PG1) a D11 (MOSI, PG2) a 16 MHz, lo más rápido que da el kernel de hoy, con `blocking_transfer` de 8 bytes y un patrón distinto en cada vuelta. **Medido el 2026-10-03 y 04** (firmware `fea2a17`) en dos corridas:
>
>    - una hora, de 12:58 a 14:00, con 56 807 737 vueltas;
>    - una noche, de 14:13 a 03:38 del día 04, con 798 minutos de placa y 755 542 592 vueltas. La cortó Samuel al desconectar CN10 sin querer, 15 s después de la última fila.
>
>    **Las dos dieron 0 corrupciones, 0 errores del driver y 0 cuelgues.** En total son 6 499 millones de bytes comparados uno por uno.
>
>    **La lectura, por tiempo.** Contra el ritmo de jake-taf (5 en 14,1 h), la noche sola daría cero con un 0,9 %, contado con el tiempo de la placa, que es el más corto. Las cuatro corridas juntas (1 574 minutos de placa, 26,2 h) darían cero con un 0,009 %, pero solo si el ritmo no dependiera del bucle ni del reloj, que es lo que él dijo el 26-05 («regardless of how often I write/read to SPI»). La noche pasó por su ventana de 5,5-6,1 h.
>
>    **La lectura, por corrupción.** Su «once or twice a minute» de junio habría dado del orden de 860 corrupciones en 858 minutos. Cero las acota por debajo de una cada ~4,8 h al 95 %, o p < 3,7e-9 por vuelta.
>
>    **Lo que él ve no aparece en este banco**, y eso no dice por qué. Puede ser su montaje: su vigía detecta por tiempo y puede contar como cuelgue una tarea que solo se retrasó; además está su chip del otro lado, SPI1 y su programa. O puede ser algo que este banco no ejercita: DMA, `TSIZE > 0`, NSS por hardware y el bus a 400 MHz del hub. Eso último es el punto (3) del orden del día. **El control positivo sigue sin dar positivo**, y la frase del acta sigue en pie: un soak limpio no distingue «no nos afecta» de «el banco no lo ve».
>
>    **(2) El barrido, primer intento, el 2026-10-14** (firmware `856b580`, desde las 09:55): **medida inválida.** El primer punto (retardo 0) dio `armados=2132419, plazos_vencidos=2132418, eot_tardios=0, subidas_malas=0, escaladas=0, tramas_cortas=0`: vencieron plazo todos los giros menos el primero. No fue el silicio. Fueron dos defectos del driver propio, encadenados (enmiendas del 14-10 en D2 y D4): el `TXTF` sin limpiar hizo vencer el segundo giro, y el reinicio con `CSUSP` de ese giro dejó el SPI sin poder arrancar hasta el corte de corriente. El esclavo no contó ninguna trama corta porque el maestro no llegó a arrancar ninguna trama y nunca bajó el `CS`. La corrida se paró a las 10:11. Con los dos arreglos, 20 000 giros seguidos salen bien. **Lo que esto dice del driver:** nunca había girado en placa con el esclavo, y si el defecto del N6 hubiera aparecido en el instrumento, su primer reinicio habría dejado la ranura sin enlace hasta apagar. El IWDG no lo habría visto, porque el sello sube al armar (D5.4; comentario del 11-09 en #291).
>
>    **La cadencia del banco no es 8 kHz.** Medido con los arreglos: cada giro tarda entre 281 y 351 µs (335 de media) con el reloj de hoy (HSI de 64 MHz, bus a 32, sin cachés), y entre 212 y 273 µs (250) con la I-cache encendida. Contra los 125 µs del periodo, el lazo gira a unos 2,6 kHz: en 15 minutos son unos 2,4 millones de armados, no los 7,2 que supone el acta, y la cota por punto sale p < 1,3e-6 al 95 %, no 4,2e-7. Lo que mide el barrido, la tasa por armado según el retardo, no cambia; su potencia sí. Para la del acta hacen falta 45 minutos por punto, y Samuel los eligió el mismo día («dale»).
>
>    **(2) El barrido, medido el 2026-10-14** (firmware `c88c1bb`, de 12:03:50 a 16:36:52, un solo `probe-rs` sin reenganches): **los seis puntos, 0 fallas de cualquier tipo.**
>
>    | Retardo (cuartos de T_SCK) | Armados | Plazos vencidos | EOT tardíos | Subidas malas | Escaladas | Tramas cortas |
>    |---|---|---|---|---|---|---|
>    | 0 | 7 454 090 | 0 | 0 | 0 | 0 | 0 |
>    | 1 | 7 455 622 | 0 | 0 | 0 | 0 | 0 |
>    | 2 | 7 455 615 | 0 | 0 | 0 | 0 | 0 |
>    | 4 | 7 431 075 | 0 | 0 | 0 | 0 | 0 |
>    | 8 | 7 452 480 | 0 | 0 | 0 | 0 | 0 |
>    | 16 | 7 432 201 | 0 | 0 | 0 | 0 | 0 |
>
>    Son 44 681 083 transferencias con `TSIZE > 0`, DMA y NSS por hardware. Cada punto acota la tasa por armado por debajo de 4,1e-7 al 95 %, la cota del acta, y no hay tasa que dependa del retardo porque no hubo ningún fallo. Es lo que anticipaba la medida (0) de la enmienda del 11-09 a D2: prender no levanta `EOT`, así que el `EOT` que precede a cada `CSTART` es el del giro anterior, a unos 360 µs, lejos de la ventana de un ciclo de SCK de la errata 2.14.2. **Lo que este banco no ejercita** es la razón de relojes del instrumento: aquí `pclk` va a 32 MHz y el SCK a 8, cuatro veces, y la errata habla de *«system clock (spi_pclk) substantially faster than SCK»*. El hub los separará más (#380 y el papel de relojes del hub), y ahí es donde la pregunta sigue abierta.
>
>    **El soak de 24 h (`resistencia_j2`), medido del 2026-10-16 al 17** (firmware `b9f6d7d`, de 09:17:53 a 09:31:14, un solo `probe-rs` sin reenganches; ranura 0 en SPI5 y esclavo en SPI4, SCK a 8 MHz): **86 399 999 giros y 86 400 001 tramas en el esclavo, con cero plazos vencidos, cero EOT tardíos, cero subidas malas, cero tramas cortas y cero rearmes escalados**; `inestable = false`, `muda = false`. Por la regla de tres, la tasa queda por debajo de 3,5e-8 por transferencia y de 0,125 por hora al 95 %; contra el ritmo de jake-taf (5 bloqueos en 14,1 h), cero en 24 h tendría una probabilidad de 2e-4 si su tasa dependiera del tiempo. **Es la fila de `resistencia_j2.csv`, y vale para 1 kHz** (D5.1, enmienda del 16-10), con `pclk` a 32 MHz y SCK a 8: no ejerce los 8 kHz ni la razón de relojes del hub, y no ejecutó D4 ni una vez, porque no hubo un solo plazo vencido. Hubo cuatro atrasos, un fallo del presupuesto de CPU y no del módulo, todos entre las 10:18 y las 15:20 del 16-10 y ninguno en las 18 horas siguientes; no se conoce la causa. `recuperacion_j2_budget.py` deja de decir que no hay fila y pasa a decir que la que hay es de 1 kHz.
>
>    **El soak de 144 h a 8 kHz por el tic, medido del 2026-10-21 al 27** (firmware `417afe0`, de 12:36:18 a 11:37:39, desde una Raspberry Pi, un solo `probe-rs` sin reenganches; ranura 0 en SPI5 y esclavo en SPI4, núcleo a 800 MHz con las dos cachés, SCK a 6,25 MHz): **4 147 199 999 giros con cero plazos vencidos, cero EOT tardíos y cero subidas malas**, 145 filas por hora sin saltos, todos los testigos del tic en cero (`latencia_plan_max_us` = 7), `atrasos = 0`, `inestable = false` y `muda = false`. Por la regla de tres, la tasa queda por debajo de 7,2e-10 por transferencia al 95 %. **Es la segunda fila de `resistencia_j2.csv` y la primera que vale para 8 kHz**: cubre el horizonte de 8 h con un 0,14 % de sobra (hacían falta 4,141e9 giros). No dice nada de las seis ranuras a la vez (la puerta las extrapola por transferencia), no ejecutó D4 (cero recuperaciones) y no ejerce la razón de relojes del hub (#380).
>
>    **El cuarto comentario en #5607, el 2026-10-14** ([enlace](https://github.com/embassy-rs/embassy/issues/5607#issuecomment-6175099736)): el barrido de los seis puntos con su tabla y los tres defectos del driver propio que dieron la primera medida inválida (el `TXTF` sin limpiar, el `CSUSP` seguido de `SPE = 0` que deja el SPI sin arrancar, y `rcc::enable_and_reset`, que no resetea un periférico cuyo reloj ya está encendido). Le pide a jake-taf `SR` (con `CTSIZE`), `CR1` y `CR2` en el momento del bloqueo. Sin respuesta al 2026-10-17: su último mensaje en el hilo es del 2026-10-02.
> 4. **El criterio del riesgo 5 no discrimina.** Cien mil transferencias son 12,5 s a 8 kHz y acotan p < 3e-5 al 95 %, que no excluye ni el peor extremo del hilo (2e-5). El binario `eot_al_aire` de `EN-PLACA.md` pasa a ser el barrido del punto 3.
> 5. **Acción 1, segunda vez, hecha el 2026-09-11.** Samuel publicó en [#5607](https://github.com/embassy-rs/embassy/issues/5607#issuecomment-5636099116) que ES0620 Rev 5 no lista el SPI, la errata 2.14.2 del H7 como hipótesis con su cálculo, el §2.2.1 del N657, las dos comprobaciones baratas del punto 3, y la pregunta de si alguien abrió caso con ST por el canal formal. Sin respuesta al cierre de esta enmienda.
> 6. **ES0620 Rev 5 leída y versionada** (`docs/reference/datasheets/stm32n6-es0620-rev5.pdf`, PR #365): ningún ítem del SPI; tres que tocan este proyecto: §2.2.1 (#363), §2.2.22 (#364), §2.15.1 (#350). El riesgo «errata joven» de los papeles del motor se cerraba midiendo arranque, no leyendo la errata: #370.
> 7. **Lo que la junta encontró fuera del alcance de este papel**, con issue: el esclavo N657 sin recuperación (#366); los tres buses SPI del CV sin papel (#367); el `Drop` del GPDMA sin cota que congela las seis ranuras, riesgo 6 (#368); el `EVENTO` que sí tiene red y se repara tarde y a fuerza máxima, contra lo que dicen D4.8, D6 y §3 (#371, enmienda pendiente a este papel); y el sello de vitalidad al armar que ciega al IWDG ante una ranura que se rearma para siempre (comentario en #291).

---

## 10. El mapa de enmiendas

| Papel | Sección | Tipo | Qué | Vehículo | Estado |
|---|---|---|---|---|---|
| hub N657 | §10 fila 6 (*«Drivers de embassy-stm32 para el N6 (SPI, ...)»*) | Expand | Para el SPI: embassy lo tiene y expone lo necesario, pero sus dos esperas no son cancelables y `write`/`transfer` van con `TSIZE = 0`; el J2 lleva driver propio hasta D8.2 | este papel | pendiente |
| hub N657 | nueva: el supervisor de vitalidad | Add | Quién alimenta el IWDG, con qué sellos y con qué plazo; requisito del J2: `T_IWDG > T_WATCHDOG_TRAMA` y un sello por ranura activa al armar. Y el silencio que añade un reinicio del cerebro, cuantificado | papel del hub | pendiente |
| hub N657 | nueva: los ejecutores | Add | El J2 vive en un `InterruptExecutor` propio por encima del de hilo; qué más va ahí y qué se queda en el hilo | papel del hub | pendiente |
| cabecera J2 | D8 (*«el esclavo rearma el DMA de recepción antes de validar nada»*) | Patch | Antes de rearmar, al contar corto en el flanco: `SPE = 0 → SPE = 1` en el SPI del módulo (RM p. 3450: *«any ongoing data are lost when disabling the SPI»*). Una línea en la ISR | papel del módulo / cabecera | pendiente |
| cabecera J2 | §3.3 (`perdidas ≥ rechazadas`) | Clarify | Del lado del cerebro, `plazos_vencidos + eot_tardios` son las tramas que el cerebro abortó o dio por abortadas; `perdidas − rechazadas − plazos_vencidos` es lo que de verdad se perdió por el cable. Los `eot_tardios` sí llegaron al módulo | este papel | pendiente |
| voz-total | §9.2 (*«N del plan, ~50»*) | Patch | El watchdog de trama gana un cliente del otro lado: es la ventana de recuperación del maestro. `N` pasa a constante importable (`T_WATCHDOG_TRAMA_S`), hoy ESTIMADO 50 ms, **con dos cotas**: piso del margen (este papel, ≥ 10 × recuperación) y techo del sustain fantasma (voz-total, HUECO) | PR de nivelación | pendiente |
| J2 punto a punto | *«(oyentes, la recuperación): del papel que reemplace al #201»* | Sync | La recuperación del lado del maestro está aquí; la del #201 (la Voz sin maestro) sigue donde estaba | este papel | pendiente |
| `micro_budget.py` | censo del hub, `J2:SPIn_NSS` | Clarify | El NSS por hardware pasa de reparto a **requisito**: sin él, D1 no se sostiene. Y las dos ranuras USART quedan fuera de este papel | comentario en el guion | pendiente |
| #250 | «Lo que hay que tocar» | Sync | El puerto incluye `j2_spi.rs`, el ejecutor del J2, los búferes no cacheables (R-MJ7); y el primer paso es compilar un `j2_spi.rs` vacío contra las cuatro APIs de §1.2 | issue | pendiente |
| #231 | la lista de lo que la Discovery mide | Expand | La prueba de resistencia (riesgo 1), el osciloscopio de D3 (riesgo 2), y el conteo de `eot_tardios` con el bus al aire (riesgo 5) | issue | pendiente |
| #287 | — | Cierra | Puntos 1 a 3 decididos aquí | `gh issue close` al firmar | hecho |
| **este papel** (11-09) | D2, el orden de arranque | Patch | Espera anclada ≥ 1 T_SCK entre `SPE = 1` leído de vuelta y `CSTART`, por analogía con ES0396 §2.14.2 del H7; ES0620 no lista el SPI | enmienda del 11-09 en D2 | **aplicada** |
| **este papel** (11-09) | §9 riesgos 1 y 5, acción 1 | Expand | Puerta de fabricación; límite de cero artefactos audibles con horizonte HUECO; control positivo antes del soak; el criterio del riesgo 5 no discrimina; segundo comentario en #5607 | enmienda del 11-09 en §9 | **aplicada** |
| **este papel** (11-09) | D4.8, D6, §3 («`EVENTO` no tiene red») | Patch | La cabecera da red al `EVENTO` (`COMPUERTA`, R-E11) y el evento repara a `u16::MAX` sin tono de arranque: la degradación es otra y la función de §3 cambia | #371 | pendiente |
| **este papel** (11-09 → 18-09) | D4.2, R-MJ2, §9 riesgo 6 | Patch | Cota `T_CANAL` al soltar los canales (`request_pause` + sondeo; NO `request_reset`, que ya trae el bucle sin cota) y escalada al reset del GPDMA1 por RCC, en vez de «lo cubre el IWDG»; no un ejecutor aparte; #368 | enmienda del 18-09 en D4.2, corregida el mismo día | **aplicada** |
| **este papel** (18-09) | D2 regla 1 | Clarify | La generación no puede rechazar nada por sí sola (el EOT no viene etiquetado); la protege la regla 2 + EOTIE + `NVIC::unpend` en D4.1 y D4.7 | enmienda del 18-09 en D2 | **aplicada** |
| **este papel** (18-09) | D5.1, §3 | Patch | Tras un plazo vencido la ranura se realinea (`Ticker::reset`), no recupera tics: honra `T_GAP` (cabecera D8) y mantiene los 490 µs | enmienda del 18-09 en D5 | **aplicada** |
| **este papel** (18-09 → 19-09) | §9, enmienda del 11-09, punto 3 | Clarify | El barrido corre sobre la configuración con `EOT`; el control positivo a **125 kHz**, no 100 ni 250: el kernel del SPI5 es `pclk2` = 32 MHz, no el HSI de 64 (el mux se queda en su cero, que es `Pclk2`). Se retira el «plan B a 125 kHz», que es lo que sale por defecto | lectura del 18-09 en §9, corregida el 19-09 | **aplicada** |
| **este papel** (19-09) | D3, §3 | Clarify | Con el kernel real (32 MHz) el `f_sck` del piso es 8, no 10: el `SET` de dieciséis dura 103 µs (> 100 de R-E1) y su plazo sale 226 µs (> 220, la cota de D3). El driver usa el reloj real y lo publica; elegir el piso es el #380 | nota del 19-09 bajo D3 | **aplicada** |
| **este papel** (19-09) | §9 riesgo 1, D8 | Clarify | El peldaño 2 (34,5 MHz) **no es alcanzable** con el kernel de hoy: `MBR` mínimo /2 sobre 32 MHz da 16. La segunda tanda del soak mide 16 MHz y la columna `reloj_MHz` lo dice; el arreglo es #150 y se decide en #380 | R24, declarado en `resistencia_j2.rs` y `EN-PLACA.md` | **declarado** |
| **este papel** (14-10) | D2, el orden de arranque | Patch | `TXTFC` al armar: `TXTF` no se limpia solo, y con él puesto el GPDMA no pide datos; medido en placa | enmienda del 14-10 en D2 | **aplicada** |
| **este papel** (14-10) | D4 pasos 3 a 7, D4.2, R-MJ2, R-MJ3, §3, §9 riesgo 6 | Rewrite | El reinicio resetea el SPI por RCC en vez de `CSUSP` + apagado, que lo dejaba muerto; la escalada del GPDMA1 resetea de verdad (`disable` + `enable_and_reset`); `T_SUSP` desaparece. Contesta los hallazgos 9 y 15 de Serrano | enmienda del 14-10 en D4 | **aplicada** |
| **este papel** (14-10) | §9, enmienda del 11-09, punto 3 | Expand | Barrido, primer intento inválido; la cadencia real del banco es de unos 2,6 kHz, no 8, y la cota por punto de 15 min baja a p < 1,3e-6; el barrido pasa a 45 min por punto para conservar p < 4,2e-7 | enmienda del 14-10 en §9 | **aplicada** |
| **este papel** (14-10) | §9, enmienda del 11-09, punto 3 | Expand | El barrido medido: seis puntos de 45 min, 44,7 millones de transferencias y 0 fallas; con esta razón de relojes (`pclk` cuatro veces el SCK) la tasa no depende del retardo | enmienda del 14-10 en §9 | **aplicada** |
| **este papel** (16-10) | D5.1, D5.4, D7.2, §3, §9 riesgo 9 | Patch | El calendario deja un periodo de hueco y cuenta un atraso cuando el giro se pasa; el periodo del banco puede alargarse; el esclavo nace antes que el maestro; el coste de CPU de un giro normal, medido y sin presupuesto | enmienda del 16-10 en D5 | **aplicada** |
| **este papel** (16-10) | D5.1, D7.2, §3, §9 riesgo 9 | Patch | El reparto de CPU del J2 queda firmado: 15 % de un núcleo a 800 MHz, 2 500 ciclos por giro; `recuperacion_j2_budget.py` lo lee y compara con `carga_j2.csv` | enmienda del 16-10 en D5 | **aplicada** |
| **este papel** (17-10) | D5.1, §3, §9 riesgo 9 | Patch | Las cifras de CPU de un giro, medidas con una base del hilo por estado de caché (la de I-cache del 16-10 salía de menos); la exploración a 800 MHz: 8 000 ciclos por giro con cachés, contra el límite de 2 500 | enmienda del 16-10 en D5, `EN-PLACA.md` | **aplicada** |
| **este papel** (17-10) | D5.1, §3, riesgo 9 | Clarify | El acta del 17-10: qué cuenta contra los 2 500 ciclos, el 15 % provisional hasta el censo del hub, y el prototipo de banco del transporte «por tic» | acta de la junta del transporte | **aplicada** |
| **este papel** (19-10) | D4.2, D5.1, R-MJ4 | Clarify | Las dos actas del 19-10: el transporte por tic como el diseño que se construye, la regla de la escalada, las cotas con sus dos dependencias de fuera del J2, el J2 en TCM y la cifra del censo | actas de la junta del transporte | **aplicada** (el texto de D2 a D8 se reescribe al cumplirse §5.2 del papel) |
| cabecera J2 | D2 y D9 (el CRC del sobre «con la unidad») | Patch | En el cerebro, una tabla de 256 entradas en la DTCM; la unidad queda para el receptor del módulo | enmienda del 19-10 en D2 de la cabecera | **aplicada** |
| voz-total | §9.2 (`T_WATCHDOG_TRAMA`) | Clarify | Las cotas de la ficha C del 19-10 dependen de 50 ms ± 2 %: si baja de ~41 ms, la ficha vuelve a la mesa | papel de voz-total | pendiente |
| censo del hub | R-H6, la tabla de obligaciones de tiempo | Add | Excluir la saturación sostenida de las interrupciones de nivel 2 (~94 % durante ~100 ms), que encadena incidentes sin que el aserto del módulo lo vea | #443 | pendiente |
| **este papel** (17-10) | §9 riesgo 1, acción 1 | Expand | El soak de 24 h a 1 kHz medido (86,4 millones de giros, cero fallos) y el cuarto comentario en #5607 | enmienda del 11-09 en §9, punto 3 | **aplicada** |
| **este papel** (27-10) | §9 riesgo 1, acción 1 | Expand | El soak de 144 h a 8 kHz por el tic medido (4 147 199 999 giros, cero fallos): la primera fila que cuenta para el horizonte de 8 h | enmienda del 11-09 en §9, punto 3 | **aplicada** |
| hub N657 | supervisor de vitalidad (D5.4) | Patch | El IWDG se alimenta desde el hilo, a la prioridad más baja, después de comprobar el sello de las ranuras: el sello subía con el hilo muerto | comentario del 16-10 en #291 | pendiente |
| papel del módulo | nueva: recuperación del esclavo | Add | Plazo, reinicio y cuenta del lado esclavo, espejo de D2-D4; y la política de `muda` en el cerebro | #366 | pendiente |
| motor-digital | §5, los tres buses SPI del CV | Add | Papel de recuperación de los buses del tono y censo de todos los maestros SPI con su consecuencia audible | #367 | pendiente |
| hub N657 | supervisor de vitalidad (D5.4) | Patch | El sello no puede ser «armé»: «armé y alguno de los últimos N terminó», o el supervisor lee `inestable`/`muda` | comentario del 11-09 en #291 | pendiente |
| `recuperacion_j2_budget.py` | `demo()` | Rewrite | `return` calculado, no fijo: lee la fila, cota 3/T, horizonte, puerta de fabricación impresa | #369 | pendiente |
| `EN-PLACA.md` | «El J2 en la Discovery» | Expand | Control positivo primero; `eot_al_aire` pasa a barrido del retardo; límite cero; prioridad de la ISR; método de reset de probe-rs | enmienda del 11-09 | **aplicada** |
| plan 2026-09-04 | Fase B | Sync | Desbloqueada el 08-09 (#349); enmiendas antes del driver; `spi_v5` | enmienda del 11-09 | **aplicada** |
| #231 | la lista de lo que la Discovery mide | Expand | Sexta razón: el soak es puerta de fabricación; la Nucleo ahora; control positivo primero; HUECOS: costo puesto en la puerta y los dos extremos en una placa | comentario del 11-09 | **hecho** |
| `references.md` y el árbol | erratas | Add | Regla: ningún papel se firma sobre un periférico sin su errata versionada; faltan RA8M1 y H750; barrido de ES0620 contra los papeles vivos | #370 | pendiente |

---

## 11. Registro de la junta

Tres lentes sobre la v1, el mismo día, antes de pedir la firma (memoria del 02-09: *«el orden bueno es brief → papel → junta → firma»*). Serrano (S), clínica, con la aritmética recalculada y las diecisiete citas del RM verificadas contra el volcado; Halberg (H), runtime con cinco simulaciones en Python (scratchpad de la sesión, `junta_halberg/sim1`, `sim1b`, `sim2`, `sim3`, `sim4`); Voronov (V), ontológica.

| Hallazgo | Qué cazó | Resolución |
|---|---|---|
| **S-1** BLOCKER, **V-1** BLOQUEANTE, **H-4** BLOCKER | El CRC de hardware del SPI rompía el sobre en las dos direcciones: trama CRC aparte tras `TSIZE`, y `CRCE` en cada giro de subida. La cabecera D2 ya lo había descartado | D1: `CRCEN = 0`; el CRC es el del sobre; «los tres van juntos» → los dos |
| **S-2** HIGH | §1.2 leía embassy al revés: `read` es la que fija `TSIZE`, `write` y `transfer` no; el cuelgue DMA del hilo fue en `read` con `TSIZE > 0` | §1.1 y §1.2 corregidos; D1 «por qué importa» reducido a lo que el código sostiene (NSS); comentario upstream reescrito |
| **S-3** BLOCKER de forma | La cita de p. 3484 llevaba «(...)» y el acta juraba citas enteras; la Tabla 661 iba como cita con guiones | D4.5: la cita entera; D2: la tabla como tabla |
| **S-4** HIGH | El reinicio omitía el paso 3 del manual (`TXDMAEN`/`RXDMAEN`), encendía al final sin poder armar, y el atajo de `SUSP` apagaba con la suspensión a medias | D4: ocho pasos en orden; termina apagado; `SUSPC` incondicional; D2: el SPI apagado entre transferencias |
| **S-5** HIGH, **V-9** MEDIA | «El flanco lo realinea» citaba al esclavo recién habilitado; nada decía qué pasa con medio byte en el esclavo interrumpido | D4: enmienda mandada al módulo (`SPE = 0 → 1` al contar corto, p. 3450); riesgo 3 |
| **S-6** HIGH, **V-2** BLOQUEANTE, **H-7** MEDIUM | Sondear con `HOLA` era abrir sesión: `SoltarTodo` y contadores a cero cada 100 ms, contra R-C7 | D7: muere el sondeo; nunca se deja de girar; `HOLA` solo cuando la cabecera D5 dice |
| **S-7** HIGH, **V-4** ALTA, **V-5** ALTA, **H-1** BLOCKER, **H-2** BLOCKER, **H-9** HIGH, **H-10** MEDIUM | El vigía: no cubría nada que D3 no cubriera; no podía soltar los `Transfer` de la tarea; una sección crítica lo congelaba con lo que vigilaba; contaminaba la ventana de las seis ranuras; hacía absorbente el estado enfermo; reiniciaba ranuras sanas con una pantalla de 6 ms | D5: muere el vigía. Seis tareas en un ejecutor propio del J2; el planificador único escritor |
| **S-8** HIGH | Seis enlaces sin modelo de concurrencia: en serie no caben al piso (132 > 125 µs); con `join` un plazo retrasa a las seis | D5.1: una tarea por ranura, en paralelo por hardware |
| **S-9** MEDIUM, **H-3** HIGH | 200× contra 137×; «≤ 2 giros» no era el peor caso; `HOLA` de 7 bytes | §3: 490 µs, 3 giros, 102×; `HOLA` 9/25 bytes |
| **S-10** MEDIUM, **V-7** ALTA | La tasa del hilo normalizada contra tramas nuestras; el 10⁻² sin derivación; «no cruza al músico» como invariante cuando `EVENTO` no tiene red; los 50 ms con dos caras | D6: no se normaliza; `P(golpe perdido)` como función; §3: las dos caras, la segunda HUECO de voz-total |
| **S-11** MEDIUM | «Se repite en 125 µs» contradecía la cabecera D6.2: el módulo avanza al contar bytes, no al validar el maestro | D6: la subida corrupta se pierde hasta la próxima publicación (1 Hz) |
| **S-12** MEDIUM, **H-11** MEDIUM | La ISR y el reinicio se pisaban por `EOTIE`; la bandera guardada sin dueño; solo `EOTIE`; p. 3492 contra p. 3490 sobre `EOT` al rehabilitar | D2: generación por transferencia, borrar al armar, `poll` registra antes de mirar, `EOTC` tras `SPE = 1` y antes de `EOTIE`; D4.1: `EOTIE = 0` primero; riesgo 5 |
| **S-13** MEDIUM, **V-11** MEDIA, **H-8** LOW | R-MJ2 prohibía el sondeo acotado que D4 necesita y su grep no veía ni el `Drop` del GPDMA ni `T_SUSP`; el `Drop` citado era del DMA clásico, y el N6 va por GPDMA | R-MJ2: «sin cota»; D4.2-4.3: las dos esperas acotadas declaradas; `gpdma/mod.rs:1287-1295` y `:902-910`; riesgo 6 |
| **S-14** MEDIUM, **H-5** MEDIUM | `TSIZE = sobre + cola` omitía el CRC del sobre y el relleno; «más de 10» contra «10» en el test | D1.1: `TSIZE` = bytes clocados de §4; D7 y test 6: `≥` |
| **S-15** LOW | Las ranuras vacías contaban CRC malo a 8 kHz y daban la vuelta al `u32` en seis días de instrumento encendido | D7.4: `Vacia`; R-MJ6 |
| **V-3** ALTA, **H-13** HIGH | La ranura enferma garantizaba el release (100 ms > 50) y tardaba 10 s en volver; sin ella, ningún hueco llega a 50 ms hasta p = 0,5 | D7: muere la cadencia reducida; la salud es una marca |
| **V-6** ALTA, **H-6** MEDIUM | El IWDG alimentado por el J2 definía la vida del chip como «el J2 giró»; con una ranura sin módulo disparaba diez veces por segundo | D5.4: el IWDG es del hub; supervisor de vitalidad mandado; sello por ranura al armar |
| **V-8** MEDIA | «Toda transferencia» eran seis de ocho: las dos ranuras USART no tienen `TSIZE` ni NSS ni SPI | §0: alcance seis SPI; riesgo 7 |
| **V-10** MEDIA, restricción invisible | El maestro no tenía testigo: «sana» significaba «mi periférico funciona» y excluía por diseño lo único que no produce el acusado | D7.3: la subida con su CRC es el testigo por giro; `muda`; `giros` y `subidas_ok` se cuentan aparte |
| **V-12** BAJA | «Driver de bus propietario» era etiqueta; la razón real es que embassy no cancela, y la cláusula de retiro lo desmentía | D8: driver genérico de SPI, honesto; frontera `fw`/`core` trazada |
| **H-12** LOW | Nada decía dónde viven los doce búferes de DMA en un chip con D-cache | D8, R-MJ7, riesgo 8 |
| S: la aritmética | Recalculó §3 entero: cadencia, reloj, cotas, `HOLA`, reinicio, giros, margen, tasa, `u32` | Cuadraban cadencia, reloj, cota de plazo, ventana, `u32`; no cuadraban `HOLA`, giros, margen y la tasa: §3 recalculado |
| H: lo que sí corre | sim1 modo A (1-2 giros, 200×/133×); sim4 (la red del bloque completo aguanta hasta 10⁻²); sim2 parte 2 (con bandera limpia, cero registros inconsistentes) | Se citan en D6 y §3 como evidencia, no como promesa |

**Lo que la junta no cambió:** el plazo por mensaje de R-E1 (D3), la receta de apagado como base del reinicio (D4), que la política viva en `core` y el driver en `fw` (D8), y que lo que se aprenda vuelva upstream.

---

## 12. Acta

- Samuel, 2026-09-03: *«bueno vamos a resolver esto pero como fabricantes de la nueva generación. el sam17 será el mejor sintetizador construido jamás»*, tras la conversación sobre cómo lo evitaría un fabricante establecido. La lectura de esa instrucción que este papel aplica: el silicio nuevo y el Rust se quedan; la disciplina de fabricante entra; no se espera a upstream para tener recuperación, y lo que se aprende vuelve upstream.
- Este papel se escribió leyendo, en este orden: el hilo #5607 entero con sus 24 comentarios y el volcado de registros; `embassy-stm32/src/spi/mod.rs` (`main`, 2130 líneas: `write`, `read`, `transfer_inner`, `finish_dma`, `Drop`, el constructor con NSS), `dma/gpdma/mod.rs` (`Channel::read`/`write`, `request_reset`, `Drop for Transfer`), `dma/mod.rs` (`Channel::new`, `Request`), `rcc/mod.rs` (`enable_and_reset`), `macros.rs` (`dma_trait!`), `executor.rs` (`InterruptExecutor`); `stm32-data-generated/data/chips/STM32N657X0.json` (IWDG, SPI1-6); el RM0486 Rev 4 cap. 67 en las páginas 3437-3440, 3445-3451, 3452-3456, 3457-3459, 3482-3484 y 3489-3493, sacadas del PDF versionado con `pypdf` y citadas enteras; la cabecera del J2 D2-D8, §3.1, §3.3, §4 y R-C1..R-C8; voz-total §9.2; `trama_j2_budget.py`, `enlace_budget.py`, `sancion_j2.csv`; `micro_budget.py` corrido; `fw/src/main.rs` y `core/src/j2.rs`.
- Cada cita del RM se pegó entera y textual con su página, y la interpretación va fuera de las comillas (memoria del 03-09: *«un corchete dentro de una cita es una interpretación disfrazada de fuente»*). La v1 tenía una recortada con «(...)»; Serrano la cazó y la v2 la lleva entera.
- La v1 pasó la junta **antes** de pedir la firma. Siete decisiones cambiaron de mecanismo o murieron (D1, D2, D4, D5, D6, D7, D8) y llevan ⚠; D3 sobrevivió con una cifra corregida. La v1 defendía 200× con un vigía; la v2 defiende 102× sin él, y lo que ejecuta es lo que dice.
- Lo que este papel no midió y dice que no midió: todo lo marcado ESTIMADO en §3, la tasa real del defecto en nuestro montaje, y cuánto sustain fantasma es tolerable. No hay Discovery.
- Samuel, 2026-09-10: *«firmo formalmente»*. Firma de contenido, no solo de dirección: las ocho decisiones (D1-D8) quedan en vigor tal como salieron de la junta del 2026-09-03, sin matiz. Firmar el papel no aplica el mapa de enmiendas (§10): sus filas siguen `pendiente` hasta que alguien las ejecute en el papel que corresponde — la fila «hub N657, los ejecutores» es, en concreto, lo que el censo de GPDMA y prioridades de interrupción (#150, punto 2) tiene que escribir.
- Samuel, 2026-09-11: frenó la tarea 7 con *«si el chip que usamos tiene un defecto reportado […] no podemos seleccionarlo. nunca podríamos confiar en él»* y pidió junta. El orquestador había dicho en la conversación «el chip tiene un defecto» donde este papel dice «en el silicio o en su driver»; la junta arrancó con esa corrección en la primera línea del brief. Seis lentes (Serrano, Halberg, Voronov, Richter, Lyra, Cassian) descartaron cambiar de chip por unanimidad y encontraron los huecos del punto 7 de la enmienda de §9; sus dictámenes, el brief, el extracto de ES0396 y el hilo #5607 quedan en `docs/superpowers/juntas/2026-09-11-j2/`. Después de la junta se leyó ES0620 Rev 5, que no lista el SPI.
- Samuel, 2026-09-11, 15:27 UTC: firmó el «Acta del J2» (artifact, documento `firmas/junta-2026-09-11`) marcando las cuatro fichas y sin palabras añadidas: **seguir con el N657, y nada se fabrica hasta medir** (ficha 1); **cero artefactos audibles** como límite (ficha 2, sobre la opción recomendada); **primero las enmiendas, después el driver** (ficha 3); **la Nucleo-N657X0-Q ahora** (ficha 4). Lo que la firma habilita está en las enmiendas del 11-09 a D2 y §9, en las filas nuevas de §10, y en #363, #364 y #366 a #371. Lo que la junta no cambió: D1, D3, D5 a D8, y la frontera `fw`/`core`.
