sssamuelll/sam17/docs/superpowers/specs/2026-09-05-fuente-v5-ladrillo-design.md

# Fuente v5 — el ladrillo afuera, la conversión adentro

**Fecha**: 2026-09-05 · **Estado**: **D-V1, D-V2, D-V3 y D-V5 FIRMADAS el
2026-09-08**; D-V2 y D-V5 arrastran **16 HUECOS** a §9.2, de los que **cuatro
políticas quedaron decididas el 2026-09-08** (§9.3). ~~**D-V4 sigue sin firmar** y
sigue siendo el atasco~~ **D-V4 FIRMADA 2026-09-08, en dirección, con M1–M5
opción A** (§9; enmienda por firma de Samuel) ·
**Decidido por Samuel el 2026-09-05**: sacar la etapa AC-DC de la caja (opción B de
tres), y firmar **D-B2 a 500 mA/riel** para la fila de abajo ·
**Junta**: `2026-09-08-junta-fuente-v5-dv1-dv5.md` — dictaminó D-V1 firmable tal
cual, D-V2/D-V3/D-V5 con condición, y D-V4 ~~**no firmable aún**~~ **firmada
posteriormente el 2026-09-08 con las asignaciones de §9** ·
**Guion**: `hardware/01-power-supply/v5/ladrillo_budget.py` — todas las cifras de
este papel salen de ahí, corriendo ·
**Reabre**: `fuente-v4-liston` §1 (D-F1), §3, §4.1, §4.2, §5 (D-F5), §6, §7 (D-F2);
la spec del chasis §3.2 y §3.3; `calor_budget.py`; `case/cad/params.scad` ·
**No toca**: la cascada de regulación (§4.2 de la v4), que es de donde sale el
0,8 µVrms

---

## 0. Por qué

La v4 mete dentro de una caja de madera: seis módulos AC-DC, la entrada de red,
el fusible, la NTC de arranque, el choke de modo común, los MOV, los Y2 al
chasis, y un recinto de acero de **338,6 × 176,6 × 83 mm** que ocupa el **30 %
del suelo interior**. Con eso, `clearance_budget.py` le encarga al case
**21 725 mm²** de venteo nuevo (#289), que Elke midió como imposibles de sacar
del suelo entero: con la regla de puente del propio repo caben 21 088.

Samuel preguntó por qué un Moog puede ir sellado. La respuesta, con las cifras
de fábrica:

| | potencia | fuente | refrigeración |
|---|---|---|---|
| Moog Subsequent 37 | 13 W | dentro, IEC | ninguna, sellado |
| **SAM17 v4, declarado** | **147,31 W** | dentro | 25 025 mm² de venteo |
| Moog One, 16 voces | 160 W | **fuera**, ladrillo | **ventilador interno** |

Moog sella a 13 W. Al llegar a 160 sacó la fuente **y aun así puso ventilador**.
A la potencia de la v4 la respuesta de Moog no sería «sellado».

Pero los 147,31 W de la v4 son en un 65 % la fila de abajo **a corriente de
placa**: lo que los módulos pueden entregar, no lo que nadie pide. Con la fila
declarada de verdad, el SAM17 no está en la escala del Moog One.

> Fuentes: manual del Subsequent 37 (inMusic, `Subsequent_37_Manual_0.pdf`,
> «13W») y la reseña del Moog One en Sound On Sound (ladrillo de 160 W,
> ventilador interno), leídas el 2026-09-05.

## 1. D-B2, firmada: la fila de abajo declara 500 mA/riel

El 2026-09-04 Samuel corrigió la premisa: *«los otros módulos los vamos a
fabricar nosotros también»*. La fila de abajo no es un censo de invitados de
mercado, es un presupuesto de diseño propio.

El listón «a la altura de la A-100PSU3 o superior» se firmó pensando en módulos
de terceros. **Ese ya no es el supuesto**, y con él cae la razón de declarar
3,8 / 2,5 / 4,0 A.

| | +12 rack | −12 rack | +5 rack |
|---|---|---|---|
| D-F1 (v4, 03-09) | 3,8 A | 2,5 A | 4,0 A |
| **D-B2 (v5, firmada 05-09)** | **0,5 A** | **0,5 A** | **0,5 A** |

Esto no es un recorte de capacidad: es dejar de prometer corriente a módulos que
no existen. La capacidad real la fija la pieza que se elija, y sobra.

## 2. El reparto: qué se va con la fuente y qué no

Lo primero que hay que decir, porque contradice la intuición y decide el resto
del papel:

> **Todo lo que baja por el cordón acaba en calor dentro de la caja.**
>
> El calor lo hacen las CARGAS, y las cargas no se mudan. Lo único que se muda
> es la pérdida de CONVERSIÓN. Así que el calor del cajón es, exactamente, la
> potencia de **salida** del ladrillo.

`ladrillo_budget.py` lo asevera, no lo promete: si algún día entra potencia por
otro sitio, el aserto salta.

De los 147,31 W de la v4, lo que se va con la fuente son **25,02 W** de pérdidas
de conversión y franja de red. Lo demás baja de golpe por otra razón: D-B2.

## 3. El ladrillo (D-V1, D-V2)

**D-V1: la etapa AC-DC es una pieza de catálogo, certificada, fuera de la caja.**
No un cajón nuestro. Un cajón externo multi-riel sería un segundo producto —
chasis, panel, acabado, entrada de red, certificación — y su única ventaja sobre
esta opción es térmica, de **0 W**.

**D-V2: 24 V.** Los 19 V de portátil también bucan bien a los 15,5 de la
cascada, pero a 24 el cordón lleva menos corriente y ~~queda más margen para el
arranque~~ **la reserva de arranque queda por demostrar** (enmienda de D-V2 del
2026-09-08, abajo).

| | |
|---|---|
| tensión | 24,0 V |
| salida, lo que baja por el cordón | **64,22 W** |
| corriente del cordón | 2,68 A |
| lo que le pide a la red | 72,98 W |
| **se disipa fuera de la caja** | **8,76 W** |

> **ENMIENDA (2026-09-08, M1/D-V4 · §4 y firma de §9). Presupuesto anterior a
> la barrera digital.** Las cifras de esta tabla proceden del modelo todavía
> sin adaptar (`hardware/01-power-supply/v5/ladrillo_budget.py:134`, `:135`,
> `:147`, `:151`, `:164`, `:169`, `:294`). M1 obliga a revisar las pérdidas y
> la demanda del ladrillo; no se publican nuevos valores. Véase
> **H-CENSO-ETA-DIGITAL**, [censo](2026-09-08-censo-dv4-resolucion.md) §6.

> **ENMIENDA (2026-09-08, D-V2 · `2026-09-08-junta-fuente-v5-dv1-dv5.md` §2). Contrato de entrada, fallo y
> arranque por completar.** Se escribe qué hay que acreditar; ~~D-V2 sigue sin
> firmar~~ **D-V2 se firmó en dirección el 08-09 y estos HUECOS viajan con
> ella a §9.2, sin darse por contestados**. Las preguntas siguientes no tienen valores elegidos en el árbol.
>
> **Los nodos no son intercambiables.** Se distingue la salida del ladrillo,
> la entrada del chasis después del cordón, la entrada de los DC-DC después
> de las protecciones que se elijan, y el pin `IN` de `U1` referido a su masa
> local. El nominal de transporte propuesto es **24 V**
> (`hardware/01-power-supply/v5/ladrillo_budget.py:93`); **24 V en el cordón no
> son 24 V en `U1`**. Entre esos nodos está la conversión DC-DC a crudo y la
> cadena de entrada de la cascada, que incluye el filtro LC
> (`ladrillo_budget.py:136`, `:178`). El presupuesto no elige su realización
> ni demuestra una barrera de aislamiento (`ladrillo_budget.py:49`).
>
> **El límite firmado sigue después del DC-DC.** `U1` es el LT1963A de D-F8:
> su entrada tiene máximo absoluto **±20 V**, no un rango de funcionamiento
> ni un objetivo de disparo (`hardware/01-power-supply/v4/check_absmax.py:209`,
> que cita `docs/reference/datasheets/lt1963a-rev-g-2021-02.pdf` p. 2).
> **Si el DC-DC falla con un corto entre entrada y salida**, y no hay una
> barrera o protección independiente que lo impida, puede trasladar la
> tensión de transporte al nodo de `U1` y superar ese máximo. Ni el nominal
> del crudo ni el apagado del convertidor averiado demuestran supervivencia.
> Hay que acotar la tensión que alcanza `IN`, su duración y la energía hasta
> el corte, contra los límites de las piezas que permanecen expuestas.
>
> **Es el cruce con #334:** la v4 ya enfrentaba **20,25 V sostenidos** de OVP
> de `PS1` con los **±20 V** de `U1` (papel
> `2026-09-03-fuente-v4-liston-design.md`, bloque D-F9, «Lo que NO cierra»;
> `check_absmax.py:209`). Cambiar la fuente de ese nodo cambia el origen del
> fallo, pero no cierra el issue. La protección de `U1` ante el DC-DC nuevo
> queda pendiente de decisión y prueba; este contrato no cambia la pieza.
>
> **H-V2-ENTRADA — HUECO: ventana garantizada.** La ventana de entrada del
> DC-DC tiene que contener la que resulte del ladrillo, menos las caídas del
> cordón, contactos y protecciones, en todas las condiciones admitidas. El
> nominal citado no proporciona ninguno de esos extremos. **Pregunta exacta
> al fabricante del ladrillo y de los DC-DC:** «¿Qué mínimos y máximos de
> salida garantiza el ladrillo bajo línea, carga y temperatura, qué ventana
> admiten los DC-DC para arrancar y para seguir regulando, y qué caídas máximas
> de cordón, contactos y protecciones permite compatibilizar ambas?»
>
> **H-V2-SUBTENSION — HUECO: límites de arranque y parada.** Deben quedar
> declarados por separado el encendido, la inhibición por subtensión, la
> histéresis, las tolerancias y el punto donde se miden. **Pregunta exacta:**
> «¿Qué tensión mínima permite arrancar, cuál obliga a inhibir la conversión,
> con qué histéresis, tolerancia y tiempos, en qué nodo se detectan y cómo se
> coordinan esas señales con la habilitación de la cascada de D-F4?»
>
> **H-V2-TRANSITORIOS — HUECO: envolvente admisible.** Se necesitan límites
> de funcionamiento y supervivencia en los nodos anteriores, incluyendo
> cambios de carga y maniobras del cordón de D-V5. **Pregunta exacta:** «¿Qué
> tolerancia del crudo en régimen y qué amplitud, polaridad, duración y
> repetición de transitorios garantiza o admite cada interfaz, bajo qué carga
> y temperatura, y qué elemento limita lo que finalmente alcanza los
> pre-reguladores?»
>
> **H-V2-RESERVA — HUECO: arranque con las cargas conectadas.** El guion
> entrega **64,22 W** y **2,68 A** al nominal propuesto
> (`ladrillo_budget.py:151`, `:169`); son presupuesto estacionario, no reserva
> de arranque ni corriente máxima de fallo. **Pregunta exacta al fabricante:**
> «¿Qué carga capacitiva y perfil de corriente de arranque admite el ladrillo,
> qué corriente y energía exige la cadena completa con sus cargas, qué
> tensión mínima conserva durante ese arranque y qué reserva garantizada
> evita que su limitación y el arranque de los DC-DC se impidan mutuamente?»
>
> **H-V2-RECUPERACION — HUECO: salida de subtensión o protección.** Falta
> elegir la política, además de acreditar que las piezas pueden cumplirla.
> **Pregunta exacta a Samuel y al fabricante:** «¿La cadena debe recuperarse
> automáticamente, reintentar o esperar una intervención, bajo qué condición
> de tensión y tiempo se autoriza, y en qué estado deben quedar sus rieles y
> habilitaciones durante la caída, la espera y el rearranque?»
>
> **H-V2-CORTO-DCDC — HUECO: supervivencia de `U1`, #334.** **Pregunta exacta:**
> «¿Qué recorrido eléctrico deja un corto entre entrada y salida del DC-DC,
> qué tensión, duración y energía alcanzan `IN` de `U1`, y qué elemento
> independiente limita o interrumpe ese recorrido dentro de los límites
> documentados, incluidos sus tiempos y tolerancias?»
>
> **ENMIENDA (2026-10-25, #334): contestada en diseño; queda el ensayo.** El
> recorrido es el de M3: el módulo puenteado pone hasta 36 V en `+15V5_RAW`
> (cota: `U16` corta por encima de 32,7 V), y de ahí `U19` → `L2` →
> `C3`/`C1` → `IN` de `U1`. Lo interrumpe `U19` (TPS26631) por lo primero que
> llegue: el disparo rápido a 3 × I(OL) (~~3,28~~ **3,32** A máx. con `R34` y su 1 %) en ≤ 4,5 µs,
> o el OVP a ≤ ~~16,92~~ **17,59** V (`R36` = 3,74 kΩ desde el 2026-10-27) en ≤ 14 µs (`tps2663.pdf` p. 6–9). En el peor caso
> —máximo sano en vacío, sin carga, `L2`, `C3` y `C1` en el borde bajo de su
> tolerancia— `U19` abre a los ~~7,4~~ **7,5** µs, `L2` llega a 8,7 A y el pico en `IN`
> de `U1` es **17,40 V** contra 20,0 V; el `SMBJ16A` no conduce
> (`check_absmax.py`). En continua, con el THN atascado justo debajo del
> OVP, `U1` ve hasta 17,59 V, el borde alto: es lo peor que ve. Para que eso valga, `L2` pasa a ser una **Bourns
> SRP1265A-220M** (Isat 12 A y curva L–I publicada hasta 12 A,
> `bourns_srp1265a.pdf` p. 1 y 3). Con la `SRR1260-220M` (Isat 3,7 A) el
> modelo llevaba 12,7 A por 22 µH enteros, y con la bobina saturada el pico
> dependía de una curva que su hoja no publica. Cada reintento de `U19`
> repite el mismo recorrido y su `FLT` gasta intento en M5. Queda el ensayo,
> que pide la placa: `check_bringup.py`, paso 8,
> `pico_transitorio_U1_con_clamp_v` (16,42 V predichos en el banco, ≤ 18,5 V).
>
> **H-V2-AISLAMIENTO — HUECO: evidencia del ladrillo.** La firma de D-V1
> remite aquí clase, aislamiento y fuga; no se eligen por inferencia del
> rendimiento del guion. **Pregunta exacta al fabricante:** «¿Qué clase de
> protección, aislamiento, corriente de fuga, relación entre salida DC y PE,
> y protecciones con su modo de recuperación acredita la referencia propuesta,
> en qué hoja o certificado y bajo qué condiciones?» La carga capacitiva está
> en H-V2-RESERVA y la relación con el chasis en H-V5-PE.
>
> **DECISIONES PENDIENTES:** adoptar la ventana y los límites de entrada;
> elegir las políticas de arranque, inhibición y recuperación; asignar el
> mecanismo que protege `U1` frente al fallo del DC-DC (#334). Para cerrar
> cada HUECO hace falta una respuesta con fuente local, condiciones y criterio
> de aceptación de la cadena completa. No hay todavía piezas ni ensayos que
> permitan dar esas respuestas por satisfechas.

El cordón es de **dos hilos**, no de siete. ~~Su caída no cae encima de ningún
margen: la absorbe el convertidor de dentro.~~ La conversión puede absorberla
**mientras su entrada permanezca dentro de la ventana que garantiza regulación**;
esa ventana es H-V2-ENTRADA (enmienda del 2026-09-08).

| calibre | 1 m | 2 m |
|---|---|---|
| 18 AWG | 112 mV | 225 mV |
| 16 AWG | 71 mV | 141 mV |

Con 16 AWG y 2 m son el **0,6 %** de 24 V. Esta es la diferencia de fondo con
bajar los rieles ya hechos, donde esa misma caída caería justo sobre el margen
de `U1`/`U2` — que es el problema que este papel viene a cerrar, no a empeorar.

> **ENMIENDA (2026-09-08, D-V5 · `2026-09-08-junta-fuente-v5-dv1-dv5.md` §2). Contrato del cordón y relevo de
> retorno/chasis/PE por completar.** ~~D-V5 sigue sin firmar.~~ **D-V5 se firmó
> en dirección el 08-09; estos HUECOS viajan con ella a §9.2.** «Dos hilos» no
> elige conector, protección ni referencia de masa.
>
> **Lo calculado no es todavía un calibre vinculante.** Se conserva el
> resultado del guion: **141 mV con 16 AWG y 2 m**, a **2,68 A**, equivalentes
> al **0,6 %** del nominal de **24 V** (`ladrillo_budget.py:173`, escenario
> `:339`, corriente `:169` y nominal `:93`). No se recalcula ni se convierte
> ese escenario en una elección de cable. La función no incluye resistencia
> de contactos; tampoco demuestra el comportamiento durante arranque o fallo.
>
> **El retorno DC no hereda el PE por llamarse retorno.** La v4 lleva ★ por
> `J5` al espárrago, con anillos separados para `J5` y el PE de red (papel
> `2026-09-03-fuente-v4-liston-design.md` §4.1). D-F5 cerraba el modo común por
> **módulo → Y2 → chasis → PE → primario** (mismo papel §4.2, «EMI»).
> **Dos hilos de alimentación y retorno no transportan ese PE separado.**
> ~~**No hay todavía un heredero identificado de ese camino.** No queda por
> ello decidido que el retorno DC sea PE, que se una al chasis o que el
> chasis quede flotante.~~ **ENMIENDA (2026-09-08, M2/D-V4 · firma de §9): el
> chasis se agarra al retorno de continua, y el modo común del ladrillo se
> cierra fuera, con él.** Esto no declara que retorno DC sea PE. El PE del
> propio ladrillo, si lo tiene, tampoco demuestra un camino hasta el chasis
> a través del cordón. **H-V5-PE sigue abierto:** faltan mapa, evidencia y
> ensayo del conjunto preservando GNDD; M1 asigna su barrera (§9).
>
> El relevo debe declarar las relaciones entre retorno DC, ★, `J5`, chasis
> y PE, y acreditar el camino de modo común del conjunto. No puede dar por
> heredado el resultado de D-F5 con las piezas retiradas. Sigue vigente la
> separación de `GNDD`, fuera de ★, y la aceptación **>1 MΩ entre GNDA y
> GNDD** dentro de la fuente (v4 §4.1 y §9.1). Esta obligación limita las
> respuestas posibles; no elige las barreras ni los retornos de D-V4.
>
> **H-V5-CONECTOR — HUECO: pareja y polaridad.** **Pregunta exacta:** «¿Qué
> pareja de conectores se elige para ladrillo y chasis, qué contacto lleva
> alimentación y cuál retorno, cómo se identifica esa polaridad y qué hoja
> local acredita sus límites eléctricos y su resistencia de contacto?»
>
> **H-V5-RETENCION — HUECO: sujeción del conjunto.** **Pregunta exacta:**
> «¿Qué retención y alivio de tracción se exigen al conjunto, bajo qué esfuerzo
> se verifican y qué condición de aceptación debe cumplir?»
>
> **H-V5-CALIBRE — HUECO: cordón vinculante.** **Pregunta exacta:** «¿Qué
> calibre, longitud máxima y resistencia total admisible se adoptan para el
> cordón completo, incluidos conectores y terminaciones, y qué corriente y
> temperatura debe soportar en uso, arranque y hasta el corte por fallo?»
>
> **H-V5-INVERSION — HUECO: polaridad inversa.** **Pregunta exacta:** «¿Qué
> debe ocurrir al aplicar polaridad inversa, qué tensión y duración debe
> soportar el conjunto, qué elemento responde y cómo se recupera al corregirla?»
>
> **H-V5-CALIENTE — HUECO: conexión en caliente.** **Pregunta exacta:** «¿Se
> admite conectar el cordón con el ladrillo energizado y, si se admite, cuáles
> son los límites garantizados de corriente de entrada y transitorio, qué
> carga capacitiva admite el ladrillo y cómo deben comportarse los rieles
> durante la conexión?» La respuesta tiene que coincidir con
> H-V2-TRANSITORIOS y H-V2-RESERVA; no se presume que el conector lo permita.
>
> **H-V5-RECONEXION — HUECO: energía residual y rearranque.** **Pregunta
> exacta:** «¿Qué debe ocurrir al desconectar y reconectar con energía residual
> en la caja o rebote de contactos, qué condiciones habilitan el rearranque
> y qué límites temporales y eléctricos lo verifican?» La política es la de
> H-V2-RECUPERACION, pendiente de elección.
>
> **H-V5-CORTO — HUECO: fallo del cordón.** **Pregunta exacta:** «¿Qué debe
> ocurrir ante un corto entre los conductores o hacia el chasis, qué elemento
> limita o interrumpe, cuáles son sus límites de corriente y duración y cómo
> se recupera después del corto?» La evidencia debe incluir el tramo de cable
> expuesto al fallo; una protección situada después de ese tramo no demuestra
> por sí sola que lo proteja.
>
> **H-V5-INCOMPATIBLE — HUECO: adaptador ajeno al contrato.** **Pregunta
> exacta:** «¿Qué adaptadores incompatibles debe cubrir el contrato y, para
> cada incompatibilidad de tensión, polaridad o capacidad de entrega, qué
> comportamiento y límites de supervivencia se exigen, y quién los garantiza?»
> Que un adaptador pueda enchufarse no demuestra compatibilidad eléctrica.
>
> **H-V5-PE — HUECO: relevo de D-F5.** **Pregunta exacta:** «¿Qué relación
> tendrán el retorno DC del cordón, ★, `J5`, el chasis y PE, quién proporcionará
> el camino de modo común que D-F5 cerraba por chasis → PE → primario, y qué
> evidencia y ensayo del conjunto lo acreditarán preservando la separación
> de GNDD?» H-V2-AISLAMIENTO aporta la evidencia del ladrillo; por sí sola
> no contesta la relación con el chasis.
>
> **DECISIONES PENDIENTES:** elegir conector, polaridad, retención y cordón
> vinculante; decidir qué maniobras y adaptadores quedan admitidos o cubiertos,
> con su comportamiento de fallo y recuperación; ~~definir retorno/chasis/PE y
> asignar el relevo de D-F5~~ **acreditar el reparto ya firmado en M2/D-V4
> (2026-09-08, §9)**. Cada respuesta debe nombrar responsable físico,
> límites con fuente local y prueba de aceptación. ~~Ninguna queda tomada aquí.~~
> **Rigen las políticas de §9.3 y las asignaciones de §9; sus HUECOS siguen abiertos.**

## 4. Los rieles de dentro

Cifras del modelo anterior a M1: `hardware/01-power-supply/v5/ladrillo_budget.py:119`
(`rieles()`), `:143`, `:147` y salida de `:282`; la enmienda siguiente delimita
su vigencia tras la firma, sin recalcular el guion.

| riel | V | A | entrega | pierde |
|---|---|---|---|---|
| +12 rack (bus fila B + pantalla) | 12,00 | 1,050 | 12,60 W | 1,40 W |
| −12 rack (bus fila B) | 12,00 | 0,500 | 6,00 W | 1,06 W |
| +5 rack (bus fila B) | 5,00 | 0,500 | 2,50 W | 0,28 W |
| +5 digital (4 × N657 + host USB) | 5,00 | 2,895 | 14,47 W | ~~1,61 W~~ **HUECO M1: conversión aislada; pérdida por acreditar** |
| crudo +cascada (a `U1`) | 15,89 | 0,650 | 10,33 W | 1,82 W |
| crudo −cascada (a `U2`) | 15,89 | 0,650 | 10,33 W | 1,82 W |
| | | | **56,23 W** | ~~**7,99 W**~~ **HUECO M1: total subestimado, sin valor nuevo** |

El +12 lleva dos cargas por cables distintos: el bus de la fila y la pantalla de
7" con su retorno dedicado, que es lo que pide `pantalla-motor`. Van juntas en
el convertidor y separadas en el cableado.

> **Regla de mazo (T26, #477).** La pantalla no tiene red propia en la placa.
> Su `+12V_RACK` y su retorno salen de `J3.1` y `J3.2` (`GNDA`) como un par
> propio del mazo, ida y vuelta juntas, hasta la pantalla, sin pasar por el bus
> de la fila: sus 550 mA no caen por la masa del bus (`pantalla-motor` §6).
> `J3` es una bornera `MKDS 1,5/4-5,08` (`1715747`) y lleva dos conductores por
> borne, que su hoja admite si son de la misma sección
> (`phoenix-mkds-1715747-2018-11.pdf` p. 2–3): rígido 0,14–1 mm², flexible
> 0,14–0,75 mm², con puntera sin collar 0,25–0,5 mm², o los dos en una puntera
> TWIN con collar de 0,5–1 mm²; pelado 7 mm, apriete 0,5–0,6 N·m. El hilo de
> la pantalla y el del bus de la fila van, pues, de la misma sección en
> `J3.1` y en `J3.2`. `check_telemetria.py` comprueba que el
> `+12V_RACK` solo sale por `J3`, con `J3.2` en `GNDA`, y el bring-up revisa el
> mazo (paso 0, `mazo_pantalla_par_propio_desde_J3`). El guion lo contaba como
> T25; en el censo (`2026-09-08-censo-dv4-resolucion.md`) T25 es el reparto de
> retornos rack/instrumento, y los cables propios de pantalla y fila son T26.
> La masa de datos de la pantalla llega por LTDC desde el hub, en `GNDD`, y su
> encuentro con `GNDA` dentro de la pantalla queda abierto en #480.

**Los tres rendimientos son ESTIMADO** y ~~mueven los 7,99 W enteros~~
**movían la pérdida publicada por el modelo anterior a M1**
(`hardware/01-power-supply/v5/ladrillo_budget.py:239`). Es el único término de
este presupuesto que no está anclado a una hoja, y se cierra eligiendo las piezas.

> **ENMIENDA (2026-09-08, M1/D-V4 · firma de §9). La barrera digital cambia la
> clase de conversión presupuestada.** M1 firma **aislar solo el cerebro
> digital**: el convertidor del **+5 digital** lleva barrera; sonido y rack
> comparten retorno. Abierto `rieles()`, se confirma que la fila digital usa
> **`ETA_BUCK = 0,90`** (`hardware/01-power-supply/v5/ladrillo_budget.py:101`,
> `:134`, `:135`), la estimación del buck sin barrera. **Esa clase ya no
> corresponde a la conversión aislada exigida por M1.**
>
> La pérdida digital tachada y el total interior de **7,99 W están
> subestimados por esa hipótesis de clase**, y la salida pedida al ladrillo
> arrastra la misma carencia (`ladrillo_budget.py:147`, `:151`, `:291`, `:296`).
> No se cuantifica la subida ni se sustituye el rendimiento por otro estimado:
> los rendimientos interiores están declarados **ESTIMADO**, sin piezas ni
> garantías (`:99`, `:110`, `:239`). El escenario de censo también usa
> `ETA_BUCK` para el digital (`:226`); las comparaciones térmicas de §6 y las
> cifras heredadas de §8 deben revisarse con el mismo dato garantizado.
>
> **Los crudos no cambian por M1.** Su **`ETA_AISLADO = 0,85`** sigue siendo la
> estimación del flyback de doble salida por **topología**, no una barrera
> exigida para esos rieles (`ladrillo_budget.py:100`, `:103`, `:136`, `:138`).
> Ese nombre de constante no acredita aislamiento ni elige una pieza.
>
> **H-CENSO-ETA-DIGITAL — HUECO abierto**, registrado con nombre propio en el
> [censo](2026-09-08-censo-dv4-resolucion.md) §6. **Pregunta exacta:** «¿Qué
> rendimiento garantiza la conversión aislada que M1 obliga a poner en el +5
> digital, y cuánto sube con él la pérdida interior y la salida pedida al
> ladrillo?» Diseño de potencia y fabricante de esa conversión deben aportar
> la garantía y el presupuesto actualizado. La firma no aporta ese dato.
> **Que un trabajo tenga dueño no es que esté hecho.**

## 5. ~~El regalo: la tensión cruda cierra `U2`~~ Holgura para `U1` y D-F4 (D-V3)

> **ENMIENDA (2026-09-07, D-F9 · #335). El regalo llegó por otro lado, y esta
> sección publica cifras que su propio guion ya no produce.**
>
> El 06-09 —un día después de escribirse este papel, y con este papel sin
> firmar— se firmó **D-F9: `U2` pasa de LM2991 a LT3015**. La tabla de abajo la
> genera `ladrillo_budget.py`, que reusa `margen_budget.py` entero; al cambiar
> la pieza, su columna `margen U2` cambió sola:
>
> | crudo | margen `U2` publicado aquí | margen `U2` que da hoy el guion |
> |---|---|---|
> | 15,0 V | −170 mV | **+536 mV** |
> | 15,5 V | +311 mV | **+1017 mV** |
> | 16,0 V | +792 mV | **+1498 mV** |
>
> **Lo que esto le hace a D-V3: le quita el sujeto, no la razón.** `U2` ya no es
> el rojo que hay que cerrar —ya está cerrado a 15,0 V, sin tocar el crudo—, así
> que subirlo a 15,5 deja de comprar un cierre. Lo que sigue comprando es
> holgura en **`U1`**, que a 15,0 V es el peor riel con **+330 mV** sobre una
> incertidumbre de modelo de 127, y a 15,5 se va a +811.
>
> Y eso **cambia la pregunta**, porque este papel entero va de bajar calor: los
> ~~**+0,33 W** de D-V3 se pagaban por necesidad y ahora se pagarían por margen~~
> **+0,33 W publicados sólo contaban `U2`; el coste completo se precisa en la
> continuación del 2026-09-08**.
> Decidir si valen sigue siendo trabajo de la firma de esta v5; lo que ya no se
> puede es justificarlos con `U2`.
>
> **ENMIENDA (2026-09-08, D-V3 · `2026-09-08-junta-fuente-v5-dv1-dv5.md` §2). Continuación de la del 07-09:
> razón vigente y coste completo.** La corrección anterior de D-F9 se mantiene:
> `U2` es LT3015 y ya cerraba a **15,0 V con +536 mV**; a **15,5 V da +1017 mV**
> (`ladrillo_budget.py:178`, salida `:326`). No se necesita elevar el crudo
> para cerrar `U2`, ni se vuelve al LM2991.
>
> **Lo que compra ahora la propuesta:** holgura en `U1`, de **+330 a +811 mV**
> al pasar de **15,0 a 15,5 V** (`ladrillo_budget.py:178`, salida `:325`), y
> holgura para el detector de ventana de D-F4. Este tenía **+40 mV útiles**
> después de histéresis y error de umbral (papel v4, bloque D-F9, «Lo que
> cierra»; `hardware/01-power-supply/v4/secuencia_budget.py:198`). Esa cifra
> describe la v4; no fija ni garantiza un nuevo umbral para la v5. El aumento
> del margen de entrada alivia esa restricción en el modelo; su realización
> sigue necesitando la entrada y los transitorios de D-V2.
>
> **Lo que cuesta dentro de la caja, comparando el mismo extremo alto:**
> **+0,33 W en `U1` y +0,33 W en `U2`** (`ladrillo_budget.py:197`, `:211`),
> más **+0,12 W de conversión** (`:126`, `:136`, `:138`, `:147`) =
> **+0,78 W en total** (`:151`, `:160`). El presupuesto pasa de **63,43 a
> 64,22 W**; la diferencia se calcula antes de redondear, no restando esos
> extremos ya impresos. El coste usa el rendimiento **0,85 ESTIMADO** del
> crudo (`:103`) y la tolerancia **±2,5 % supuesta** (`:108`, `:115`): es el
> resultado del modelo, no una garantía de piezas aún sin elegir.
>
> **DECISIÓN PENDIENTE:** Samuel debe decidir si esa holgura para `U1` y D-F4
> vale el coste completo. ~~D-V3 sigue sin firmar.~~ **Decidido el 08-09: se
> acepta el vatio a cambio del margen; D-V3 queda FIRMADA y sin HUECOS.** Su
> nominal no acota el crudo
> durante un fallo: #334 sigue abierto y su pregunta está en H-V2-CORTO-DCDC.
> Las tachas del título, texto y tabla siguientes retiran la razón caduca y
> conservan su rastro; esta continuación amplía, no reemplaza, la del 07-09.

~~`U2`, el pre-regulador negativo, lleva desde el 2026-09-03 con **−170 mV** de
margen de entrada, y no tiene salida por piezas: ninguno de los candidatos de
D-F8 es una pieza negativa. El problema nunca fue `U2`. Es que un IRM de
catálogo entrega 15,0 V con ±2,5 %, y eso no alcanza.~~ El sujeto cambió con
D-F9; rige la razón de la enmienda anterior (2026-09-08).

Con un DC-DC nuestro, **la tensión cruda deja de ser un dato de catálogo y pasa
a ser una decisión**:

| crudo | le llega a U1/U2 | margen `U1` | margen `U2` | quema `U2` | |
|---|---|---|---|---|---|
| 15,0 V | 14,370 V | +330 mV | ~~**−170 mV**~~ **+536 mV** | 1,61 W | ~~la v4, y su rojo~~ v4 con D-F9 |
| **15,5 V** | 14,851 V | +811 mV | ~~**+311 mV**~~ **+1017 mV** | 1,94 W | **D-V3** |
| 16,0 V | 15,332 V | +1292 mV | ~~+792 mV~~ +1498 mV | 2,27 W | |

Corrección de la tabla, **2026-09-08**, por D-F9: cifras de la ejecución de
`ladrillo_budget.py:319`. «Quema `U2`» conserva su alcance local; no es el
coste térmico total de D-V3, desglosado en la enmienda.

**D-V3: el crudo de la cascada son 15,5 V.** ~~Cuesta **+0,33 W** en `U2`. Un
tercio de vatio por cerrar el único rojo que le queda a la fuente, y **con la
misma pieza**: el LM2991 que el #322 daba por insuficiente.~~ La propuesta
compra la holgura de `U1` y D-F4 descrita arriba, con el coste completo de la
enmienda del 2026-09-08, ~~pendiente de aceptación~~ **aceptada: D-V3 se
firmó el 2026-09-08 y no arrastra ningún HUECO (§9).**

Tres honestidades sobre esta tabla:

- El margen se aprieta en el corner **bajo** y el calor en el **alto**. No son
  el mismo, y el guion los calcula por separado a propósito.
- **La trampa no es esa, es comparar.** Al escribir la primera versión de este
  papel puse «1,94 W contra los 0,96 de hoy», que son **+0,98 W**: el corner
  alto del nuevo contra el bajo del viejo. En el mismo corner son **+0,33**.
  Por eso la columna de la derecha existe y se calcula con la misma función.
- La tolerancia de ±2,5 % es la de un IRM. ~~Un DC-DC nuestro debería hacerlo
  mejor, y entonces sobra margen. Se declara el conservador.~~ Es un supuesto
  de cálculo (`ladrillo_budget.py:108`, `:115`), no una tolerancia garantizada
  del sustituto sin pieza; H-V2-TRANSITORIOS exige acreditar su salida
  (enmienda del 2026-09-08).

## 6. Lo que le pasa a la caja

> **ESTA SECCIÓN SE RECALCULÓ ENTERA EL 2026-09-05, DESPUÉS DE PUBLICARLA, Y
> UNA DE SUS CONCLUSIONES ERA FALSA.** Dos defectos, los dos míos:
>
> 1. **Etiqueta y cifra medidas distinto.** El guion que produjo la tabla
>    sumaba la carga ultra y la pantalla *por encima* de `calor_budget.py`, y
>    luego etiquetaba cada fila con la cifra *sin* ellas. Las áreas eran ~5 %
>    mayores que lo que su propia etiqueta decía.
> 2. **La rejilla trasera agrandada sube el centroide de entrada, y eso acorta
>    la chimenea.** La tabla de «trasera a 20 000» lo ignoraba: dejaba la
>    entrada a la altura de hoy. Con el centroide bien puesto, la conclusión
>    que publiqué —«a 30 mm pasa incluso con el `C_D` pesimista»— **no se
>    sostiene**: da 21,4 K contra un techo de 20.
>
> Todo lo de abajo sale ahora de `clearance_budget._tiro()` con las geometrías
> sustituidas y **nada sumado a mano**, que es la única forma de que no vuelva
> a pasar: la cifra sale bien del modelo y se estropea al copiarla fuera.

Área efectiva de hoy: **3 299 mm²**. Techo, 20 K sobre una sala de 45 °C.

| escenario | calor del cajón | hay que abrir (chimenea sola) | con la pared contada |
|---|---|---|---|
| v4 declarada | 147,31 W | 21 725 mm² | 16 555 mm² |
| v4 declarada **+ pantalla** | 150,36 W | 22 244 mm² | 17 074 mm² |
| **v5 declarada** | **64,22 W** | **7 610 mm²** | 2 440 mm² |
| v5 a censo | 35,06 W | 2 657 mm² | 0 |

La comparación honesta es la segunda fila contra la tercera: la v5 lleva la
pantalla dentro de `rieles()` y la v4 no le tiene celda (HUECO 2). Así el
encargo del #289 baja de **22 244 a 7 610 mm²**, un **66 % menos**. Eso cambia
la naturaleza de la obra, no solo su tamaño.

### 6.1 Con el suelo macizo, solo ensanchando la rendija

| rendija | v5 declarada | v5 a censo | v5 declarada, `C_D` pesimista |
|---|---|---|---|
| 4 mm (hoy) | 45,6 K | 30,5 K | 51,0 K |
| 20 mm | 27,8 K | 18,6 K | 31,1 K |
| 25 mm | 26,5 K | 17,7 K | 29,6 K |
| 30 mm | 25,6 K | 17,1 K | 28,6 K |

Con la entrada donde está hoy, **la rendija sola no llega**: ni a 30 mm baja de
25 K con la carga declarada. Hay que agrandar la entrada.

### 6.2 Agrandando la rejilla trasera — y tiene un óptimo

Las ranuras de hoy miden 41,8 mm de alto y su centroide está a y = 46,4.
Agrandar el área las hace **más altas**, y eso sube el centroide y **acorta la
chimenea**. Los dos efectos se pelean, así que hay un máximo:

| trasera | rendija 30 mm: tiro | v5 declarada | v5 a censo | pesimista |
|---|---|---|---|---|
| 7 065 (hoy) | 167 mm | 25,6 K | 17,1 K | 28,6 K |
| 10 000 | 159 mm | 22,1 K | 14,8 K | 24,8 K |
| **20 000** | **129 mm** | **19,1 K** | 12,8 K | 21,4 K |
| 30 000 | 99 mm | 19,7 K | 13,1 K | 22,0 K |

**Pasar de 20 000 empeora.** A 30 000 la entrada tiene 50 % más de área y sale
peor que a 20 000, porque el centroide sube a y ≈ 99 y se come 30 mm de tiro.
Es lo contrario de lo que dice la intuición, y es la razón de que la palanca
buena sea el **suelo** —entra a y = 0 y no le quita altura a nada— y no la
trasera.

### 6.3 Con el suelo abierto (lo que pedía el #327)

Ranuras en la tabla, en serie con el hueco perimetral de las patas de 20:

| suelo | rendija | v5 declarada | v5 a censo | pesimista |
|---|---|---|---|---|
| 20 000 + patas 20 | 20 mm | 19,4 K | 12,9 K | 21,6 K |
| 40 000 + patas 20 | 20 mm | **18,8 K** | 12,6 K | 21,0 K |

### 6.4 La lectura, sin adornos

**Con la carga declarada, ninguna de las geometrías examinadas pasa el techo de
20 K con el `C_D` pesimista.** La mejor —suelo abierto de 40 000, patas de 20,
rendija de 20— da 18,8 K con el `C_D` de la puerta y 21,0 con el exigente.

**Con los censos, todas pasan con holgura**: entre 12,6 y 18,6 K.

Y eso es exactamente HUECO 5. La «v5 declarada» apila **tres peores casos a la
vez**: la fila al techo duro de D-B2 (500 y no 300 mA/riel), la cascada a los
650 mA/riel de D-F1 contra un censo de 334, y el digital al Max de 125 °C del
#256 contra un típico de 0,965 A. Ninguno de los tres es un dato de la caja: son
declaraciones, y dos de ellas están el doble por encima de lo que el instrumento
pide. **Encargar el venteo contra las tres a la vez es una decisión, no una
consecuencia**, y es la que hay que tomar antes de dibujar nada.

> **Los 20 000 mm² de trasera caben, pero solo lo he comprobado en el plano.**
> El campo útil de la trasera va de y = 19,0 a y = 230,2, y la rejilla de hoy
> ocupa 41,8 mm: 46 ranuras de 41,8 × 3,75, 7 065 mm². Llegar a 20 000 pide
> ranuras de ~118 mm, que terminarían en y ≈ 144 y por tanto **por debajo del
> y = 157** donde `guarda_trasera_flexion()` ya declara su HUECO.
> Geométricamente entra. **Lo que NO he verificado es qué le hace a la rigidez
> del PMMA quitarle esa área**, y esa comprobación es del papel del case, no de
> éste. Hasta que se haga, la cifra de 20 000 es una hipótesis de trabajo y no
> un encargo.

Lo que la v5 **no** arregla: la rendija de 25-30 mm sigue arrastrando la franja
del anillo trasero de 23 a ~44 mm, que es el precio estético que Elke identificó
y que choca con «el marco es perfil, no banda». Eso sigue siendo una decisión
del papel del case, no de éste.

Y se va, además de calor:

- **la red entera** de la caja de madera: IEC, fusible, NTC, choke, MOV, Y2 al
  chasis, distancias de aislamiento. Es una clase entera de restricción.
- **el grueso del recinto de acero**, que hoy ocupa el 30 % del suelo. Queda la
  cascada, que es una placa, no un cajón.

## 7. Lo que esto reabre de la v4

| Qué | Por qué |
|---|---|
| **D-F1** | el listón se rehace: D-B2 sustituye 3,8/2,5/4,0 por 0,5/0,5/0,5 |
| **D-F2** (telemetría de rack) | los INA226 medían en los bornes de PS3/PS4; ahora miden a la salida de convertidores nuestros |
| **D-F4** (secuenciador, #339) | ~~usaba los pines ON/OFF de los Mean Well, que ya no están dentro~~ **los Mean Well IRM no tienen pin ON/OFF**: `D-F4` gobierna los pines `SHDN` de `U1`/`U2` (`v4` l. 593–600) y los interruptores de carga del par de rack (`v4` l. 682–684), que **se quedan dentro**. Lo que cambia bajo `M4` es el nodo vigilado: el detector analógico (`LM393B` + `TL431BI`) vigila ahora los ±15,5 V crudos de los convertidores DC-DC tras el filtro LC |
| **D-F5** (Y2 al chasis) | **muere**: la red sale de la caja |
| **D-F6** (crowbar en los tres rieles de rack, #340) | **se queda bajo `M3`**: los tres tiristores (`BT151-500R` + `TL431BI`) en +12 V, −12 V y +5 V de rack (`v4` l. 283, 685–690) siguen firmados; el corte tras el disparo pasa del *hiccup* de los IRM a la protección continua contra cortocircuito de los convertidores DC-DC (`THN 30-2422WI` / `K7805T-1000R3`) y al vigilante de entrada `M5` (`TPS26630`) |
| **D-F7** (`PS5` → IRM-45-5) | muere por desaparición del sujeto |
| **§4.1** (fuga a PE) | se rehace: seis fugas menos dentro |
| `calor_budget.py` | su modelo entero es de módulos AC-DC en un recinto |
| `params.scad::potencia_disipada` | 147,31 → 64,22 |

> **Aplicado el 2026-10-12 (plan del aire, #289):** `params.scad::potencia_disipada`
> = 64,22, y `guarda_potencia_vigente()` la cruza contra
> `ladrillo_budget.calor_del_cajon_w()`. `calor_budget.py` sigue siendo el modelo
> de la v4: lo reabre el relevo de esta v5, no el plan del aire. En sus términos
> (en serie, 105 mm de tiro) la persiana equivale a 10 776 mm² más de venteo, y la
> v4 pedía 20 907.

**No se reabre la cascada.** `U1`/`U2`, los LT3045/LT3094 y `U3` se quedan donde
están, con su misma topología, alimentados por un crudo mejor.

### 7.1 Dos issues se quedan sin sujeto

Cruzado contra los issues abiertos, no contra la memoria:

- **#322** — «*hace falta un LDO negativo 300 mV mejor que el LM2991*». Pedía una
  pieza porque `U2` no llegaba con 15,0 V de crudo. **Con D-V3 llega con el
  LM2991 de hoy**: +311 mV. La búsqueda de pieza sobra. Muere por desaparición
  del sujeto, no por haberse resuelto.
  > **ENMIENDA (2026-09-07).** No murió: **se resolvió con pieza** el 06-09
  > (D-F9 · #335, LT3015), mientras este papel seguía sin firmar. La búsqueda no
  > sobró, y la pieza **sigue haciendo falta aunque se firme esta v5**: el §7
  > dice «no se reabre la cascada», así que con el LM2991 el `ON/OFF` seguiría
  > habilitando al revés que el LT1963A de D-F8 y el **#323** quedaría abierto.
  > El LT3015 lo cierra por construcción, y eso D-V3 no lo compra a ningún
  > precio de crudo.
- **#130** — «*la entrada de red del chasis no tiene pieza*». No hay entrada de
  red en el chasis. Muere entero.

Y **el PR #316** («el recinto partido, R cerrada y C a la vista») queda **medio
adoptado**: su mitad R se va del edificio, y su mitad C —la cascada fuera de un
cajón de acero— pasa a ser la respuesta a dónde vive lo que se queda. Conviene
leerlo antes de escribir el plan de esta v5, no después.

Ninguno de los tres se toca aquí: ~~este papel no está firmado~~ **D-V4 se
firmó en dirección el 2026-09-08 (§9); queda pendiente ejecutar su relevo**
(enmienda por firma, sin modificar guiones ni cerrar issues).

## 8. HUECOS

1. **Los tres rendimientos de los convertidores son ESTIMADO.** Mueven 7,99 de
   los 64,22 W declarados. Se cierran eligiendo las piezas.
2. **La pantalla de 7" sigue sin pieza.** `pantalla-motor` l.250-256 manda su
   fila «cuando la pieza tenga nombre». Entra con 550 mA de +12 V, que son
   6,6 W: no es un redondeo. Es una cita, no una hoja.

   > **#480, opción 2 (2026-10-27, firma de Samuel): un convertidor aislado en
   > la pantalla, alimentado del +12 V de rack.** La barrera de `GNDD` de M1
   > aguanta y la placa v5 no cambia. Lo que arrastra: la pérdida de ese
   > convertidor sale del mismo +12 V. Con un rendimiento de 0,85 (ESTIMADO,
   > sin pieza) los 550 mA de la pantalla piden unos 650 mA, y el +12 V de rack
   > pasa de 1,050 a unos 1,15 A, el 92 % de los 1,25 A del `THN 30-2422WI`
   > (`traco_thn30wi.pdf` p. 1) en vez del 84 %. Es la misma pregunta de
   > derating que tiene TRACO. Entra en `ladrillo_budget.py` cuando el
   > convertidor tenga pieza.
3. **#256 sigue abierto.** El digital entra por su máximo a TJ = 125 °C porque
   el punto de trabajo real (85 °C) no está publicado. Entre ese máximo y el
   típico hay **3,0 veces** de corriente.
4. **El coeficiente de la pared exterior sigue sin medir.** Con él, el venteo
   nuevo baja de 7 610 a 2 440 mm². Sin él, no se puede contar. `U_PARED_W_M2K`
   está fuera del veredicto a propósito y este papel no lo cambia.
5. **La cascada declara el doble de su censo.** D-F1 dice 650 mA/riel; el censo
   son 334. Son **20,65 W declarados contra 10,60 reales**, y con D-B2 firmada
   la cascada pasa a ser la línea más gorda del presupuesto. Merece la misma
   pregunta que se le hizo a la fila de abajo. **No se toca en este papel.**

   > **Re-declarada el 2026-10-23: 450 mA/riel.** El peor riel del censo son
   > 340,2 mA y la regla del 30 % (`hardware/03-vco/consumo_total_budget.py`,
   > `MARGEN`) pide 442. Con 650, `U1` llegaba a 148,9 °C de unión con el aire
   > del cajón a 63,9 °C (`tj_budget.py`); con 450 el cajón baja de 72,61 a
   > 64,93 W, el aire a 62,6 °C, el cordón de 3,21 a 2,87 A en su peor caso y
   > `U1` a 120,5 °C. `U2` (1,82 W) no tiene fila de la hoja que su cobre
   > cubra: se acota en el bring-up, con la subida de su aleta (paso 7,
   > `tj_budget.subida_max_aleta_k`). El cobre no cambia: la cascada sigue
   > ruteada para 650.

## 9. Lo que hay que firmar

| | Qué | Dónde | Estado |
|---|---|---|---|
| **D-V1** | la etapa AC-DC es **pieza de catálogo certificada**, fuera de la caja; no un cajón nuestro | §3 | **FIRMADA 2026-09-08** |
| **D-V2** | el ladrillo son **24 V** | §3 | **FIRMADA 2026-09-08** — dirección; **7 HUECOS arrastrados** a §9.2 |
| **D-V3** | el crudo de la cascada son **15,5 V**, ~~y con eso `U2` cierra en +311 mV~~ para ganar holgura en `U1` y D-F4, con el coste completo de §5 | §5 | **FIRMADA 2026-09-08** — sin HUECOS |
| **D-V4** | los rieles se derivan **dentro** con DC-DC; la cascada no se toca | §4 | ~~sin firmar — **no firmable aún**, ver junta §3~~ **FIRMADA 2026-09-08** — dirección, con M1–M5 opción A; enmienda por firma de Samuel, bloque siguiente |
| **D-V5** | el cordón es de **dos hilos**; no bajan rieles hechos | §3 | **FIRMADA 2026-09-08** — dirección; **9 HUECOS arrastrados** a §9.2 |

> ### D-V1, FIRMADA — 2026-09-08
>
> **La etapa AC-DC es una pieza de catálogo certificada, fuera de la caja.** No
> se diseña, no se acaba y no se certifica un cajón de red propio.
>
> La junta la dictaminó **firmable tal cual**: es el «cómo» mínimo del «qué» que
> Samuel ya había decidido el 05-09, y no compromete ni la tensión del ladrillo
> (D-V2) ni el reparto de dentro (D-V4). Se firma sola, y por eso se firma antes.
>
> **Lo que arrastra:**
>
> - **El #130 pierde sujeto.** «La entrada de red del chasis no tiene pieza» deja
>   de tener pregunta: no hay entrada de red en el chasis. Lo que quedaba vivo de
>   ese issue era el recorte del IEC C14 en la chapa, y ese recorte no existe.
>   **No se cierra aquí**: la lista de defunción es una decisión aparte, como en
>   la v4.
> - **D-F7** (`PS5` = IRM-45-5) pierde sujeto, y **las piezas de D-F5** (el Y2 de
>   modo común por módulo) se van con los IRM. Sus obligaciones **no** se van con
>   ellas: necesitan relevo nombrado en D-V4 y D-V5.
>
> **Lo que esta firma NO compra**, y conviene que quede escrito porque el papel
> lo insinúa: la comparación de «0 W» contra un cajón externo multirriel **no
> está calculada** — el guion solo modela los DC-DC de dentro. La firma se
> sostiene sin ese número; el número sigue siendo HUECO.
>
> **Lo que sigue sin contestar bajo D-V1**: «certificada» no dice clase,
> aislamiento, corriente de fuga, protecciones ni carga capacitiva admisible.
> Eso es el contrato de D-V2 — ~~y por eso D-V2 no se firma todavía~~ y viaja
> como `H-V2-AISLAMIENTO` en §9.2 (D-V2 se firmó el mismo día, en dirección).

> ### D-V2, D-V3 y D-V5, FIRMADAS — 2026-09-08
>
> **Se firma la DIRECCIÓN, no el detalle.** El ladrillo son **24 V**, el crudo
> de la cascada son **15,5 V**, y el cordón es de **dos hilos**. Con eso queda
> fijada la topología de transporte y la tensión de cada nodo nominal.
>
> **Ningún HUECO se da por contestado.** Los **16** que dejaron los contratos
> del 08-09 —7 de D-V2 y 9 de D-V5— **no** se cierran con esta firma: pasan
> enteros a §9.2 como trabajo previo a fabricar, con su dueño. Firmar la
> dirección no es haber medido nada.
>
> **Precedente, y por qué se puede hacer así:** D-V1 se firmó ese mismo día
> dejando abierto su hueco de aislamiento y remitiéndolo a D-V2. Una decisión
> de arquitectura se firma cuando su dirección es correcta y su coste está
> entendido; los números de pieza son trabajo de ingeniería posterior, no
> requisito de la firma. Lo que **sí** sería fabricar sobre un hueco es llevar
> esto a cobre sin cerrar §9.2 antes.
>
> **D-V3 es distinta: no arrastra nada.** No le faltaba ningún dato — le
> faltaba una decisión de criterio. El coste está calculado (**+0,78 W**: 0,33
> en `U1`, 0,33 en `U2`, 0,12 de conversión) y la holgura también (`U1` de
> **+330 a +811 mV**, y aire para el detector de D-F4 que vivía con +40 mV
> útiles). Samuel acepta el vatio a cambio del margen. **Queda cerrada.**
>
> **Lo que estas tres firmas NO tocan:** ~~**D-V4 sigue sin firmar** y sigue
> siendo el atasco — los dos bloqueantes de la junta (protección por riel y
> aislamiento de GNDD) no se resuelven aquí.~~ **ENMIENDA (2026-09-08, firma
> posterior de D-V4): M3 y M1 les dan dueño, respectivamente; su realización
> y acreditación siguen abiertas** (censo §3). Y **el #334 sigue abierto**: su
> pregunta viaja como `H-V2-CORTO-DCDC`. Que el nodo de fallo haya cambiado de
> origen no lo cierra.

> ### D-V4, FIRMADA — 2026-09-08
>
> **ENMIENDA (2026-09-08, firma de Samuel · §4 y
> [censo](2026-09-08-censo-dv4-resolucion.md) §1).** ~~No firmable aún~~
> **FIRMADA en DIRECCIÓN, con las cinco asignaciones como parte de la firma.**
> Los rieles se derivan dentro con DC-DC y la cascada de regulación se conserva.
> Samuel firmó **D-V4 opción A: «Firmar la dirección, con las cinco asignaciones
> como parte de la firma.»** Las asignaciones firmadas, todas **opción A** y
> sin matiz añadido, son:
>
> - **M1:** **Aislar solo el cerebro digital.** El convertidor del +5 digital
>   lleva barrera; el sonido y el rack comparten retorno, como ya lo compartían.
> - **M2:** **El chasis se agarra al retorno de continua**, y el modo común del
>   ladrillo se cierra fuera, con él.
> - **M3:** **Las tres cosas a la vez**: cada convertidor se protege solo, los
>   crowbars de rack de D-F6 se quedan, y `U1` lleva un tope delante.
> - **M4:** **Un detector analógico con un hilo**, como el de hoy, gobernando
>   los actuadores que se quedan.
> - **M5:** **Un vigilante propio en la entrada de los 24 V**, antes de los
>   convertidores.
>
> **Lo que arrastra:**
>
> - Los bloqueantes de la junta tienen dueño: **M3** reparte la protección por
>   riel; **M1** asigna la barrera de GNDD al convertidor digital. Faltan mapa
>   completo, piezas, límites, coordinación y pruebas; la aceptación entre
>   masas sigue siendo la de v4 §4.1 y §9.1 (censo §3.1/§3.2).
> - **D-F6 sigue firmada para el rack.** M3 conserva sus crowbars y les da el
>   relevo de protección propia por convertidor; el **SCR sigue sin hoja**
>   (`hardware/01-power-supply/v4/check_absmax.py:110`). El tope delante de `U1`
>   queda asignado, sin pieza ni límite elegidos; **H-V2-CORTO-DCDC / #334
>   sigue abierto**. M4 conserva el mando conjunto de D-F4 sobre sus actuadores
>   (censo §3.1 y §4). Falta demostrar la supervivencia digital; no se le firma
>   un crowbar ni una protección adicional por inferencia de M3.
> - Los **H-CENSO** del censo §6 siguen abiertos: ya tienen a quien preguntarle,
>   con las coberturas y límites de T16–T28 en §2.6. Se añade
>   **H-CENSO-ETA-DIGITAL** por el presupuesto de clase equivocada en §4;
>   no se reemplaza por una cifra nueva. **Que un trabajo tenga dueño no es
>   que esté hecho.** Los HUECOS heredados de §8, §9.2 y §9.3 tampoco se cierran.
> - **M2 hace de L14 una condición de compra:** si el candidato no documenta
>   la relación de su salida con PE, no sirve (pliego §3, L14). Falta acreditar
>   el relevo de modo común del conjunto; **H-V5-PE permanece abierto**.
>   **L03–L09** dejan de esperar la firma de D-V4, pero siguen en su casilla,
>   sin números, con sus dependencias externas y piezas por elegir
>   ([pliego](2026-09-08-pliego-ladrillo.md) §3.2; censo §5).
> - **Cobertura incompleta de T24:** M5 asigna el vigilante en la entrada,
>   pero **no asigna quién deja de energizar un corto del cordón aguas arriba**.
>   Ese tramo ~~**sigue sin dueño**~~ **tiene dueño desde el 2026-10-27: el
>   ladrillo certificado, para su cordón cautivo (§9.2, `H-V5-CORTO`)** en
>   **H-PL-ABANDONO-FUENTE** (pliego §4.1; censo §2.6). **El tramo nuestro,
>   del zócalo a `U16`, sigue fuera de M5: contra un corto franco ahí el
>   ladrillo reintenta sin fin ([mapa de fallos](2026-10-27-mapa-fallos-entrada-v5.md) §6).
>   Desde el 2026-10-27 se trata como el cordón: lo protege el ladrillo, y sus
>   piezas se dimensionan para la corriente más alta que sostiene sin disparar
>   (§9.2, `H-V5-CORTO`).** Las asignaciones firmadas no cubren íntegramente el conjunto
>   mínimo anunciado por el censo; se registra la carencia sin completar M5.
>
> **Lo que esta firma NO compra:** no cierra ningún HUECO ni issue, no elige
> ninguna pieza, no acredita garantías ni ensayos y **no autoriza fabricar**.
> La firma es dirección, con el mismo alcance de D-V2 y D-V5. Ninguna de las
> asignaciones se da por ejecutada por tener responsable.
>
> **El séptimo punto NO se firmó:** «¿Corregir la polaridad rearma el cupo de
> reintentos?» sigue exactamente como **obligación abierta, sin dueño**, en
> §9.3. No se contesta aquí ni se infiere de M5; queda fuera de esta firma.
> **Se contestó aparte el 2026-10-27 (§9.3, enmienda de esa fecha).**

### 9.2 Los 16 HUECOS que arrastran D-V2 y D-V5

Esta lista es **la condición de fabricación**, no una lista de deseos: ninguna
de las dos firmas autoriza cobre mientras tenga filas abiertas. El «dueño» sale
de cómo el propio contrato del 08-09 formula cada pregunta — *al fabricante*,
*a Samuel*, o sin destinatario, que es trabajo nuestro.

> **ENMIENDA (2026-10-27, firma de Samuel).** Una fila o condición que solo se
> puede cerrar ensayando la placa construida pasa al bring-up (hito 2) y **no
> bloquea fabricar la primera placa**: esa placa es el banco de ensayo. Bloquea
> el cobre lo que todavía puede cambiar la placa. Es la regla que ya se aplicó a
> `H-V2-CORTO-DCDC` el 25-10, extendida a todas las filas.

> **ENMIENDA (2026-10-27, segunda firma de Samuel).** Por la misma razón, una
> fila que solo toca el panel trasero y el cordón, y no puede cambiar la placa,
> tampoco bloquea su cobre: bloquea el panel y el chasis (#424). Son
> `H-V5-CONECTOR` (#488) y `H-V5-RETENCION`. Siguen siendo condición para
> fabricar el panel.

> **ENMIENDA (2026-10-27, tercera firma de Samuel).** `H-V5-PE` tampoco
> bloquea el cobre. Lo que le toca a la placa ya está en ella: `J5`, el único
> puente de `GNDA` al chasis, y `NT1`, la única unión de `GND24` y `GNDA`. Lo
> que falta vive fuera: el convertidor aislado de la pantalla (#480), el
> espárrago del chasis y el hilo de `J5` hasta él (#424, hito 6), y el ensayo
> del conjunto, que pide la placa construida (primera enmienda). La fila sigue
> abierta con su mapa, su evidencia y su ensayo, y sigue siendo condición para
> fabricar la pantalla y el chasis.

| HUECO | Qué falta | Dueño |
|---|---|---|
| `H-V2-ENTRADA` | ventana garantizada del ladrillo y de los DC-DC, con las caídas del cordón dentro | **fabricante** |
| `H-V2-SUBTENSION` | arranque, inhibición, histéresis y tiempos, y su coordinación con D-F4 | diseño |
| `H-V2-TRANSITORIOS` | envolvente admisible en cada interfaz, y quién limita lo que llega a los pre-reguladores | diseño |
| `H-V2-RESERVA` | carga capacitiva y corriente de arranque admisibles, contra lo que la cadena exige | **fabricante** |
| `H-V2-RECUPERACION` | ~~política de rearranque~~ **decidida 08-09: reintentos con abandono (§9.3)**; faltan intervalo, cupo, condición de abandono y estado de rieles | ~~**Samuel** +~~ fabricante |
| `H-V2-CORTO-DCDC` | ~~qué limita el corto entrada↔salida antes de `IN` de `U1` — **es el #334**~~ **cerrado en diseño el 2026-10-25 (#334, §3): `U19` corta por disparo rápido, con `L2` = SRP1265A-220M; 17,40 V de pico en el peor caso.** Su ensayo (paso 8 del bring-up) necesita la placa y no bloquea el cobre | diseño |
| `H-V2-AISLAMIENTO` | ~~clase, aislamiento y fuga de la referencia, con hoja o certificado~~ **decidido 2026-10-27 (firma de Samuel): el aislamiento red↔secundario y la fuga los da el ladrillo certificado, y el SAM17 es una carga de 24 V DC en ES1, clase III, sin borne de PE.** Requisito al ladrillo, tomado de su hoja: EN/CSA/IEC/UL 62368-1 (no 60601-1); 4000 VAC entrada↔salida, 1500 VAC entrada↔tierra y salida↔tierra; fuga < 500 µA entrada↔tierra y < 4 mA salida↔tierra a 264 VAC, 60 Hz (`ae-TE90-datasheet.pdf` p. 2); variante A, salida sin unir a tierra (p. 5, nota 3). Falta que AE diga qué mide la cifra de 4 mA en la variante A, la corriente de contacto en la salida con PE abierto, el grado del aislamiento y el informe CB (caso P-258801) | **fabricante** |
| `H-V5-CONECTOR` | pareja y polaridad, con hoja que acredite límites y resistencia de contacto. **No bloquea el cobre de la placa (segunda enmienda de arriba): `X1` va en el panel trasero; sigue en #488** | diseño |
| `H-V5-RETENCION` | ~~retención y alivio de tracción, con su ensayo~~ **decidido 2026-10-27 (firma de Samuel): el cordón se queda enganchado con el Snap n Lock de la opción 49 (`ae-TE90-datasheet.pdf` p. 6), y una abrazadera en el panel trasero toma el tirón antes de que llegue a `X1` y a sus tornillos M2,5.** Va con #424, que ya tiene que elegir la pieza que toma el tirón del cordón. Faltan la pieza y su ensayo; Kycon no publica fuerza de retención ni de extracción de la clavija ni del receptáculo. Referencia ESTIMADA: 100 N, 25 tirones de 1 s y torsión, con menos de 2 mm de deslizamiento (IEC 62368-1 G.7.3.2.1, citada por proveedores de equipos de ensayo y no leída en la norma; 100 N es el tramo de más de 4 kg, y la masa del SAM17 no está escrita). No bloquea el cobre de la placa (segunda enmienda de arriba) | diseño |
| `H-V5-CALIBRE` | calibre, longitud y resistencia total vinculantes | diseño |
| `H-V5-INVERSION` | ~~qué pasa con polaridad inversa~~ **decidido 08-09: bloquear y recuperar al corregir (§9.3)**; ~~faltan el elemento, su envolvente y su caída~~ **cerrado en diseño el 2026-10-27, por la enmienda de arriba: `U15` (LM74502) con `Q2` en el positivo y `Q7` en el retorno, con su caída en `ladrillo_budget.py`. Sus ensayos con el ladrillo al revés son del paso 1 del bring-up (`check_bringup.py`).** La obligación de §9.3 sobre el cupo ~~sigue aparte~~ **se contestó el 2026-10-27 (§9.3)** | diseño |
| `H-V5-CALIENTE` | ~~si se admite conectar en caliente~~ **decidido 08-09: desenergizado como norma, accidente cubierto (§9.3)**; falta la envolvente de supervivencia | diseño |
| `H-V5-RECONEXION` | ~~rearranque con energía residual o rebote~~ **derivado 08-09 de `H-V2-RECUPERACION` (§9.3)**; falta separar un rebote de un intento legítimo | diseño |
| `H-V5-CORTO` | corto entre conductores o contra chasis, incluido el tramo de cable expuesto. **Decidido 2026-10-27 (firma de Samuel): el cordón cautivo, aguas arriba de nuestro zócalo, es del ladrillo certificado, y le toca a su certificación.** ~~Un corto franco en hiccup son unos 2,4 W~~ **(corregido el mismo día: esos 2,4 W son la I²R del cordón de escenario, 16 AWG y 2 m, con 6,75 A continuos; no son el hiccup, cuyo pico no se publica, ni el cordón del TE90; [mapa de fallos](2026-10-27-mapa-fallos-entrada-v5.md) §4.1)**; uno parcial por debajo del disparo de sobrecarga son de 117 a 162 W (4,875–6,75 A, típicos) sin disparar nada. A AE se le preguntan el hiccup (encendido, apagado y pico), la corriente máxima sin disparo y la clasificación PS/LPS de la salida. ~~Falta el mapa de fallos de nuestro tramo, del zócalo a `U16`~~ **El [mapa de fallos](2026-10-27-mapa-fallos-entrada-v5.md) (2026-10-27) cierra la parte de papel: delante de `U16` nada nuestro para un corto parcial y no hay abandono, y detrás lo cubren `U16` y M5 (§6). Quedan sus HUECOS `H-MF-*` (§7) y dos ensayos de banco (§8)**. **Decidido 2026-10-27 (firma de Samuel): nuestro tramo delante de `U16` (`X1`, el arnés de 0,3 m, `J1` y el cobre hasta `U16`) se trata como el cordón: lo protege solo el ladrillo certificado, y sus piezas se dimensionan para la corriente más alta que el ladrillo sostiene sin disparar (`H-MF-SOSTENIDA`, pregunta 5 a AE en el caso P-258801).** Un fusible ahí no ayuda: el que aguante el límite de `U16` (hasta 4,87 A durante 202 ms, en cada uno de los 4 pulsos de un abandono, `recuperacion_budget.py`) no abre a tiempo un corto parcial por debajo del disparo del ladrillo, 9 mA más arriba | diseño |
| `H-V5-INCOMPATIBLE` | ~~qué adaptadores cubre el contrato~~ **decidido 08-09: contrato exclusivo (§9.3)**; faltan las referencias admitidas y su acreditación | ~~**Samuel** +~~ diseño |
| `H-V5-PE` | **relevo de D-F5**: ~~quién da el camino de modo común~~ **M2 lo asigna fuera, con el ladrillo, y une chasis al retorno DC (firma 2026-09-08, §9)**; faltan mapa, evidencia y ensayo, preservando GNDD por M1; **HUECO abierto**. **2026-10-27 (firma de Samuel): no cambia la placa.** El encuentro de `GNDD` y `GNDA` en la pantalla se resuelve en #480 con un convertidor aislado en la pantalla (§8, punto 2); el chasis, su unión al retorno y la entrada del cordón, en #424 (hito 6). Con el SAM17 en clase III, el espárrago de #424 es la unión M2 del chasis al retorno DC, no un borne de PE. **No bloquea el cobre de la placa (tercera enmienda de arriba): `J5` y `NT1` ya están en ella; sigue en #480, #424 y el bring-up** | diseño + medida |

**Tres de estas filas no son independientes:** `H-V5-CALIENTE` tiene que
coincidir con `H-V2-TRANSITORIOS` y `H-V2-RESERVA`, y `H-V5-RECONEXION` ~~sigue
la política que se elija en~~ **hereda la ya elegida en** `H-V2-RECUPERACION`
(§9.3, 08-09). Contestarlas por separado es una forma de contradecirse.

Y una que este papel **no** propone y hay que decidir aparte: ~~si la cascada
sigue declarando 650 mA/riel contra un censo de 334 (HUECO 5)~~ **decidida el
2026-10-23: 450 mA/riel (§8, punto 5)**.

### 9.3 Las cuatro políticas, decididas — 2026-09-08

Los dos documentos de resolución —`2026-09-08-huecos-dv2-resolucion.md` y
`2026-09-08-huecos-dv5-resolucion.md`— separaron los 16 HUECOS en **once
requisitos comprables** y **cinco decisiones**. Las cuatro decisiones
independientes quedan tomadas hoy; la quinta se deriva de una de ellas.

**Elegir la política no cierra su HUECO.** Compra la dirección, igual que la
firma de D-V2 y D-V5: los números —cuánta corriente, cuánto tiempo, cuántos
milivoltios— siguen viviendo en `H-V2-RESERVA`, `H-V2-TRANSITORIOS` y
`H-V2-ENTRADA`, que son de fabricante. Lo que cambia es que **ya no hace falta
decidir nada para poder preguntar.**

**`H-V2-RECUPERACION`: reintentos con abandono.** La cadena reintenta un número
declarado de veces, con espera entre intentos, y se rinde si el fallo persiste.
~~La razón no es preferencia, es **restitución**: el hiccup nativo de los IRM
hacía exactamente esto~~ **— corregido el 08-09: el hiccup hacía la mitad.** Su
hoja dice «Hiccup mode, recovers automatically after fault condition is removed»
(p. 2, citada en `check_absmax.py:26`): reintentaba **sin límite** y volvía sola
al desaparecer el fallo. Nunca abandonaba. El reintento sí es restitución —la v5
retira los IRM sin sustituto declarado (§7)—, pero **el abandono es añadido
nuestro, y deliberado**: volver sola sin límite, que es justo lo que hacía el
IRM, deja ciclar indefinidamente contra un corto permanente del DC-DC; enclavar
hasta intervención convierte un parpadeo de red en una visita al taller. La
decisión no cambia; lo que no se sostenía era llamarla restitución entera.

**`H-V5-INCOMPATIBLE`: contrato exclusivo.** Se acredita una referencia de
ladrillo y una de cordón, y los adaptadores ajenos quedan **fuera de la
garantía eléctrica**, declarado y no sobreentendido. El SAM17 se vende entero:
prometer supervivencia a fuentes que no elegimos es certificar lo que no
controlamos. Lo que esta decisión **no** compra: que otro adaptador encaje
físicamente sigue siendo posible. Una exclusión de contrato no es una
protección.

**`H-V5-INVERSION`: bloquear, y recuperar al corregir.** Un elemento físico
impide que la polaridad inversa llegue a nada, y al corregirla la cadena
arranca sola si sus condiciones vuelven a ser válidas. Es la única de las
cuatro que **excede el contrato exclusivo a propósito**, y por la misma razón
que lo justifica: precisamente porque el conector va a admitir adaptadores que
el contrato no cubre, el error más probable de todos no puede quedarse sin
nada delante.

**`H-V5-CALIENTE`: desenergizado como norma, accidente cubierto.** La maniobra
documentada es acoplar el cordón con el ladrillo apagado. Pero la conexión en
caliente accidental queda **expresamente cubierta**: se exige supervivencia, no
funcionamiento. Una instrucción de uso no es una protección física, y este
instrumento se enchufa y se desenchufa a menudo.

**`H-V5-RECONEXION` no se decide: se deriva.** Hereda «reintentos con abandono»
también cuando la caída venga del cordón.

#### Las tres obligaciones que nacen de estas cuatro

Ninguna existía antes de decidir. Son consecuencia de las elecciones, no
HUECOS que estuvieran escondidos, y van a la condición de fabricación:

| Obligación nueva | De dónde sale |
|---|---|
| **El rebote de contactos no puede gastar reintentos.** Un cupo que se consume solo con enchufar y desenchufar no protege de nada. Hay que declarar qué separa un intento legítimo de un rebote. | `H-V5-RECONEXION` heredando reintentos |
| **Corregir la polaridad, ¿rearma el cupo?** Si el bloqueo por inversión gastó intentos, corregir el cable tiene que poder volver a arrancar. Falta decir si el cupo se reinicia y bajo qué condición. **Contestada el 2026-10-27 (enmienda de abajo).** | cruce `H-V5-INVERSION` × `H-V2-RECUPERACION` |
| **La caída del bloqueo de inversión se paga en `H-V2-ENTRADA`.** El elemento que responde a la polaridad inversa va en serie y consume saldo de la misma ventana que todavía no tiene extremos. | cruce `H-V5-INVERSION` × `H-V2-ENTRADA` |

> **ENMIENDA (2026-09-08, alcance de la firma D-V4/M1–M5 · §9).** La fila
> «Corregir la polaridad, ¿rearma el cupo?» se conserva **sin contestar y sin
> dueño**. Ese séptimo punto no se firmó: no hay condición de rearme elegida
> ni se deduce una respuesta o una asignación de M5. Sigue siendo obligación
> abierta en la condición de fabricación.

> **ENMIENDA (2026-10-27, firma de Samuel).** Contestada: **una inversión no
> gasta reintentos, así que corregirla no rearma nada; el cupo queda como estaba
> antes del enchufe al revés, y un abandono anterior solo lo libera el botón.**
> Con el ladrillo al revés, `Q7` corta el retorno y `GND24` queda suelto: ni
> `U18` (el LDO del vigilante, por `R64` desde `+24V_PROT`, detrás de `Q2`) ni
> `U17` llegan a encender, y no hay quien cuente. El abandono anterior sigue en
> la FRAM (`recuperacion_budget.py`, «un abandono NO se borra desenchufando»).
> Esa topología la vigila `recuperacion_budget.py` contra la netlist, y el
> ensayo es del paso 1 del bring-up (`inversion_J1_no_gasta_intento`).

Y la que ya estaba y ahora tiene dueño único: **la envolvente de supervivencia
del enchufe en caliente accidental sigue sin número**, porque vive en
`H-V2-RESERVA` y `H-V2-TRANSITORIOS`. La política está elegida; el límite no.

**Lo que estas cuatro decisiones NO tocan:** ningún HUECO queda cerrado, ~~D-V4
sigue sin firmar~~ **D-V4 se firmó por separado en dirección el 2026-09-08,
con M1–M5 (§9; enmienda por firma de Samuel)**, y el **#334** sigue abierto — `H-V2-CORTO-DCDC` es un
requisito comprable, no una política, y no había nada que decidir en él hoy.
