sssamuelll/sam17/case/PLIEGO.md

# Pliego de fabricación — cuerpo del SAM17

> **rev. 30 (2026-10-26). La escuadra del enchufe de 24 V (#130).** Samuel,
> el 2026-10-26: una L sobre el suelo. **Entra `escuadra_enchufe_2d`** (§6,
> tabla de abajo): chapa 6082-T6 de 2 mm anodizada en negro, **un doblez**, que
> sostiene el enchufe Kycon KPJX-PM-4S de la entrada de red. **A la chapa**:
> dos agujeros de paso Ø4.5 más en el pie del talón y dos M4 de paso más en la
> base, que pasa de **20 a 22** taladros de fijación y de **10 a 12** M4 de paso.
> **A la prensa de insertos**: **dos CLS-M4 más**, ocho en total. **Al
> acrílico**: la ventana de la trasera pasa de 48 × 27.5 a **30 × 18 con las
> esquinas a R3**, con el mismo centro (la eligió Samuel entre tres renders), y
> la rejilla de entrada gana la columna de ranuras que la ventana vieja tapaba
> a su izquierda: 47 ranuras en vez de 46.
>
> **rev. 29 (2026-10-12). La tabla de nogal se cambia por una base de chapa**
> (papel `docs/superpowers/specs/2026-10-12-case-suelo-design.md`, firmado en
> el acta 4). **`bandeja_base_2d` vuelve a este pliego**: chapa 6082-T6 de 3 mm
> anodizada en negro, a ras de la huella del cuerpo (**307.76 × 568.62**), con
> **1118 agujeros de Ø5 cada 8** (21 952 mm² abiertos) y 20 taladros de
> fijación, al **taller de chapa** (§6.2). **Se va el carpintero.** **Insertos de
> presión** de acero o inoxidable, nunca de la serie de aluminio, **prensados
> después de anodizar**: 6 tuercas CLS-M4 en los pies de nariz y talón y 4
> espárragos FH-M4 en la base. Los M4 de nariz y talón entran **desde abajo**.
> **Al anillo (§6.1)**: un círculo de Ø12 sin anodizar en el canto inferior,
> alrededor de un M5, para la masa de la base. **Condiciones de uso (§7)**: mesa
> dura bajo las patas, y las patas se compran firmes. Esta revisión sustituye
> las cotas operativas de la rev. 28 donde chocan.
>
> **rev. 28 (2026-10-11). La persiana sustituye a las mejillas de acrílico**
> (papel `docs/superpowers/specs/2026-10-11-case-persiana-design.md`). **Sale
> `costado_2d`**: el PMMA naranja se queda en una sola pieza, la trasera.
> **Entra la persiana** (§6.3): dos placas de aluminio de 6, espejadas, con 44
> varillas de 2 y diez tacos en el dorso, en tres DXF (`persiana_2d`,
> `persiana_pasante_2d`, `persiana_dorso_2d`). **Al mecanizado del anillo
> (§6.1)**: diez bolsillos por la cara de fuera para los tacos, en
> `costilla_bolsillos_2d`; el rebaje del costado se queda, vacío. **Al
> anodizado (§6.4)**: todo el aluminio que se ve va en negro, con una aleación,
> un anodizador y un lote; el anillo deja de ser «satinado». **Se compran**
> 20 pares de imanes de neodimio (§6.5). Muere la junta de asiento EPDM del
> costado. **A la chapa (ficha 6, D-S9)**: la nariz y el techo bajan hasta
> pisar la cara del riel y cierran las dos rendijas: `retiro_placa_inf` pasa de
> 9 a 11.9 y el retorno del techo de 4 a 9. Crecen los dos blanks: la nariz a
> **545.62 × 53.10** y el techo a **593.02 × 78.85**. Esta revisión sustituye las cotas operativas de la rev. 27 donde
> chocan; su bloque se conserva debajo como historia.
>
> **rev. 27 (2026-08-30). Tanda A: techo macizo y tres chapas empotradas.**
> **Al mecanizado:** cada anillo gana el rebaje de chapa de 4.5 de ancho × 3
> de fondo y un cajeado de brida de 28 × 15.5 × 3; son dos al fabricar el par.
> También cambian los radios a 5.5
> donde hay chapa y la franja trasera de 23. El cupón gana el rebaje y su
> reborde de 1 × 3. **A la chapa:** el techo queda sin ranuras, con labio de
> 20 y bridas con esquinas R2; techo, talón y nariz pasan a los blanks
> vigentes y los dos pies llevan muescas hasta su línea de doblez, con alivio.
> **Juntas:** doce tacos adhesivos de EPDM de 4.0 × 15 sustituyen las dos
> tiras continuas. Esta revisión sustituye las cotas operativas de la rev. 26;
> su bloque se conserva debajo como historia.
>
> **Corrección térmica del 2026-08-30.** La primera versión fijó la rendija en
> 3.0 por capilaridad. Después de hacer que las dos puertas usaran la luz
> comprimida, quedaban 0.2 K contra el techo de 15. La luz sube a 4.0 nominal
> y 3.20 comprimida: quedan 1.4 K en el aviso y la subida capilar baja a 4.7.
> Esto mueve 1 mm la trasera, la franja, el marco y los dos pies. El razonamiento
> anterior se conserva en la spec de diseño; esta es la cota de fabricación.
>
> **rev. 26 (2026-08-29, más noche; corregida tras el PR).** La trasera
> capturada como las mejillas y el talón como la nariz. **Al mecanizado**: en la cara interior
> de cada anillo, un **bolsillo de 11 × 6** a lo largo del tramo trasero
> (para las puntas de la trasera: labio de 3 al canto, 6 de hondo),
> **cerrado por los dos extremos** — de 1 mm del canto de abajo a 17 del de
> arriba, con un **escalón** bajo el chaflán de P6 (ahí arranca a 5.5 del
> plano trasero, no a 3) —; y el **contorno del rebaje
> retirado a 17** en ese tramo (la pared de 3 entre los dos bolsillos); **P6
> a chaflán 6** como P0 (y **P5** con el techo en chaflán).
> `costilla_dorso_2d` lleva el bolsillo como polígono aparte; su profundidad
> va aquí (§6.1). **A la chapa**: `talon_2d` es la nariz en espejo (labio 13,
> chaflán, pie 20; dos dobleces a 45°; **ocho ventanas de pestaña en U**) y
> `miembro_alto_2d` baja con chaflán + labio de 18 (variante B) en vez de la
> banda, con un relieve en las bridas. **Al acrílico**: `piel_trasera_2d` de
> 552.32 × 237.18 **sin un taladro**, con un **chaflán de 5.5 × 45° en su arista
> de abajo-fuera** por todo el largo (§6: no está en el DXF); `kondor_cajeado_2d`
> es solo la palabra. Mueren los 10 M3 con sus tuercas, arandelas de nylon y d16.
> **Juntas**: EPDM de 1 en el bolsillo de la trasera (como en el del costado)
> y tiras de 2.5 tras los labios. Spec
> `2026-08-29-trasera-capturada-talon-nariz-design.md`.
>
> **rev. 25 (2026-08-29, noche).** Cinco piezas en cuestión, cuatro que
> quedan. **Entra `marco_ventana_2d`** — la pletina de 6 con el contorno de la
> ventana del anillo, una por costado, espejadas por el cajeado — y **salen
> siete DXF**: las tres placas, `clip_2d`, `escuadra_trasera_2d`,
> `marco_trasera_sup_2d` y `marco_trasera_inf_2d`. **`miembro_alto_2d` cambia
> de desarrollo** (una L: banda de 24, meseta de 50 y retorno, con dos bridas
> de la banda; sale el retorno de 24 del canal) y **entra `talon_2d`** (banda
> de 24 + pie de 22, un doblez) en vez de `miembro_bajo_2d`. La trasera pierde
> seis taladros y gana dos muescas de esquina; la tabla lleva siete taladros
> más; el anillo pasa de 16 a **14 roscas ciegas** y su esquina de abajo-atrás
> a radio 4.5. El chasis de acero pierde los dos M5 de pared y gana cuatro M4
> en el suelo. `costilla_2d` y `costilla_dorso_2d` se regeneran; el cupón
> (§6.1) no cambia.
>
> **rev. 24 (2026-08-29, tarde).** Tres notas de Samuel sobre el aluminio.
> **Entra `nariz_2d`** — la banda del frente, chapa de 1.5 con TRES dobleces
> (45°, 45°, 35°) y tres M4 al pie —, **`miembro_alto_2d` crece** (la meseta
> llega al pico y gana un cuarto doblez, el retorno a 45°), y **sale
> `bahia_2d`** con sus dos roscas de la placa del valle. El anillo cambia de
> contorno en la nariz (chaflán de 6 a 45° + radios 4.5) y en las dos esquinas
> del techo (radio 4.5): `costilla_2d` y `costilla_dorso_2d` se regeneran, el
> cupón (§6.1) no cambia. La tabla lleva tres taladros más.
>
> **rev. 23 (2026-08-29).** La trasera deja de ser la pieza más exterior de
> la cara de atrás: se rehunde `t_costilla` y la enmarcan **dos bandas de
> chapa** (`marco_trasera_sup_2d`, `marco_trasera_inf_2d`). Hasta hoy sus
> cantos superior e inferior corrían 540 mm cada uno sin metal encima, y el
> de arriba eran además los últimos 8 mm del pico del case. Entra también el
> plano que faltaba del anillo: **`cupon_anillo_2d`**, la sección, con el
> cupón convertido en **punto de parada** antes de cortar los dos anillos.
>
> **rev. 22 (2026-08-28).** La costilla deja de ser **chapa de aluminio
> plegada** y pasa a **anillo de pletina mecanizada** (§6.1): una pieza
> sólida por lado, sin soldadura ni ala doblada, con roscas ciegas donde
> antes había tornillo pasante. Son **seis** talleres, no cinco — acrílico,
> chapa de aluminio (miembros con bridas, placas, clips, escuadras, las dos
> bandas del marco trasero y la tapa del valle), **mecanizado de aluminio**
> (el anillo y su cupón, taller nuevo),
> acero, madera y los rieles comprados. Cada sección dice a cuál va.
>
> **rev. 21 (2026-08-27).** Dejó de ser «el pliego de acrílico»: el case
> pasó a estructura de aluminio y el acrílico bajó a piel.

Este documento **acompaña a los DXF y no es opcional**. Un DXF solo es media
pieza: lleva la geometría de corte y no dice material, espesor, acabado,
profundidad de cajeado ni qué cara es la exterior. Sin esto, esos huecos los
rellena el taller con sus supuestos.

Para elegir taller antes de pedir, ver [`RFQ.md`](RFQ.md).

---

## 1. Material

- **PMMA COLADO (GS)**, naranja translúcido. **NO extruido (XT)**: el
  extruido trae tensión interna de fábrica y craquela solo.
- **Una sola pieza desde la rev. 28: la trasera** (`piel_trasera_2d`). Las dos
  mejillas (`costado_2d`) las sustituyó la persiana, que es de aluminio y va
  al taller de mecanizado (§6.3).
- Espesor: **8 mm**, y es el único. Hubo dos hasta el 2026-08-25: los 5 mm
  existían para una sola pieza —la tapa del valle— y esa pieza pasó a
  **chapa de aluminio**, así que no entra en este pliego (§6).
- Tolerancia de espesor conocida y aceptada: **±(0.4 + 0.1 × espesor)**, o
  sea ±1.2 mm en 8. Confirmada por escrito por Schaeffer AG el 2026-08-18.
- **Comunicar el espesor real medido del lote ANTES de cortar.** No es
  cortesía: hay cotas del diseño derivadas del espesor. `marco_sup` **es** el
  espesor de una plancha, y de él cuelga una junta que el modelo exige que
  valga exactamente cero.

## 2. Proceso

- **Fresado CNC.** No láser: deja canto cónico en 8 mm y microfisura en los
  bordes cargados.
- Fresa asumida **⌀3 mm** (radio interior 1.5). **Avisar si se usa otra**:
  hay geometría acotada contra ese número, incluido el relieve de §4.
- Los DXF están **a cota final**: el CAM compensa el radio de herramienta
  como parte normal del trabajo. **No aplicar sobre-medida.**
- Unidades de los DXF: **milímetros** (implícitas en el fichero).
- Tolerancia de posición requerida entre filas de agujeros de una misma
  placa: **±0.05 mm**. El separador de una placa es uno solo, así que dos
  filas que no apoyen a la misma distancia dejan una atornillada al aire.

## 3. Acabados — los tres que hacen el producto

### 3.1 RECOCIDO (annealing) — obligatorio

**Después de mecanizar y de pulir.** El fresado deja tensión atrapada
alrededor de cada agujero y cada canto; sin recocer, el PMMA craquela en
meses — una telaraña de grietas finas que empieza por los taladros y se
acelera donde hay un tornillo apretado o donde tocó un limpiador. No se ve
al desembalar.

**Indicar temperatura y rampa empleadas** en el albarán.

### 3.2 Canto

| dónde | acabado |
|---|---|
| **canto visible** (contorno exterior de las piezas: eran ~7.5 m con las mejillas) | **PULIDO DIAMANTADO en máquina** |
| **canto interior** (ranuras, ondas, taladros, ~10 m) | tal cual sale de fresa |

**PULIDO A LLAMA PROHIBIDO.** Mete tensión superficial y deshace el
recocido; en colado craquela cerca de los agujeros.

El acrílico es translúcido: la luz viaja por dentro de la plancha y sale por
el canto. Un canto áspero se lee como una línea blanca lechosa rodeando cada
pieza; uno diamantado se enciende del color del cuerpo.

**Desde la rev. 28 ningún canto de acrílico queda a la vista**: la trasera es
la única pieza, y sus cuatro cantos van dentro de los bolsillos del anillo y
tras los labios del techo y del talón. Si el diamantado sigue siendo condición
del taller lo decide Samuel (HUECO); hasta entonces se pide.

### 3.3 Chaflán

**0.5 × 45° en toda arista vista**, mecanizado (no lijado a mano).

(Hasta la rev. 28 incluía las dos esquinas traseras del costado, a arista
viva por diseño. El costado ya no es de acrílico.)

## 4. Cajeado ciego — la operación que el DXF no describe

`kondor_cajeado_2d.dxf` **no es un recorte**: es un **vaciado a 4.0 mm de
profundidad** en la **cara exterior** de `piel_trasera_2d`. **No atraviesa**
la plancha de 8 mm. Trae **solo la palabra** (los dos rebajes de esquina que
llevó unas horas el 2026-08-29 murieron con la salida de abajo del bolsillo:
la trasera ya no pasa por ninguna boca, entra con el anillo).

- El fichero está dibujado **tal como debe verse desde fuera**: la palabra se
  lee del derecho.
- La letra es Franklin Gothic Medium; el contorno ya viene convertido a
  curvas en el DXF, no hace falta la fuente.
- Trazo mínimo verificado contra fresa de 3 mm. Si se usa fresa mayor de
  4 mm, **avisar antes de cortar**.

## 5. Orientación — la trasera tiene cara

`piel_trasera_2d` **tiene cara exterior y cara interior** desde que lleva el
cajeado. **La cara exterior es la del vaciado.** Montada al revés, el relieve
queda hacia dentro y la palabra se lee invertida.

Las demás piezas son indiferentes al lado.

## 6. Piezas

| DXF | espesor | uds | notas |
|---|---|---|---|
| `piel_trasera_2d` | 8 | 1 | **+ `kondor_cajeado_2d` a 4 mm en la cara exterior** (§4, §5). **Sin un taladro** desde el 2026-08-29 (más noche): va CAPTURADA, con sus puntas en los bolsillos del tramo trasero de los anillos (5.85 por punta), sobre el pie del talón y bajo el fin del bolsillo. **Un chaflán de 5.5 × 45° en la arista de abajo por la cara exterior**, a lo largo de los 552.32 — cota que el DXF no sabe decir: se pide aquí, como el diamantado. Es lo que libra el escalón del bolsillo bajo el chaflán del anillo con la plancha en el fondo del bolsillo y pegada al labio; deja 2.5 de canto plano sobre el pie y queda escondido detrás del labio del talón. **552.32 × 237.18** |
| `coupon.dxf` | 8 | 1 | pieza de calibración — **sin acabado, sin recocer** |

**`remate_sup_2d` NO EXISTE.** Hasta el 2026-08-27 era la tapa de remate en
acrílico, atornillada de canto al larguero de remate trasero; ese día la
meseta del techo pasó a ser el ala del propio miembro trasero alto (doblada
de su blank, `marco_sup`), no una plancha aparte. `remate_sup()` y
`remate_sup_2d()` se borraron del `.scad` en el fix round 1 de esta tarea
(2026-08-28, sin llamador confirmado por grep). No es un pendiente de
`export.ps1`: la pieza no está en el diseño.

**`bandeja_base_2d` vuelve a este pliego el 2026-10-12 (rev. 29)**, ahora de
chapa de aluminio: va al taller de chapa (§6.2 y la tabla de abajo). Fue
acrílico de 8 hasta el 2026-08-27 y tabla de nogal de 30 hasta la rev. 29.

**Y el costado dejó de ser de acrílico el 2026-10-11 (rev. 28).** Desde el
27-08 era piel sin un taladro, asentada en el rebaje del anillo sobre una junta
de EPDM de 1 mm y retenida hacia dentro por el marco de la ventana. Lo
sustituye la **persiana**, de aluminio anodizado en negro, que va al taller de
mecanizado (§6.3). El rebaje del anillo se queda vacío y la junta del costado
no se compra.

**`lienzo_2d.dxf` es solo previsualización de nesteado: NO SE CORTA.**

### Lo que NO va a este taller

Diecisiete DXF de `case/plans/` **no son de acrílico** y no entran aquí. Se
reparten entre dos talleres — chapa (§6.2) y mecanizado (§6.1 y §6.3) —, y
chapa y mecanizado **no son el mismo** desde el 2026-08-28. Todo el
aluminio que se ve pasa después por un solo anodizador (§6.4):

| DXF | material | taller | proceso |
|---|---|---|---|
| `chasis_cuerpo_2d`, `chasis_tapa_2d`, `chasis_refuerzo_2d` | acero | chapa | corte + **plegado** |
| `miembro_alto_2d` | aluminio 6082-T6, 1.5 mm | chapa | corte + **plegado**: techo **sin ranuras**, blank **593.02 × 78.85**, meseta de 50, retorno de **9** (ficha 6), chaflán de 6 y labio de 20. Dos bridas de 27 × 14.5 con esquinas R2. Entran en los cajeados del anillo; no se dejan sobre la cara — **1 ud** |
| `talon_2d` | aluminio 6082-T6, 1.5 mm | chapa | corte + **plegado**: blank **545.62 × 42.23**, labio de 13, chaflán y pie de **22.5**. En el pie, tres agujeros de **5.4** a 7.0 del canto libre para las tuercas CLS-M4, que se prensan después de anodizar (el M4 entra desde abajo, rev. 29), y **dos agujeros de paso Ø4.5** a 7.5 del canto libre, para los M4 de la escuadra del enchufe (rev. 30). En cada punta del pie, muesca de 2.65 hasta la línea de doblez a 22.06, con alivio de Ø2 a caballo de la esquina interior. Conserva sus ocho pestañas lanzadas; el 6082-T6 sigue siendo obligatorio — **1 ud** |
| `escuadra_enchufe_2d` | aluminio 6082-T6, **2 mm**, anodizado negro (§6.4) | chapa | corte + **plegado, UN doblez a 90°**: blank **55.00 × 67.84**, radio interior **2 (1 t)**. Es la L que sostiene el enchufe de 24 V: la **placa** cierra por dentro la ventana de la trasera y el **pie**, en **dos lenguetas**, se apoya sobre el pie del talón. El DXF se ve **por la cara de dentro del doblez** (la del enchufe) y el doblez sube hacia el observador; los dos cantos de abajo de las lenguetas son el canto libre del pie. Trae: dos agujeros de **5.4** a 7.0 del canto libre para las tuercas CLS-M4, que se prensan **después de anodizar**; un taladro de **10.0** para la nariz de la clavija y dos de **2.9** para los M2.5 del enchufe, en la placa; y el alivio entre las lenguetas, que sube hasta 18.46 del canto libre. Las cotas están en la nota de abajo — **1 ud** |
| `nariz_2d` | aluminio 6082-T6, 1.5 mm | chapa | corte + **plegado**: blank **545.62 × 53.10** (el frente baja hasta el riel, ficha 6), pie de **20.5** y tres dobleces. En el pie, tres agujeros de **5.4** a 7.0 del canto libre para las tuercas CLS-M4, como el talón. En cada punta del pie, muesca de 2.65 hasta la línea de doblez a 20.06, con alivio de Ø2 a caballo de la esquina interior — **1 ud** |
| `tapa_valle_2d` | aluminio 6082-T6/T651, 3 mm (§6.4) | chapa | corte + **plegado**: blank **560.00 × 20.00**, dos pestañas de 21 mm y labio trasero de apoyo de 2.0 mm; sin taladros visibles en la banda |
| `costilla_2d`, `costilla_dorso_2d` | **aluminio, pletina de 14 mm** | **mecanizado** (§6.1) | **fresado CNC**, sin plegar, sin soldar |
| `costilla_bolsillos_2d` | la cara de FUERA del anillo | **mecanizado** (§6.1) | diez bolsillos ciegos por anillo para los tacos de la persiana, con el asiento del imán dibujado dentro; las profundidades, en §6.1 |
| `persiana_2d`, `persiana_pasante_2d`, `persiana_dorso_2d` | **aluminio 6082-T651, pletina de 12** frenteada a 9.5 | **mecanizado** (§6.3) | **fresado CNC** por las dos caras: ranuras a 4 de fondo por delante, el pasante solo donde detrás hay ventana, y los tacos por detrás — **2 uds, PAR ESPEJADO** |
| `bandeja_base_2d` | **aluminio 6082-T6, 3 mm**, anodizado negro (§6.4) | chapa (§6.2) | **láser**, con los 1118 agujeros de Ø5 cortados **salteados**; desbarbado a máquina por las dos caras, con la arista de arriba matada; **planitud ≤ 1 mm** en la chapa suelta, medida antes de anodizar; el canto de abajo, **R0.5**. Después del anodizado, la prensa: 4 FH-M4 (agujero 4.0). Los 6 M5 (Ø6) y los 12 M4 (Ø4.5) son de paso — **1 ud** |
| `marco_ventana_2d` | aluminio 6082-T651, `t_placa` = 6 mm, **láser** (§6.4) | chapa | corte + **6 cajeados** Ø8 × `prof_cajeado_riel` = 2.5 **por el lado del anillo** (bolsillos ciegos en UNA cara: dejan 3.5 mm bajo la cabeza del M4 del riel). Nota de mecanizado, no va en el DXF — ver abajo — **2 uds, PAR ESPEJADO**: mismo contorno, cajeado por caras opuestas. **Planitud ≤ 0.5 mm en 300** en el blank cortado: apoya en la cara mecanizada del anillo y doce M4 lo conforman contra ella (una pletina de 6 × 24 se aplana 0.5 con 200 N) |
| `cupon_anillo_2d` | **aluminio, pletina de 14 mm** | **mecanizado** (§6.1) | **NO ES UNA PIEZA DEL CASE**: es la SECCIÓN del perfil del anillo, y de ella sale el **cupón de 100 mm** que hay que aprobar antes de cortar los dos anillos — ver el punto de parada en §6.1 |

**Juntas de los dos labios:** suministrar y pegar **12 tacos de EPDM de
4.0 × 15**, seis en el labio del techo y seis en el del talón. No sustituirlos
por tiras continuas: el taco fija la luz y el vano entre tacos deja respirar la
rendija.

**`costilla_2d` y `costilla_dorso_2d` son CONTORNOS REALES, no desarrollos** —
al revés de como era hasta el 2026-08-27. La pieza ya no se dobla: lo que corta
la fresa es lo que sale.

**Qué trae cada hoja, exactamente** (es lo que verifica `check_dxf.py`, y la
descripción de antes estaba cambiada — decía que el rebaje iba en la hoja de la
cara):

- **`costilla_2d` — LA CARA VISTA.** Silueta exterior y ventana central, y
  **nada más**: la ventana sale de retirar `cara_anillo` = **20 mm** de la
  silueta, que es el ancho de la cara vista. **NO trae el contorno del rebaje.**
  Es la hoja del corte del blank.
- **`costilla_dorso_2d` — LA CARA INTERIOR.** Trae el contorno del rebaje del
  costado (vacío desde la rev. 28) y, desde la rev. 27, el **rebaje de chapa de 4.5 de ancho** a lo
  largo del contorno solo donde se ve techo, nariz o talón. Bajo los dos
  labios, ese contorno se funde con el bolsillo de la trasera. El bolsillo va
  en **u = 5.5..16.5**, con pared de 3 y 3.5 de rebaje vacío; su labio
  queda con 3 de hondo bajo los labios de chapa y conserva 6 en el resto.
  Trae también la planta del cajeado de brida de cada anillo —dos al fabricar
  el par—, de **28 × 15.5**, y los 14 círculos de rosca ciega. La silueta no se repite: dibujarla sería mandar
  cortar el contorno dos veces. **Las profundidades no viven en esta planta**;
  están escritas en §6.1.
- **`costilla_bolsillos_2d` — LA CARA DE FUERA (rev. 28).** Los diez bolsillos
  de los tacos de la persiana, cada uno con el círculo del asiento del imán
  dentro: ocho de Ø9, el localizador de Ø8 y la colisa de 8 × 10. En las mismas
  coordenadas que la cara; **las profundidades están en §6.1**.

**El dorso está dibujado EN LAS MISMAS COORDENADAS que la cara, no espejado.**
Léase como *la cara de atrás de la misma pieza, mirada desde el mismo lado*:
`taladros_anillo()` compara los centros del DXF contra los del modelo **sin
ninguna transformación**, así que si alguien «arregla» el fichero espejándolo,
las roscas se van al otro extremo del anillo y la puerta lo canta. Quien se
voltea es **la PIEZA en la máquina**, no el dibujo.

**`talon_2d`, `miembro_alto_2d`, `nariz_2d`, `tapa_valle_2d` y
`escuadra_enchufe_2d` SÍ son DESARROLLOS PLANOS, no contornos** — igual que las tres
del chasis: el DXF trae el recorte, y la pieza doblada mide menos. Cortar el
contorno de la pieza montada da un fichero válido e inservible.

**La escuadra del enchufe (`escuadra_enchufe_2d`, rev. 30).** Una L con un
solo doblez a 90°, de **radio interior 2 = 1 t**, en 6082-T6 de 2 mm. El
desarrollo mide **55.00 × 67.84**: 55.00 en z (la placa y las dos lenguetas) y
67.84 del canto libre del pie al canto de arriba de la placa. Cotas de montaje
(las del modelo, que `guarda_enchufe()` imprime): el pie va **plano sobre el
pie del talón**, desde 0.5 más adentro que su canto libre hasta la placa; la
placa, **a 2.0 de la cara interior nominal de la trasera** (la regla de la trasera pide tol + 0.5 = 1.70), sube 59.88 sobre la cara
de abajo del pie (de y = 1.5 a 61.38) y rebasa la ventana al menos 6 por cada
lado. Las dos lenguetas (14.00 de ancho cada una) dejan libre la pestaña del talón
con su corte en U y 0.5 de aire; entre ellas el canto de abajo de la placa sube
a 10.0, 0.5 sobre el canto de arriba de la pestaña. Cada lengueta lleva su
CLS-M4 (**Ø5.4**) a 7.0 del canto libre y a la mitad de su ancho de los dos
cantos de la lengueta (7.00 en las dos); el M4 × 10 de botón sube **desde abajo** por la base (Ø4.5) y por el
pie del talón (Ø4.5, en la misma x y z). El enchufe va **atornillado al dorso
de la placa** con dos M2.5 × 8 de cabeza alomada, desde la cara de la ventana.
Anodizado negro, **y la prensa de las CLS después del anodizado**. El M4 × 10 y
la altura del cuerpo de la CLS salen de la misma penetración que el M4 × 8 del
talón: la hoja de PEM sigue sin estar en el repo.

**LOS DOS ANILLOS SON PIEZAS ESPEJADAS, no dos iguales.** Mismo contorno y
misma ventana, pero **el rebaje, el chaflán de la ventana, las 14 roscas
ciegas y los diez bolsillos de la persiana van en la cara OPUESTA de cada
uno**: la cara vista de cada anillo mira
hacia FUERA del case, así que el dorso de uno es el lado que en el otro queda
por delante (`costillas()` en `sam17_case.scad` monta el segundo con
`mirror([0,0,1])` justo por esto). Cortar los dos con las operaciones del mismo
lado da un case con un anillo del revés: el rebaje del segundo abriría hacia
fuera y sus bolsillos de la persiana quedarían por dentro. **Un anillo derecho y uno
izquierdo.**

**EL MARCO DE LA VENTANA (`marco_ventana_2d`) SUSTITUYE A PLACAS, CLIPS Y
ESCUADRAS desde el 2026-08-29 por la noche.** Es la pletina de 6 con el
contorno de la ventana del anillo, corrida por los siete tramos: sobre las
tres filas es exactamente la placa de anclaje de la mañana (canto a la
silueta, cajeado por riel, dos roscas por riel), y en el frente, el suelo,
la meseta y la trasera fue el tope del acrílico que daban los clips y la
escuadra, hasta la rev. 28. Blank **300.11 × 251.88**. **Se cortan DOS con el mismo DXF y son
un PAR ESPEJADO**: el cajeado Ø8 × 2.5 va en la cara OPUESTA en el de un
costado y en el del otro, porque cada cajeado tiene que mirar al anillo de
SU lado. Los seis cajeados van centrados en los seis pasos M4 de riel
(cuatro 3U, dos 1U) por la cara que mira al anillo — ahí aloja la cabeza
del tornillo del riel; sin ellos la cabeza no tiene dónde meterse y el marco
no cierra contra el anillo. **El DXF NO lleva el cajeado**: un DXF 2D no sabe
decir profundidad, el mismo caso que el rebaje de `costilla_dorso_2d` y el
cajeado KONDOR (§4). Trae **19 taladros**: los doce pasos M4 al anillo (diez
en las tres filas y dos en la pata del suelo, a 60 de cada extremo de la pata:
el trabajo que hacían los de los clips), los seis pasos M4 de riel y la rosca
M3 de la pestaña de la banda del valle a
**diámetro de broca** (pasante en la propia pletina). Y una **muesca** en la
esquina trasera-alta, abierta al canto exterior, de 16.5 de honda: ahí apoya
en la cara del anillo la brida del miembro alto, y el marco se aparta.

**Su canto exterior no va a la silueta en todos los tramos.** En las tres
filas sí: es el borde de aluminio de la fila. Bajo las chapas empotradas se
retira **2.65**, porque la cara de la chapa queda 1 por dentro del contorno.
En el **suelo** se retira **1.65**: los pies apoyan a ras y no entran en el
rebaje. En la trasera se retira **17.00**, medio milímetro después de la pared
del bolsillo. El canto interior conserva 26 de fondo salvo en la pata
trasera, donde `marco_fondo_trasera` vale **30**. Así queda una pata de
**13 × 6**, que con 200 N trabaja a 114 MPa, por debajo de 130: con la
persiana quitada, la mano llega al marco. (El techo de flecha de 2 mm era el
del acrílico, que se salía del rebaje con 3, y se fue con él.) `taladros_marco_ventana()` relee el contorno del
fichero.

**LA BRIDA DEL TECHO VA EMPOTRADA.** Cada brida mide **27 × 14.5** y lleva
sus esquinas a **R2**. Asienta entera en un cajeado de **28 × 15.5**, con
esquinas interiores **R1.5** para la fresa de Ø3. El cajeado se hace en la
cara interior del anillo, a **3 mm de profundidad**. Esa profundidad deja
**11 mm de pletina** bajo los dos M4 ciegos: la brida queda más lejos del
barrido de la tapa y la rosca conserva cuerpo. La muesca del marco sobre la
brida se mantiene. La trasera no lleva muesca ni taladro.

**LO QUE ENTRA EN LOS REBAJES MIDE 545.62 ENTRE PAREDES.** Sale de la luz
546.62 menos 0.5 por cada canto. En nariz y talón, el pie no entra: vuelve al
ancho de apoyo mediante una muesca de 2.65 en cada punta. No recortar el pie a
todo el ancho del blank, porque entonces dejaría de apoyar entre los anillos.

**EL TALÓN (`talon_2d`) ES LA NARIZ EN ESPEJO**: labio vertical de 13,
chaflán a 45° sobre P6 y pie de **22.5** sobre la base. Blank
**545.62 × 42.23**. En cada punta del pie se corta una **muesca de 2.65** desde
el canto libre hasta la línea de doblez pie-chaflán. Esa línea está a
**22.06** del canto libre (`largo − BD45/2`), no en el largo nominal del pie.
La esquina interior lleva un **alivio de Ø2 a caballo de la línea**: sin él,
el pliegue arrancaría la muesca. Conserva los tres M4 del pie y las ocho
ventanas de pestaña del DXF. Los dos dobleces van hacia dentro. Sin bridas ni
rosca en el anillo.

**LA NARIZ (`nariz_2d`) LLEVA TRES DOBLECES, y ninguno es a 90°.** Blank
**545.62 × 53.10** (era 50.20 hasta la rev. 28: el frente baja hasta pisar la
cara del riel, ficha 6), con pie de **20.5**. El pie crece para que los dos pies no
difieran más de 2: se mantienen como una familia. En cada punta se corta una
**muesca de 2.65** desde el canto libre hasta la primera línea de doblez, a
**20.06** (`largo − BD45/2`). Lleva un **alivio de Ø2 a caballo de la esquina
interior**. Después siguen los dos dobleces restantes del perfil vigente. Los
tres van hacia dentro; el pie queda sobre la base.

**Corrección del 2026-08-30.** La boca del avellanado M4 del talón es un cuerpo
fijo detrás de la cara interior del acrílico y necesita 1.70 de aire. Con la
trasera 1 mm más adentro y el pie en 21.5 quedaban 1.77: verde por 0.07 no es
margen. El pie en 22.5 recupera 2.77. La nariz lo sigue a 20.5 porque los dos
pies no pueden diferir más de 2. Va bajo la base y no se ve.

**`miembro_alto_2d` ES EL TECHO MACIZO.** Hay una sola geometría operativa en
esta revisión: blank **593.02 × 78.85**, meseta de 50 **sin ranuras**, retorno
de **9** a 45° en el pico (era 4 hasta la rev. 28: baja hasta pisar la cara
del riel y cierra la rendija, ficha 6), chaflán de 6 y labio de **20**. Las dos bridas de
27 × 14.5 se doblan de las puntas del labio y llevan las esquinas a **R2** para
entrar enteras en los cajeados R1.5 del anillo. Sin fila de M3 y sin canal: la
trasera no se atornilla al techo.

**LOS RADIOS DEL CONTORNO SIGUEN LA CHAPA.** Donde el anillo bordea una chapa
empotrada, el radio es **5.5**: `radio_chapa` 4.5 más el rehundido de 1. Así el
reborde sigue concéntrico al arco del pliegue. Donde nariz o talón salen del
rebaje hacia el pie, vuelve a **4.5**: el reborde termina y el pie sigue a ras
sobre la base. Las tres esquinas con chaflán conservan el chaflán de 6.

(Las notas sobre los DXF de placa y su fix round — el cajeado dibujado en
vez del paso M4 — quedan en el historial: la pieza es hoy el marco de la
ventana, con las mismas dos mitades por agujero de riel, el paso M4 en el
DXF y el cajeado como nota.)

Las tres del chasis llevan su propio plano de plegado
([`renders/chasis-plano-plegado.png`](renders/chasis-plano-plegado.png)),
porque un DXF de corte no dice de dónde doblar. Los cinco desarrollos de
aluminio (miembro alto, talón, nariz, tapa del valle, escuadra del enchufe) no tienen plano de
plegado dedicado — `renders/plano_chasis.py` cubre solo el acero — y siguen
sin necesitarlo si el taller ya trabaja de los mismos DXF que el chasis. Los
que no son a 90° (la nariz, el retorno de la meseta) llevan sus líneas escritas
arriba.

**La tapa del valle** era acrílico de 5 mm hasta el 2026-08-25 y es la
superficie horizontal entre las dos filas de módulos. Cambió a aluminio de
3 mm porque en PMMA fluía a 90 N y era la pieza más floja del case. Desde la
Tanda B ya **no trabaja como viga entre las pestañas**: el canto trasero se
prolonga 2.0 mm sobre la cara del primer Z-Rail KONDOR y transmite ahí la
carga de mano. Entre ambos se monta una tira anti-ruido adhesiva de
**0.20 mm nominal, comprimida a 0.10 mm**; se compra en rollo y no tiene DXF.
Con 200 N sobre una banda conservadora de 50 mm, `guarda_valle()` verifica
flecha y tensión por debajo de sus techos.

Desde el 2026-08-27 **tampoco es plana**: lleva una pestaña de 21 mm doblada a
90° en cada punta. **Desde el 2026-08-28 esa pestaña ya NO se atornilla al
anillo**: se rosca pasante en el MARCO DE LA VENTANA (6 mm de pletina, ruling
R3; hasta el 29-08 por la noche, en la placa del valle), porque su rosca
caería a 13.7 mm del plano del valle y la franja del anillo solo admite
hasta 10.25 antes de salir por la pared del rebaje. Sigue atando la banda a
los dos marcos y convirtiéndola en diafragma a media altura — el ancla
cambió de pieza, no la función.

**Ninguna pieza de aluminio o de acero lleva nada de §3**: ni recocido, ni
diamantado, ni el chaflán de 0.5. Esas tres cosas son del PMMA. Canto
desbarbado y basta, y **todo el aluminio que se ve, anodizado en negro**
(§6.4): el anillo, la persiana, las tres chapas empotradas, la tapa del valle
(ficha 14 del acta del 09-10), el marco de la ventana, que se ve entre las
varillas, y la **tira negra del valle** (ficha 6, 10-10): chapa de aluminio de
1 mm, lisa, cortada a las cotas que imprime `guarda_tira_valle()`, sin
taladros ni plegados.

### 6.1 Taller de mecanizado: el anillo

**Taller nuevo desde el 2026-08-28.** Hasta esa fecha la costilla era chapa
de aluminio plegada y entraba en el pliego de chapa; el render de esa pieza
se leía «como un sándwich de aluminio envolviendo el acrílico» y Samuel lo
rechazó. El anillo que la sustituye no se pliega ni se suelda: es una pletina
maciza, vaciada por el centro con fresadora CNC.

- **Material y blank.** Pletina de aluminio de **14 mm** de espesor
  (`t_anillo`). Blank aproximado **340 × 270 mm** (spec de diseño §9; el
  contorno real mide 319.8 × 256.2 mm, `costilla_2d`, con margen de sujeción
  y desbaste).
- **SON DOS PIEZAS ESPEJADAS, uno derecho y uno izquierdo.** Mismo contorno y
  misma ventana; los **rebajes, los cajeados, el chaflán de la ventana, las
  14 roscas ciegas y los diez bolsillos de la persiana van en la cara OPUESTA
  de cada anillo**, porque la cara vista de cada uno mira hacia FUERA del case.
  Mecanizar los dos por el mismo lado da un anillo del revés, con el rebaje
  abriendo hacia fuera y los bolsillos de la persiana por dentro. En el modelo esto es el `mirror([0,0,1])` de `costillas()`.
- **Contorno + ventana.** Corte de la silueta exterior y de la ventana
  central — láser o agua y luego fresa, o todo fresa: lo decide el taller,
  siempre que el acabado final sea el fresado de §6.1.
- **Rebaje**, por detrás de la cara vista: **6 mm** de ancho en el plano
  (`rebaje_anillo`) × **11 mm** de profundidad (`t_anillo − rehundido_acrilico`,
  14 − 3). **Desde la rev. 28 queda VACÍO**: ahí asentaba la mejilla de
  acrílico, y la persiana lo tapa. Se mantiene porque sus cotas son las del
  bolsillo de la trasera y quitarlo no compra nada (papel de la persiana,
  §7.2). Junta polvo: con la persiana fuera, se aspira.
- **Diez bolsillos por anillo en la cara de FUERA** (rev. 28), los de los
  tacos de la persiana, según `costilla_bolsillos_2d`: **3.8 mm de hondo**
  (0.3 de aire bajo el taco de 3.5) y, en el fondo, el **asiento del imán de
  Ø6.1 × 3.1** — **Ø6.1 × 1.1** en los dos del tramo de atrás, que tienen
  detrás el bolsillo de la trasera. Ocho de **Ø9**, con holgura, retienen;
  dos localizan: el delantero del suelo a **Ø8 H7** y el trasero del suelo en
  **colisa de 8 H7 × 10** a lo largo de x. Quedan 3.0 de pared al rebaje
  (`guarda_tacos_persiana()`), y cada bolsillo libra las roscas M4 del dorso y
  los M5 de la base (`anillo_tiene_bolsillos()`). El reparto deja el tramo
  más largo sin taco en 112 mm, y el papel pide 100 o menos para que la banda
  quede apretada: con diez tacos no se llega (HUECO en el budget; once lo bajan
  a 92, y eso lo decide Samuel).
- **Los dos localizadores ajustan DESPUÉS de anodizar.** El anodizado crece
  hacia fuera en las dos piezas, el bolsillo y el taco (del orden de un tercio a
  la mitad de su espesor, ESTIMADO), y con AA15–AA20 eso se come el juego de un
  H7/g6 (5 a 29 µm). El taller mecaniza contando con esa crece, o enmascara los
  dos localizadores y sus bolsillos; que lo diga en el presupuesto (RFQ §D).
- **Rebaje de chapa**, en la cara interior y solo a lo largo del contorno que
  queda cubierto por techo, nariz o talón: **4.5 mm de ancho × 3 mm de
  profundidad**, desde z = 11 hasta z = 14 contando desde la cara vista. Deja
  un **reborde de 1 × 3**. La chapa queda 1 por dentro del contorno, con 0.5
  de holgura al canto y 2.5 agarrados en z. El reborde tapa el canto; por eso
  no se extiende bajo los pies.
- **Un cajeado de brida por anillo, dos en total**, de **28 × 15.5 × 3 mm**,
  en la cara interior. Esquinas interiores R1.5 para la fresa Ø3. Las bridas
  van a R2. Quedan 11 mm de pletina bajo sus dos M4 ciegos.
- **Tramo trasero de 23 mm de franja.** El bolsillo de la trasera ocupa
  u = 5.5..16.5; después quedan la pared de 3 y 3.5 de rebaje vacío.
  Bajo los labios del techo y del talón, el labio del bolsillo tiene 3 de
  hondo porque el rebaje de chapa ocupa los otros 3. En el resto conserva 6.
- **Radios de contorno:** 5.5 donde se ve chapa empotrada; 4.5 donde la chapa
  abandona el rebaje para formar el pie. Así el marco sigue el pliegue sin
  levantar el apoyo de la base.

**PROFUNDIDADES QUE NO ESTÁN EN EL DXF:** el rebaje de chapa tiene **3 mm** y
cada cajeado de brida tiene **3 mm**. `costilla_dorso_2d` es una planta: marca
la huella, no el eje Z. No deducir la profundidad del ancho dibujado.
- **Chaflán 1.5 × 45°** (`chaflan_anillo`) en las DOS aristas de la cara
  vista: la exterior (silueta) y la de la ventana. Es lo que lee como
  «perfil» en vez de «banda plana» — la razón entera del cambio de diseño.
- **Radio ≥ 3 mm** en la esquina interior de P3, el único vértice cóncavo
  del contorno — pide una fresa de **⌀6 mm** para ESA esquina puntual, más
  gruesa que la de contorno general (`fresa_d` = ⌀3 mm, §8): dos útiles
  distintos para dos operaciones distintas, no una contradicción. Es
  esquina fresada, no esquina de plegado: no lleva alivio en V ni cierre
  soldado — esas dos cosas mueren con la chapa plegada.
- **Roscas ciegas M4 en la cara interior (el dorso); las M5 NO van ahí, van
  en el CANTO INFERIOR** — a diámetro de broca, las del dorso según
  `costilla_dorso_2d.dxf`: broca **3.3 mm para M4**, broca
  **4.2 mm para M5**, **10 mm de profundidad útil** (14 mm de pletina menos
  el margen que deja la puerta de anclajes). Son **14 roscas M4 por anillo**
  — la cuenta que imprime `taladros_anillo()` sobre este mismo DXF: dos por
  riel 3U, dos sobre el primer riel 1U y dos en la pata del suelo (las doce
  del marco de la ventana; las del suelo caen en x = 67.6 y 242.8, lejos de
  los tres M5 de la base que entran por el canto en 53.3, 159.9 y 266.5 —
  `guarda_marco_ventana()` lo mide) y dos de la brida del miembro alto; eran
  16 con los clips y la brida del
  miembro bajo, muertos el 29-08 por la noche — más **3 roscas M5 por anillo (6 en total, 2
  filas de 3) en el CANTO INFERIOR** para la base: esas NO salen en el DXF
  del dorso porque entran por el canto, no por la cara, así que van descritas
  aquí y no en el plano: al medio de los 14 mm de espesor, broca 4.2.
- **Acabado: anodizado negro** (§6.4), después de mecanizar. El punto de bonding
  de PE va **enmascarado antes de anodizar**, en la cara interior, uno por
  anillo — el anodizado es aislante y ese punto tiene que quedar metal
  desnudo. **Y desde la rev. 29 un segundo punto**: un círculo de **Ø12** en el
  canto inferior, alrededor de uno de los tres M5, para la masa de la base
  (arandela dentada bajo la cabeza del M5).
- **PUNTO DE PARADA: el cupón, antes de cortar los dos anillos.** Las cotas
  de la cara vista (chaflán, rebaje, rehundido) salieron de escalar una foto
  de referencia y están marcadas ESTIMADO en la spec de diseño. **No se corta
  el material de los dos anillos hasta que este cupón esté aprobado.** Es la
  misma lógica que el cupón de kerf del acrílico (§ «Procedimiento del cupón»
  en el README): medir sobre la pieza real, no sobre el render.

  **Qué se pide:** `plans/cupon_anillo_2d.dxf` es la **sección** — el único
  plano del anillo que lleva las profundidades, porque los otros dos son
  vistas de planta y ninguna sabe decir «14 de pletina» ni «1.5 × 45». Del
  perfil de esa sección, **100 mm de largo**, con **una rosca ciega M4 (broca
  3.3, 10 mm útiles) a media altura de la franja, a media longitud**, y
  **anodizado negro (§6.4) con un punto de bonding enmascarado** en la cara
  interior. Mismo material, mismo mecanizado y mismo anodizador que van a
  hacer los anillos: un cupón hecho de otra forma no mide nada.

  Desde la rev. 27, el cupón reproduce la **sección completa del anillo con
  doce vértices**: los ocho anteriores más los cuatro de la muesca del
  **rebaje de chapa de 4.5 × 3**. La muesca deja el **reborde de 1 × 3** entre
  ella y el canto. Así el cupón permite medir el reborde sobre metal. Ese
  reborde es la pared más delicada
  del anillo; probarlo en el cupón evita descubrir su límite después de vaciar
  las dos piezas completas. Si el taller no acepta el reborde de 1 con **+0.3 / −0** (asimétrica a
  propósito: 0.9 es rojo para `guarda_rebaje_chapa`, y pedir ±0.1 sería
  aceptar por contrato una pieza que rechazamos por diseño), se
  detiene el cupón y el diseño se regenera a 1.5 antes de cortar.

  **Qué se mira cuando vuelve, y qué pasa si falla:**

  | # | Qué se comprueba | Criterio | Si falla |
  |---|---|---|---|
  | 1 | El chaflán se lee como en la foto de referencia | 1.5 ± 0.2 a 45°, continuo y sin escalones de faceta, mirado con la misma luz y al lado de la referencia impresa | Se cambia `chaflan_anillo` (rango ESTIMADO 1–3), se reexporta la sección y se pide otro cupón |
  | 2 | La persiana asienta plana en la cara del anillo y sus tacos entran en sus bolsillos | Con la **tira de muestra** de la persiana (§6.3) sobre su placa de 14 con dos bolsillos: apoya sin balanceo en toda la banda, el localizador entra a mano y el imán la sostiene sola | Se corrige la cota que falle (`d_bolsillo_taco`, `hondo_bolsillo_taco`, `d_taco`), se regeneran `costilla_bolsillos_2d` y `persiana_dorso_2d` y se pide otra placa antes de cortar los anillos. (Hasta la rev. 28 este criterio era «el rebaje asienta el PMMA del lote»: el rebaje ya no recibe nada) |
  | 3 | El anodizado no interrumpe el PE | **≤ 0.1 Ω** medido a cuatro hilos entre cada punto enmascarado (el de la cara interior y el círculo del canto) y un tornillo apretado en la rosca ciega (spec 2026-08-27 §3.4; rev. 29) | El enmascarado no valió: se rehace el punto y se vuelve a medir antes de anodizar los anillos |
  | 4 | El rebaje de chapa deja un marco continuo | Rebaje de 4.5 × 3 y reborde de 1 × 3, sin mordidas ni pared abierta | No se cortan los anillos; se aplica la respuesta acordada en el RFQ y se pide otro cupón |

  Las cotas **en el plano** (cara vista y ancho del rebaje) no hacen falta
  medirlas aquí: las cruzan `anillo_tiene_ventana()` y `anillo_tiene_rebaje()`
  contra los ficheros que se cortan, en cada corrida. Lo que el cupón cierra
  son las **profundidades del perfil** y el **acabado**, que ningún DXF de planta
  puede decir y ningún render puede decidir.
- **Aleación: 6082-T6/T651, obligatoria desde la rev. 28.** No por cálculo:
  la puerta (`guarda_anillo()`) calcula con **Rp0.2 = 130 MPa** y con la
  sección de este anillo (I = 3714 mm⁴, 214 mm², contra 1673 mm⁴ de la vieja
  L plegada) el 5754 H22 pasaba con margen de sobra. Es por color: el anillo
  va canto con canto con la persiana, y dos aleaciones anodizan con distinto
  tono y se distinguen en la junta (§6.4). La planitud tras el vaciado sigue
  siendo el riesgo técnico real de esta pieza.

**Pregunta eliminatoria para este taller** (va también al RFQ, §D):
**planitud garantizada después de vaciar el centro de una pletina de 14 mm.**
Vaciar el centro de una placa gruesa libera tensión interna del material y
puede alabearla; si el taller no puede darla plana, no es el taller.

**Muere de este taller** lo que era del pliego de chapa: los seis alivios
convexos de 4.5 mm, el rip bisector de P3 y su soldadura lineal de 14.5 mm
por costilla — el anillo es una pieza, no siete tramos cerrados a soldadura.

### 6.2 La base — al taller de chapa (rev. 29)

La base es la pieza de abajo del case: chapa de **6082-T6 de 3 mm**, anodizada en
negro, a ras de la huella del cuerpo (`bandeja_base_2d`, 307.76 × 568.62). Amarra
los dos anillos con seis M5 × 12 de botón desde abajo, recibe la nariz, el talón
y las patas, y es la entrada de aire por su campo de 1118 agujeros de Ø5 (papel
del suelo, sec.3 y 5).

- **Láser**, con los agujeros cortados **salteados** para repartir el calor.
- **Planitud ≤ 1 mm** en la chapa suelta, **medida antes de anodizar**. Si hay
  que nivelar, se nivela antes, nunca después.
- **Desbarbado a máquina por las dos caras**, con la arista de arriba matada:
  por los agujeros del campo pasan las bridas de los cables.
- **El canto de abajo, R0.5**: el aparato se levanta con los dedos bajo él.
- **El orden**: láser, desbarbado, anodizado (§6.4) y **después la prensa** de
  los insertos (4 FH-M4 en la base; las 8 CLS-M4 de los pies de nariz y talón y
  de las dos lenguetas de la escuadra del enchufe van en esas piezas). Los insertos, de **acero o inoxidable** (CLS/FH o
  CLSS/FHS), **nunca de la serie de aluminio**: pide chapa de dureza ≤ HB 89 y
  el 6082-T6 ronda 95. Sus agujeros se cortan a la cota del catálogo sobre la
  pieza **anodizada** (el anodizado los cierra unos 0.02). La hoja de PEM no
  está en el repo: las cotas de insertos son de memoria hasta tenerla.
- **La masa**: un círculo de Ø12 sin anodizar en la cara de arriba, alrededor
  de un M5 por anillo, que casa con el del canto del anillo (§6.1).

### 6.3 Taller de mecanizado: la persiana

**Pieza nueva desde la rev. 28.** Sustituye a las dos mejillas de acrílico:
una placa por costado, por fuera del anillo y tapándolo entero, con 44 varillas
verticales de 2 mm. Es por donde respira el instrumento y lo que se ve de él de
lado. Papel: `docs/superpowers/specs/2026-10-11-case-persiana-design.md`.

- **Material y blank.** Aluminio **6082-T651 laminado y estirado** — no placa
  colada: se anodiza manchada —, en **pletina de 12** frenteada a **9.5**: 6
  de placa y los diez tacos de 3.5 del dorso, del mismo bloque. Ninguna pieza
  suelta.
- **SON DOS PIEZAS ESPEJADAS: dos programas.** Mismo contorno; las ranuras
  ciegas, los atados y los tacos van por la cara opuesta en cada una, porque
  los tacos miran a SU anillo (`persianas()` monta la segunda con
  `mirror([0,0,1])`, como `costillas()`).
- **Qué trae cada hoja.** Las tres van en las mismas coordenadas que el anillo
  y **no se espejan**: quien se voltea es la pieza en la máquina.
  - **`persiana_2d` — LA CARA.** El contorno y las 45 ranuras, con sus puntas a
    radio 1.5. Todo lo que dibuja se fresa **a 4 mm de fondo por delante**.
  - **`persiana_pasante_2d` — LO QUE ATRAVIESA.** Las ranuras donde detrás hay
    ventana, menos los dos atados: ahí se quitan **los 2 mm que quedan**. Donde
    no sale (la banda que cae sobre la cara del anillo, 20 mm y 23 en el tramo
    de atrás, y los dos atados de 4), la ranura se queda a 4 y deja un alma de
    2 por detrás.
  - **`persiana_dorso_2d` — EL DORSO.** Los diez tacos de **Ø8 × 3.5**, cada uno
    con el asiento del imán: **Ø6.1 × 2.1** en ocho y **Ø6.1 × 1.1** en los
    dos del tramo de atrás. Los dos localizadores ajustan después de anodizar
    (§6.1).
- **Orden de operaciones.** Es lo que hace la pieza posible: sin los atados y
  sin el alma, la varilla de 248 cede más de 1 mm mientras se corta (papel,
  §3.3).
  1. frentear las dos caras, dejando los tacos;
  2. todas las ranuras **a 4 de fondo por delante, con las paredes
     acabadas**, mientras el alma de 2 las sostiene;
  3. el pasante de los últimos 2 mm, **solo en `persiana_pasante_2d`**, por
     tramos entre atados y **sobre placa de sacrificio**. La placa lleva un
     **alojamiento para cada uno de los diez tacos del dorso** (Ø8 × 3.5, en
     `persiana_dorso_2d`): la persiana apoya plana por su dorso, no sobre los
     tacos. Las dos persianas son espejadas, y sus tacos no caen en el mismo
     sitio de la placa;
  4. el contorno, al final.
- **Fresa Ø3 de 3 filos.**
- **Chaflán 0.2 × 45°** en las aristas de delante, y **0.3 × 45° en la arista
  de atrás del contorno**, la que asienta en el anillo: con la junta de sombra
  esconde el escalón de hasta 0.2 entre los dos cantos (papel, §4). En la
  salida de las ranuras por detrás, repaso de rebaba (§6.4: arista rota en todo
  canto visto).
- **Planitud ≤ 0.2 en 320**, medida después de ranurar **y** de anodizar.
  **Pregunta eliminatoria**, como la del anillo: la persiana apoya en la cara
  del anillo por toda su banda, y esa sujeción decide cómo suena (el primer
  modo de frente va de 350 a 920 Hz según cuánto apoye; papel, §3.3).

**La muestra, antes que las dos persianas (#398).** Una **tira de altura
completa**, 60 × 256 mm, cortada de la propia persiana donde están las
varillas de 248 (x ≈ 270–330): 9 o 10 varillas, los dos atados, la banda
ciega, el borde de 4 por los cuatro lados y **dos tacos con sus imanes sobre
una placa de 14 con dos bolsillos**. Mismo material, mismo taller, mismo
anodizador. Una muestra de 100 × 100 no sirve: ningún vano pasaría de 45 mm,
sería seis veces más rígida y daría verde sin merecerlo. Lo que se mide:

- el corte pasante en el vano de 83, sin vibración y con 0.05 mm o menos de
  ondulación de pared (ESTIMADO);
- el anodizado en cantos de 2 y en el fondo de las ranuras ciegas;
- **el golpe de uña**: el tono más bajo de frente y cuánto dura. Criterio:
  **que se apague en medio segundo o menos**. Si dura más, una lámina de
  aluminio con adhesivo viscoelástico (tipo 3M 434/435; la hoja hay que
  traerla) pegada detrás de los dos atados, que no se ve y no quita aire;
- el tirón de los imanes, con dinamómetro (el papel lo estima en 50–70 N por
  persiana entera, contra los 3.6 N de su peso);
- el escalón entre el canto de la persiana y el del anillo, contra el cupón
  del anillo (§6.1, criterio 2).

### 6.4 El anodizado — todo el aluminio que se ve

**Desde la rev. 28, todo el aluminio que se ve va anodizado en negro**: los dos
anillos, las dos persianas, el techo, la nariz, el talón, la tapa del valle, la
tira negra del valle y el marco de la ventana, que se ve entre las varillas. Y
desde la rev. 29, la base.
Los Z-Rails no: son comprados y van en plata.

- **Una sola aleación: 6082-T6/T651**, la de las chapas. La persiana va canto
  con canto con el anillo, y dos aleaciones anodizan con distinto tono y se
  distinguen en la junta.
- **Un anodizador y un lote** para todo.
- **Negro, ISO 7599 clase AA15–AA20, sellado.** Citado de memoria: la norma no
  está en el repo, y hay que confirmarla con el anodizador.
- **Arista rota de 0.2 mm o más** (C0.2 o R0.2) **en todo canto visto**. En
  canto vivo el anodizado no cierra la arista: sale más claro y se pela al
  limpiar, y en la persiana serían 94 rayas grises a lo largo de las varillas.
- **Los contactos del bastidor, en caras tapadas**: en la persiana, el dorso de
  la banda, que tapa el anillo; en el anillo, la cara interior.
- **Enmascarado**: el punto de bonding de PE de cada anillo y el círculo de
  Ø12 de su canto inferior (§6.1), el círculo de la base que casa con él
  (§6.2), y los
  dos localizadores de cada persiana con sus bolsillos si el taller prefiere
  eso a compensar la crece (§6.1).
- **La tapa del valle se dobla a R3 en 3 mm (1 t)**, `radio_doblez_valle`. En
  6082-T6 ese radio puede fisurar (ESTIMADO: la tabla de radios mínimos no está
  en el repo). Se pregunta al taller (RFQ §B) y queda como HUECO: el radio no lo
  cambia el taller por su cuenta, porque de él cuelga el desarrollo.

### 6.5 Los imanes — se compran

**20 pares de neodimio N42 de Ø6** entre los dos costados (BOM de
`sam17_case.scad`, contados contra `tacos_persiana`):

- **16 pares** de un **Ø6 × 3** en el anillo con un **Ø6 × 2** en el taco;
- **4 pares de finos, Ø6 × 1 + Ø6 × 1**, en los dos tacos del tramo de atrás
  de cada costado, que tienen detrás el bolsillo de la trasera.

Cuarenta piezas, **con la polaridad fija y marcada**.

## 7. Manipulación y limpieza — para nosotros, no para el taller

Esta sección no es del pedido: es de lo que pasa **después**, y es donde se
estropea un acabado que llegó bien.

- **Prohibido alcohol y limpiacristales con amoníaco**: craquelan el PMMA.
  Agua tibia con jabón neutro y paño de microfibra.
- **El film protector se quita al FINAL del montaje**, no al recibir. El
  acrílico llega perfecto y se raya durante el ensamblaje: al deslizarlo por
  la mesa, al apoyar una herramienta, al girar una pieza sobre otra.
- **Ningún tornillo toca acrílico** desde el 29-08 (más noche): la trasera va
  capturada (y desde el 2026-10-11 los costados son la persiana, de aluminio,
  sujeta con imanes). Los paneles y sus seis Z-Rails quedan fijos;
  no existen ejes de giro, cierres manuales ni tornillos de fricción.
- **La persiana se quita tirando derecho**, con dos ganchos de alambre de 2 mm
  metidos en dos ranuras junto a un atado (papel de la persiana, §4). Sin ella,
  la ventana del anillo deja aspirar el interior sin quitar paneles; el rebaje
  vacío del anillo junta polvo.
- **Los dos costados, libres.** Por la persiana respira el instrumento: con un
  costado contra una pared sube 21.4 K sobre la sala en el pesimista, contra un
  techo de 20 (D-S11, rev. 29: 26 K antes de la base). Cuánta holgura hace falta
  se mide en el arranque.
- **Sobre una mesa dura**, con los 10 mm de pata libres debajo: por la base
  entra el aire (rev. 29). Sobre un paño o una alfombrilla la base no respira y
  el pesimista sube a 18.9 K.
- **El ensayo de derrame (D-S10)** gana un criterio: el agua que entra sale por
  la base y no se encharca en ella.
- **Paticas**: goma **firme** (Shore 60–70 A, ≤ 0.3 mm con 50 N, alto 10 ± 0.2)
  con casquillo roscado, **roscadas a una FH-M4 de la base, nunca pegadas**.
  El case no lleva ninguna junta irreversible desde el 2026-08-21.

## 8. De dónde salen estos números

Todo lo cotado aquí vive en [`cad/params.scad`](cad/params.scad) con su
puerta en [`clearance_budget.py`](clearance_budget.py) o
[`check_dxf.py`](check_dxf.py). **Si este documento y el modelo se
contradicen, el equivocado es este documento.**

| aquí | parámetro | puerta |
|---|---|---|
| chaflán 0.5 × 45° (PMMA) | `chaflan` | `guarda_chaflan()` |
| cajeado 4.0 mm | `kondor_prof` | `guarda_kondor()` |
| apriete 1.0 N·m / d16 | `par_m3`, `d_arandela` | `guarda_apriete()` |
| patica firme: ≤ 0.3 mm con 50 N (de compra; HUECO hasta la hoja) | `flecha_pie`, `alto_pie` | `guarda_paticas()` |
| base: chapa 3, campo Ø5 cada 8 en L, puente 3 ≥ t, 7.0 de un inserto | `t_base`, `base_agujero`, `base_paso`, `base_orilla`, `pem_borde` | `guarda_campo_base()`, `guarda_bandeja_base()` |
| base: mano de 200 N en el campo, ≤ 9 mm de flecha y ≤ 160 MPa en el puente | `t_base`, `carga_mano` | `guarda_piso()` |
| tuercas CLS-M4 en los pies, a 7.0 del canto libre (Ø5.4, cuerpo 7.9) | `pem_cls_m4`, `pem_cls_m4_cuerpo`, `pem_borde` | `guarda_talon()`, `taladros_nariz()`, `taladros_talon()` |
| escuadra del enchufe: 6082-T6 de 2, radio 2, placa de solape 6 sobre la ventana, aire de 0.5 a la pestaña del talón, blank 55.00 × 67.84; Kycon KPJX-PM-4S (brida 25.2 × 14.2, fondo 9.9, patillas 4.1) y clavija KPPX-4P (cuerpo 13.0, nariz Ø9.6 × 6.5) | `t_escuadra`, `radio_doblez_escuadra`, `escuadra_solape`, `escuadra_aire_talon`, `escuadra_pie_dentro`, `kycon_*`, `kppx_*`, `m25_largo` | `guarda_enchufe()`, `canario_enchufe()`, `taladros_escuadra()`, `taladros_talon()`, `guarda_bandeja_base()` |
| fresa ⌀3 mm | `fresa_d` | `guarda_fresado()` |
| tapa del valle, aluminio 3 mm; apoyo 2.0; tira 0.20 comprimida a 0.10 | `t_valle`, `apoyo_valle`, `tira_valle_nominal`, `compresion_tira_valle` | `guarda_valle()` |
| fila auxiliar KONDOR 55 mm / centros 49 mm; paneles y rieles rehundidos 1.50 | `alto_panel_1u`, `inset_er`, `rehundido_panel` | `guarda_fila_1u()`, `guarda_rehundido_panel()` |
| anillo: espesor 14, cara 20, rebaje 6, rehundido 3, chaflán 1.5 × 45° | `t_anillo`, `cara_anillo`, `rebaje_anillo`, `rehundido_acrilico`, `chaflan_anillo` | `guarda_anillo()`, `guarda_rebaje()` |
| roscas ciegas del anillo, broca M4 3.3 / M5 4.2 | `d_M4_rosca`, `d_M5_rosca` | `guarda_anclajes()`, `taladros_anillo()` |
| junta de asiento EPDM 1 mm (la trasera; la del costado murió en la rev. 28) | `t_junta_asiento` | `guarda_trasera_capturada()` |
| rebaje de chapa 4.5 × 3, rehundido 1, holgura 0.5, reborde 1 × 3 | `rebaje_chapa`, `rehundido_chapa`, `hol_chapa` | `guarda_rebaje_chapa()`, `anillo_dorso_tiene_rebaje()` |
| tramo trasero 23; bolsillo u = 5.5..16.5; pared 3; rebaje vacío 3.5; labio 3 bajo las chapas y 6 en el resto | `cara_anillo_trasera`, `rehundido_trasera`, `pared_rebaje_trasera`, `entrada_costado_trasero` | `guarda_tramo_trasero()`, `anillo_tiene_bolsillo_trasero()` |
| cajeado de brida 28 × 15.5 × 3, R1.5; brida R2; pletina restante 11 | `rebaje_chapa`, `brida_*` | `guarda_miembro_alto()`, `bridas_techo()` |
| marco retirado 2.65 bajo chapa, 1.65 en el suelo y 17.00 atrás; fondo trasero 30 | `rehundido_chapa`, `marco_fondo_trasera` | `guarda_marco_ventana()`, `taladros_marco_ventana()` |
| talón: pie 22.5, blank 545.62 × 42.23, muesca 2.65 hasta 22.06, alivio Ø2 | `talon_pie`, `muesca_pie` | `guarda_talon()`, `pestanas_talon()` |
| nariz: pie 20.5, blank 545.62 × 53.10, muesca 2.65 hasta 20.06, alivio Ø2 | `nariz_pie`, `muesca_pie` | `guarda_talon()`, `check_dxf` |
| techo macizo: labio 20, retorno 9, blank 593.02 × 78.85 | `techo_labio` | `guarda_miembro_alto()`, `techo_macizo()` |
| doce tacos EPDM 4.0 × 15; rendija nominal 4.0, comprimida 3.20 | `aire_labios`, `taco_largo` | `guarda_rendija()`, `guarda_aire()` |
| persiana: placa 6, borde 4, varilla 2.0, paso medio 7.0, ciego 4, atados de 4, 0.3 sobre la base | `t_persiana`, `borde_persiana`, `varilla_persiana`, `paso_persiana`, `hondo_ciego_persiana`, `alto_atado`, `suelo_persiana` | `guarda_persiana()`, `cad/persiana.py` |
| tacos Ø8 × 3.5 a 6.5 de la silueta; bolsillos Ø9 × 3.8, localizador 8 H7, colisa 8 × 10; imanes Ø6 × 3, × 2 y × 1 | `u_taco`, `d_taco`, `alto_taco`, `d_bolsillo_taco`, `hondo_bolsillo_taco`, `colisa_taco`, `d_iman`, `alto_iman_*` | `guarda_tacos_persiana()`, `anillo_tiene_bolsillos()` |
