sssamuelll/sam17/case/plans/escuadra_enchufe_2d.dxf

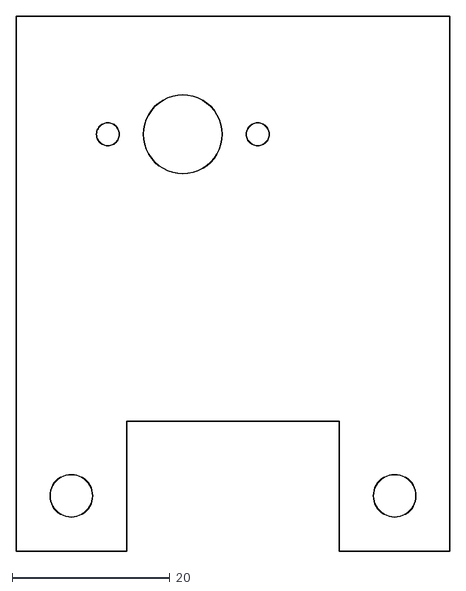
[picture p1: CAD file, 2026-10-26]
case/plans/escuadra_enchufe_2d.dxf
55.0 x 67.8
