sssamuelll/sam17/hardware/01-power-supply/v5/schematics/sam17-power-v5.pdf

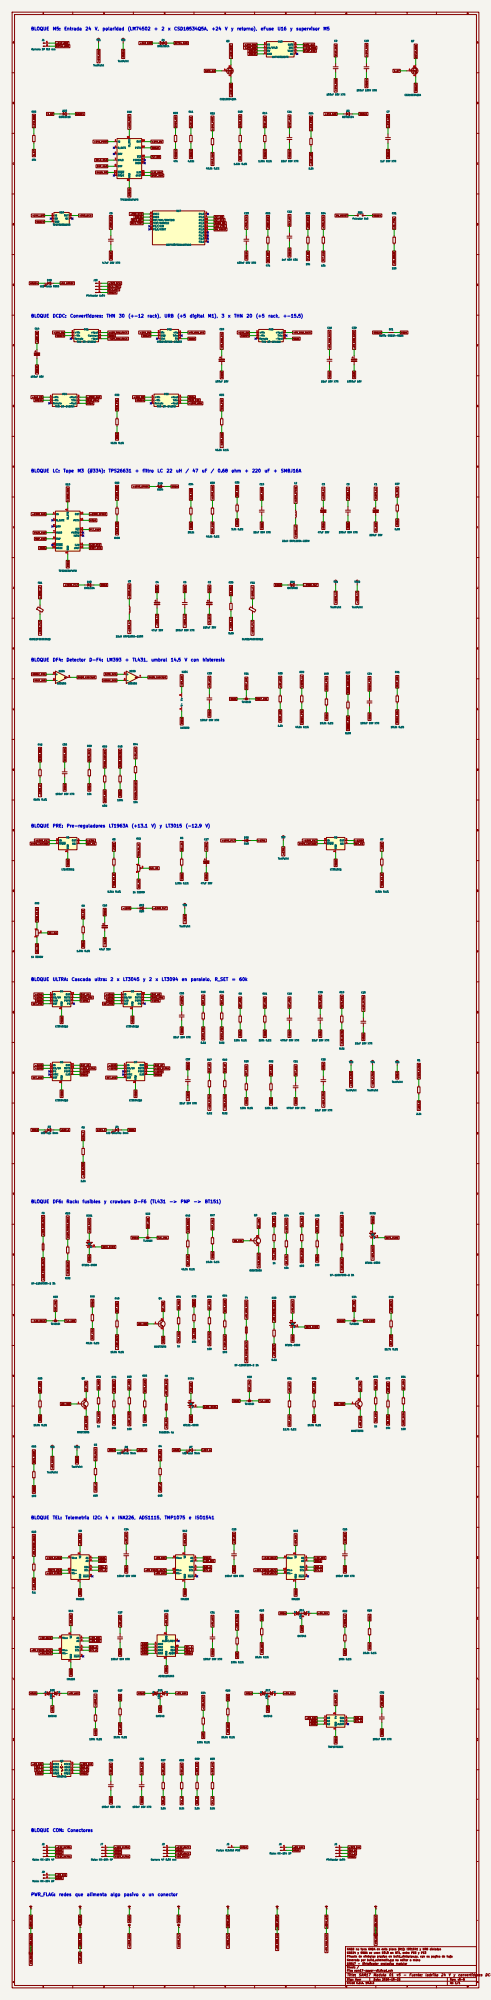
[picture p2: page 1]

BLOQUE M5: Entrada 24 V, polaridad (LM74502 + 2 x CSD18534Q5A, +24 V y retorno), eFuse U16 y supervisor M5

FLT 15 PGTH 16 PGOOD 17 OUT 18 U16

dVdT 10 ILIM 11 MODE 12 SHDN 13

BLOQUE DCDC: Convertidores: THN 30 (+-12 rack), URB (+5 digital M1), 3 x THN 20 (+5 rack, +-15.5)

BLOQUE LC: Tope M3 (#334): TPS26631 + filtro LC 22 uH / 47 uF / 0.68 ohm + 220 uF + SMBJ16A
FLT 15 PGTH 16 PGOOD 17 OUT 18 U19

FB1 BLM21PG600SN1D

BLOQUE DF4: Detector D-F4: LM393 + TL431, umbral 14.5 V con histeresis
SENSE_POS -12V_RAW_RACK

BLOQUE PRE: Pre-reguladores LT1963A (+13.1 V) y LT3015 (-12.9 V)

BLOQUE ULTRA: Cascada ultra: 2 x LT3045 y 2 x LT3094 en paralelo, R_SET = 60k

BLOQUE DF6: Rack: fusibles y crowbars D-F6 (TL431 -> PNP -> BT151)

PWR_FLAG: redes que alimenta algo pasivo o un conector

GNDD no toca GNDA en esta placa (M1): ISO1541 y URB aislados
GND24 y GNDA se unen SOLO en NT1, entre PS5 y PS3
Generado por build_schematic.py: no editar a mano Pinouts de simbolos propios en build_simbolos.py, con su pagina de hoja

SAM17 - Sintetizador analogico modular
Sheet: /
File: sam17-power-v5.kicad_sch
Title: SAM17 Modulo 01 v5 - Fuente: ladrillo 24 V y convertidores DC-DC

Size: User | Rev: v5-B
KiCad E.D.A. 10.0.3 | Id: 1/1
