sssamuelll/sam17/hardware/01-power-supply/v5/kicad/sam17-power-v5.kicad_pcb

## KiCad design hardware/01-power-supply/v5/kicad/sam17-power-v5.kicad_pcb (2026-10-27)

Schematic: sam17-power-v5.kicad_sch, SAM17 Modulo 01 v5 - Fuente: ladrillo 24 V y convertidores …

Parts:
C1, C2: 220uF 35V; CP_Elec_8x10; MPN EEEFK1V221P; LCSC C178562
C3, C4, C17, C18: 47uF 35V; CP_Elec_6.3x7.7; MPN VZH470M1VTR-0607; LCSC C249923
C5, C6, C9, C23, C24, C25, C26, C27, C28, C30, C31, C32, C33, C34, C35: 100nF 50V X7R; C_0805_2012Metric; MPN CC0805KRX7R9BB104; LCSC C49678
C7: 1uF 50V X7R; C_0805_2012Metric; MPN CL21B105KBFNNNE; LCSC C28323
C8: 4.7uF 25V X7R; C_0805_2012Metric; MPN CC0805KKX7R8BB475; LCSC C354262
C10: 100nF 100V X7R; C_0805_2012Metric; MPN CC0805KKX7R0BB104; LCSC C106243
C11, C13: 22nF 50V X7R; C_0805_2012Metric; MPN CL21B223KBANNNC; LCSC C1729
C12: 1nF 50V C0G; C_0805_2012Metric; MPN CC0805JRNPO9BN102; LCSC C62774
C14: 100uF 50V; CP_Elec_8x10; MPN EEEFK1H101P; LCSC C178548
C16, C20, C22, C36, C37, C38: 22uF 25V X7R; C_1210_3225Metric; MPN GRM32ER71E226KE15L; LCSC C21397
C19, C21: 470nF 50V X7R; C_0805_2012Metric; MPN CL21B474KBFNNNE; LCSC C13967
C29: 100uF 25V; CP_Elec_6.3x7.7; MPN UCD1E101MCL1GS; LCSC C250945
C39: 1000uF 16V; CP_Elec_10x10; MPN VZH102M1CTR-1010; LCSC C249844
D1: SMBJ33CA; D_SMB; MPN SMBJ33CA; LCSC C83325
D2: BZT52C24; D_SOD-123; MPN BZT52C24-7-F; LCSC C171749
D3: LED rojo 3mm; LED_D3.0mm; MPN 204-10SURD/S530-A3-L; LCSC C99771
D4: LED amarillo 3mm; LED_D3.0mm; MPN 204-10UYD/S530-A3-L; LCSC C85160
D6: LED verde 3mm; LED_D3.0mm; MPN 204-10SYGD/S530-E2-L; LCSC C181864
D7: LED azul 3mm; LED_D3.0mm; MPN 204-10SUBC/S400-A4; LCSC C86881
D10: SMBJ16A; D_SMB; MPN SMBJ16A; LCSC C151254
D11: BAT54WS; D_SOD-323; MPN BAT54WS-7-F; LCSC C124205
D12, D13: S1M; D_SMA; MPN S1M-E3/61T; LCSC C144860
D14, D15, D16, D17: BAT54S; SOT-23; MPN BAT54SLT1G; LCSC C19726
D18: LED verde 0805; LED_0805_2012Metric; MPN LTST-C170KGKT; LCSC C98221
D19: SS34; D_SMA; MPN SS34; LCSC C8678
D20: BZT52C15; D_SOD-123; MPN BZT52C15-7-F; LCSC C177014
F2, F3: SF-1206F300-2 3A; Fuse_1206_3216Metric; MPN SF-1206F300-2; LCSC C208499
F4: SF-1206F200-2 2A; Fuse_1206_3216Metric; MPN SF-1206F200-2; LCSC C719183
F5: 0466004 4A; Fuse_1206_3216Metric; MPN 0466004.NRHF; LCSC C187596
FB1, FB2: BLM21PG600SN1D; L_0805_2012Metric; MPN BLM21PG600SN1D; LCSC C18305
J1: Bornera 2P 5.0 mm; TerminalBlock_MaiXu_MX126-5.0-02P_1x02_P5.00mm; MPN MX126-5.0-02P-GN01-Cu-S-A; LCSC C5188434
J2, J7: Molex KK-254 4P; Molex_KK-254_AE-6410-04A_1x04_P2.54mm_Vertical; MPN 22-27-2041; LCSC C504991
J3: Bornera 4P 5.08 mm; TerminalBlock_Phoenix_MKDS-1,5-4-5.08_1x04_P5.08mm_Horizont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; MPN 1715747; LCSC C5443561
J5: Faston 6.3x0.8 PCB; Faston_6.3x0.8mm_PCB_2Leg_P5.0mm; MPN 3866A.68
J6, J9: Molex KK-254 2P; Molex_KK-254_AE-6410-02A_1x02_P2.54mm_Vertical; MPN 22-27-2021; LCSC C293316
J8, J10: PinHeader 1x04; PinHeader_1x04_P2.54mm_Vertical; MPN PZ254V-11-04P; LCSC C2691448
L2, L3: 22uH SRP1265A-220M; L_Bourns_SRP1265A; MPN SRP1265A-220M; LCSC C2041465
NT1: NetTie GND24-GNDA; NetTie-2_SMD_Pad2.0mm; MPN —
PS1: THN 30-2422WI; Converter_DCDC_TRACO_THL30-xxxxWI_THT; MPN THN 30-2422WI
PS2: URB2405YMD-20WR3; Converter_DCDC_Mornsun_URB_YMD-20WR3_Horizontal_THT; MPN URB2405YMD-20WR3
PS3: THN 20-2411WI; Converter_DCDC_TRACO_THL30-xxxxWI_THT; MPN THN 20-2411WI
PS4, PS5: THN 20-2413WI; Converter_DCDC_TRACO_THL30-xxxxWI_THT; MPN THN 20-2413WI
Q2, Q7: CSD18534Q5A; TDSON-8-1; MPN CSD18534Q5A; LCSC C115943
Q3, Q4, Q5, Q6: MMBT3906; SOT-23; MPN MMBT3906LT1G; LCSC C53444
R1, R2, R57, R58, R59, R60: 2.2k; R_0805_2012Metric; MPN 0805W8F2201T5E; LCSC C17520
R3, R4: 680; R_0805_2012Metric; MPN 0805W8F6800T5E; LCSC C17798
R5: 9.31k 0.1%; R_0805_2012Metric; MPN RT0805BRD079K31L; LCSC C865720
R6, R8: 1.00k 0.1%; R_0805_2012Metric; MPN RT0805BRD071KL; LCSC C110774
R7: 9.09k 0.1%; R_0805_2012Metric; MPN RT0805BRD079K09L; LCSC C865717
R9, R10, R61, R62: 120k 0.1%; R_0805_2012Metric; MPN RT0805BRD07120KL; LCSC C865161
R11: 4.02k; R_0805_2012Metric; MPN 0805W8F4021T5E; LCSC C17663
R12, R35: 49.9k 0.1%; R_0805_2012Metric; MPN RT0805BRD0749K9L; LCSC C469661
R13: 1.62k 0.1%; R_0805_2012Metric; MPN TC0525B1621T5G; LCSC C50670348
R14: 1.96k 0.1%; R_0805_2012Metric; MPN TNPW08051K96BEEN; LCSC C2093012
R15, R16, R17, R18, R19, R29, R30: 0.02; R_2512_6332Metric; MPN WSL2512R0200FEA; LCSC C553969
R20: 0.1; R_2512_6332Metric; MPN WSL2512R1000FEA; LCSC C844904
R21, R22, R23, R24: 100k 0.1%; R_0805_2012Metric; MPN RT0805BRD07100KL; LCSC C122537
R25, R26, R27, R28: 20.0k 0.1%; R_0805_2012Metric; MPN RT0805BRD0720KL; LCSC C469660
R31: 220; R_0805_2012Metric; MPN 0805W8F2200T5E; LCSC C17557
R32, R33, R45, R46: 45.3k 0.1%; R_0805_2012Metric; MPN RT0805BRE0745K3L; LCSC C866072
R34: 18.2k; R_0805_2012Metric; MPN 0805W8F1822T5E; LCSC C17497
R36: 3.9k 0.1%; R_0805_2012Metric; MPN RT0805BRD073K9L; LCSC C865471
R37, R38: 0.68; R_1206_3216Metric; MPN 1206W4F680LT5E; LCSC C19108
R39: 47.5k 0.1%; R_0805_2012Metric; MPN RT0805BRD0747K5L; LCSC C865514
R40, R47, R48, R50, R52: 10.0k 0.1%; R_0805_2012Metric; MPN RT0805BRD0710KL; LCSC C110775
R41: 10.2k 0.1%; R_0805_2012Metric; MPN RT0805BRD0710K2L; LCSC C865134
R42: 59.0k 0.1%; R_0805_2012Metric; MPN RT0805BRD0759KL; LCSC C865570
R43: 100k; R_0805_2012Metric; MPN 0805W8F1003T5E; LCSC C149504
R44, R66, R68, R74, R75, R76, R77, R84, R85: 10k; R_0805_2012Metric; MPN 0805W8F1002T5E; LCSC C17414
R49, R51: 12.7k 0.1%; R_0805_2012Metric; MPN TC0525B1272T5G; LCSC C50670219
R53, R54, R55, R56, R78, R79, R80, R81: 100; R_0805_2012Metric; MPN 0805W8F1000T5E; LCSC C17408
R63, R64: 1.2k; R_0805_2012Metric; MPN 0805W8F1201T5E; LCSC C17379
R65, R83: 47k; R_0805_2012Metric; MPN 0805W8F4702T5E; LCSC C17713
R67, R82: 6.8M; R_0805_2012Metric; MPN 0805W8F6804T5E; LCSC C17773
R69: 10M; R_0805_2012Metric; MPN 0805W8F1005T5E; LCSC C26108
R70, R71, R72, R73: 1k; R_0805_2012Metric; MPN 0805W8F1001T5E; LCSC C17513
RV2, RV3: 1k 3296W; Potentiometer_Bourns_3296W_Vertical; MPN 3296W-1-102LF; LCSC C57089
SCR1, SCR2, SCR3, SCR4: BT151-500R; TO-220-3_Vertical; MPN BT151-500R,127; LCSC C9211
SW1: Pulsador 6x6; SW_PUSH_6mm; MPN B3F-1000; LCSC C93157
TP1, TP2, TP3, TP4, TP5, TP6, TP7, TP8, TP9, TP10, TP11: TestPoint; TestPoint_THTPad_D2.0mm_Drill1.0mm; MPN —
U1: LT1963AEQ; TO-263-5_TabPin3; MPN LT1963AEQ#TRPBF; LCSC C459702
U2: LT3015EQ; TO-263-5_TabPin3; MPN LT3015EQ#PBF; LCSC C666306
U4, U5: LT3045EDD; DFN-10-1EP_3x3mm_P0.5mm_EP1.65x2.38mm_ThermalVias; MPN LT3045EDD#TRPBF; LCSC C514420
U6, U7: LT3094EDD; DFN-12-1EP_3x3mm_P0.45mm_EP1.65x2.38mm_ThermalVias; MPN LT3094EDD#TRPBF; LCSC C670493
U8, U12, U13, U14: INA226; TSSOP-10_3x3mm_P0.5mm; MPN INA226AIDGSR; LCSC C49851
U9: ISO1541; SOIC-8_3.9x4.9mm_P1.27mm; MPN ISO1541DR; LCSC C143028
U10: ADS1115IDGS; TSSOP-10_3x3mm_P0.5mm; MPN ADS1115IDGSR; LCSC C37593
U11: TMP1075DGK; VSSOP-8_3x3mm_P0.65mm; MPN TMP1075DGKR; LCSC C2864807
U15: LM74502DDFR; SOT-23-8; MPN LM74502DDFR; LCSC C3236215
U16, U19: TPS26631PWPR; HTSSOP-20-1EP_4.4x6.5mm_P0.65mm_EP3.4x6.5mm_Mask2.96x2.96mm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; MPN TPS26631PWPR; LCSC C2866319
U17: MSP430FR2111IPW16; TSSOP-16_4.4x5mm_P0.65mm; MPN MSP430FR2111IPW16R; LCSC C2052845
U18: TPS70933DBVR; SOT-23-5; MPN TPS70933DBVR; LCSC C89347
U20: LM393B; SOIC-8_3.9x4.9mm_P1.27mm; MPN LM393BIDR; LCSC C2865059
U21, U22, U23, U24, U25: TL431BI; SOT-23; MPN TL431BIDBZR; LCSC C41283

Connections:
+3V3_DIG: C28.1, J8.1, R59.1, R60.1, U9.8 (VCC2)
+3V3_MCU: C8.1, C23.1, J10.1, R65.1, R66.1, R84.1, U17.5 (DVCC), U18.5 (OUT)
+5V_AUX: C24.1, C25.1, C26.1, C27.1, C30.1, C31.1, C32.1, C33.1, D14.2 (K), D15.2 (K), D16.2 (K), D17.2 (K), J6.1, R20.2, R25.2, R27.2, R28.2, R44.1, R57.1, R58.1, R63.1, U8.6 (VS), U9.1 (VCC1), U10.8 (VDD), U11.7 (A0), U11.8 (V+), U12.2 (A0), U12.6 (VS), U12.8 (Vbus), U12.9 (Vin-), U13.1 (A1), U13.6 (VS), U14.1 (A1), U14.2 (A0), U14.6 (VS), U20.8 (V+)
+5V_DIG: F5.2, J9.1, Q6.2 (E), R4.1, R51.1, R77.1, SCR4.2 (A)
+5V_FUSED_RACK: F4.2, R20.1, R30.1, U12.10 (Vin+), U14.10 (Vin+)
+5V_RACK: J3.4, Q5.2 (E), R3.1, R30.2, R49.1, R76.1, SCR3.2 (A), TP5.1, U14.8 (Vbus), U14.9 (Vin-)
+5V_RAW_DIG: C29.1, F5.1, PS2.4 (+Vo)
+5V_RAW_RACK: C16.1, C39.1, F4.1, PS3.3 (+Vout)
+12V_FUSED_RACK: F2.2, R29.1, U13.10 (Vin+)
+12V_RACK: J3.1, Q3.2 (E), R29.2, R45.1, R74.1, SCR1.2 (A), U13.8 (Vbus), U13.9 (Vin-)
+12V_RAW_RACK: F2.1, PS1.3 (+Vout)
+12V_ULTRA: C20.1, J2.4, J7.4, R1.1, R19.2, TP3.1, U8.8 (Vbus), U8.9 (Vin-)
+13V1: C17.1, C36.1, D12.2 (A), R5.1, TP7.1, U1.4 (OUT), U4.1 (IN), U4.2 (IN), U4.3 (EN/UV), U4.6 (PGFB), U5.1 (IN), U5.2 (IN), U5.3 (EN/UV), U5.6 (PGFB)
+15V5_EFUSE: D19.1 (K), L2.1, U19.18 (OUT), U19.19 (OUT), U19.20 (OUT)
+15V5_FILT: D10.1 (K), D12.1 (K), FB1.2, U1.2 (IN)
+15V5_LC: C1.1, C3.1, C5.1, FB1.1, L2.2, R22.1, R39.1, TP9.1
+15V5_RAW: PS4.3 (+Vout), R35.1, R82.1, U19.1 (IN), U19.2 (IN), U19.3 (IN), U19.6 (IN_SYS)
+24V_LDO: C7.1, D2.1 (K), R64.2, U18.1 (IN)
+24V_PROT: Q2.5 (D), R12.1, R64.1, U16.1 (IN), U16.2 (IN), U16.3 (IN), U16.6 (IN_SYS)
+24V_RAW: C9.2, C10.1, D1.1 (A1), J1.1, Q2.1 (S), Q2.2 (S), Q2.3 (S), R85.1, TP1.1, U15.1 (EN/UVLO), U15.5 (VS), U15.8 (SRC)
+24V_SW: C14.1, PS1.1 (+Vin), PS2.3 (Vin), PS3.1 (+Vin), PS4.1 (+Vin), PS5.1 (+Vin), U16.18 (OUT), U16.19 (OUT), U16.20 (OUT)
-12V9: C18.2, C37.2, D13.1 (K), R7.1, TP8.1, U2.5 (OUT), U6.1 (IN), U6.2 (IN), U6.3 (EN/UV), U6.5 (PGFB), U6.13 (IN), U7.1 (IN), U7.2 (IN), U7.3 (EN/UV), U7.5 (PGFB), U7.13 (IN)
-12V_RACK: F3.2, J3.3, R24.1, R48.2, R54.2, SCR2.1 (K), U23.3 (A)
-12V_RAW_RACK: F3.1, PS1.5 (-Vout)
-12V_ULTRA: C22.2, J2.1, J7.1, R2.2, R17.2, R18.2, R21.1, TP4.1, U6.10 (OUTS), U7.10 (OUTS)
-15V5_FILT: D11.2 (A), D13.2 (A), FB2.2, U2.3 (IN)
-15V5_LC: C4.2, C6.2, FB2.1, L3.2, R23.1, R38.2, R42.2, TP10.1
-15V5_RAW: L3.1, PS5.5 (-Vout), R33.2
ADJ_U1: R6.1, RV2.2, RV2.3, U1.5 (ADJ)
ADJ_U2: R8.1, RV3.2, RV3.3, U2.4 (ADJ)
AIN0: D14.3 (COM), R21.2, R25.1, U10.4 (AIN0)
AIN1: D15.3 (COM), R22.2, R26.1, U10.5 (AIN1)
AIN2: D16.3 (COM), R23.2, R27.1, U10.6 (AIN2)
AIN3: D17.3 (COM), R24.2, R28.1, U10.7 (AIN3)
C1_NEG: C1.2, R37.1
C2_NEG: C2.2, R38.1
DVDT_U16: C11.1, U16.10 (dVdT)
DVDT_U19: C13.1, U19.10 (dVdT)
FLT_M5: R66.2, U16.15 (~FLT), U17.1 (P1.1)
FLT_U19: R84.2, U17.16 (P1.2), U19.15 (~FLT)
GATE_Q2: Q2.4 (G), U15.6 (GATE)
GATE_SCR1: R53.1, R78.2, SCR1.3 (G)
GATE_SCR2: R54.1, R79.2, SCR2.3 (G)
GATE_SCR3: R55.1, R80.2, SCR3.3 (G)
GATE_SCR4: R56.1, R81.2, SCR4.3 (G)
GND24: C7.2, C8.2, C10.2, C11.2, C12.2, C14.2, C23.2, D2.2 (A), D18.1 (K), D20.2 (A), J10.4, NT1.1, PS1.2 (-Vin), PS2.2 (GND), PS3.2 (-Vin), PS4.2 (-Vin), PS5.2 (-Vin), Q7.1 (S), Q7.2 (S), Q7.3 (S), R11.2, R14.2, R83.2, SW1.2, TP2.1, U15.2 (GND), U15.7 (OV), U16.9 (GND), U16.16 (PGTH), U16.21 (GND), U17.6 (DVSS), U18.2 (GND)
GNDA: C2.1, C3.2, C4.1, C5.2, C6.1, C13.2, C16.2, C17.2, C18.1, C19.2, C20.2, C21.2, C22.1, C24.2, C25.2, C26.2, C27.2, C30.2, C31.2, C32.2, C33.2, C34.2, C35.2, C36.2, C37.1, C38.2, C39.2, D3.1 (K), D4.2 (A), D6.1 (K), D10.2 (A), D11.1 (K), D14.1 (A), D15.1 (A), D16.1 (A), D17.1 (A), D19.2 (A), J2.2, J2.3, J3.2, J5.1, J6.2, J7.2, J7.3, NT1.2, PS1.4 (Common), PS3.5 (-Vout), PS4.5 (-Vout), PS5.3 (+Vout), Q4.2 (E), R6.2, R8.2, R9.2, R10.2, R26.2, R32.2, R34.2, R36.2, R37.2, R40.2, R43.2, R46.1, R47.2, R50.2, R53.2, R55.2, R61.2, R62.2, R68.2, R75.1, SCR1.1 (K), SCR2.2 (A), SCR3.1 (K), TP6.1, U1.3 (GND), U2.2 (GND), U4.5 (ILIM), U4.8 (GND), U4.11 (GND), U5.5 (ILIM), U5.8 (GND), U5.11 (GND), U6.6 (ILIM), U6.9 (GND), U7.6 (ILIM), U7.9 (GND), U8.1 (A1), U8.2 (A0), U8.7 (GND), U9.4 (GND1), U10.1 (ADDR), U10.3 (GND), U11.4 (GND), U11.5 (A2), U11.6 (A1), U12.1 (A1), U12.7 (GND), U13.2 (A0), U13.7 (GND), U14.7 (GND), U19.9 (GND), U19.12 (MODE), U19.16 (PGTH), U19.21 (GND), U20.4 (V-), U21.3 (A), U22.3 (A), U24.3 (A)
GNDD: C28.2, C29.2, D7.1 (K), J8.4, J9.2, PS2.6 (0V), R52.2, R56.2, SCR4.1 (K), TP11.1, U9.5 (GND2), U25.3 (A)
G_Q7: D20.1 (K), Q7.4 (G), R85.2
ILIM_U16: R11.1, U16.11 (ILIM)
ILIM_U19: R34.1, U19.11 (ILIM)
LED3_A: D3.2 (A), R1.2
LED4_K: D4.1 (K), R2.1
LED6_A: D6.2 (A), R3.2
LED7_A: D7.2 (A), R4.2
LED_ANODE: D18.2 (A), R31.2
LED_CTRL: R31.1, U17.14 (P1.4)
MCU_RST: C12.1, J10.3, R65.2, U17.4 (RST/NMI/SBWTDIO)
MCU_TEST: J10.2, U17.3 (TEST/SBWTCK)
OUTS_POS: C38.1, R15.2, R16.2, R19.1, U4.9 (OUTS), U5.9 (OUTS), U8.10 (Vin+)
OUT_U4: R15.1, U4.10 (OUT)
OUT_U5: R16.1, U5.10 (OUT)
OUT_U6: R17.1, U6.11 (OUT), U6.12 (OUT)
OUT_U7: R18.1, U7.11 (OUT), U7.12 (OUT)
OVP_U16: R13.2, R14.1, U16.8 (OVP)
OVP_U19: R35.2, R36.1, U19.8 (OVP)
QB_CB1: Q3.1 (B), R70.1, R74.2
QB_CB2: Q4.1 (B), R71.1, R75.2
QB_CB3: Q5.1 (B), R72.1, R76.2
QB_CB4: Q6.1 (B), R73.1, R77.2
QC_CB1: Q3.3 (C), R78.1
QC_CB2: Q4.3 (C), R79.1
QC_CB3: Q5.3 (C), R80.1
QC_CB4: Q6.3 (C), R81.1
REF0_NEG: R68.1, R69.2, U20.5 (+)
REF_CB1: R45.2, R47.1, U22.2 (REF)
REF_CB2: R46.2, R48.1, U23.2 (REF)
REF_CB3: R49.2, R50.1, U24.2 (REF)
REF_CB4: R51.2, R52.1, U25.2 (REF)
RET24_RAW: D1.2 (A2), J1.2, Q7.5 (D)
SCL_A: R58.2, U8.5 (SCL), U9.3 (SCL1), U10.10 (SCL), U11.2 (SCL), U12.5 (SCL), U13.5 (SCL), U14.5 (SCL)
SCL_D: J8.3, R60.2, U9.6 (SCL2)
SDA_A: R57.2, U8.4 (SDA), U9.2 (SDA1), U10.9 (SDA), U11.1 (SDA), U12.4 (SDA), U13.4 (SDA), U14.4 (SDA)
SDA_D: J8.2, R59.2, U9.7 (SDA2)
SENSE_NEG: C35.1, R41.2, R42.1, U20.6 (-)
SENSE_POS: C34.1, R39.2, R40.1, R67.2, U20.3 (+)
SET_NEG: C21.1, R10.1, R62.1, U6.8 (SET), U7.8 (SET)
SET_POS: C19.1, R9.1, R61.1, U4.7 (SET), U5.7 (SET)
SHDN_CASCADE: R43.1, R44.2, R67.1, R69.1, U1.1 (~SHDN), U2.1 (~SHDN), U20.1, U20.7
SHDN_M5: R83.1, U16.13 (~SHDN), U17.15 (P1.3)
SW_RESET: SW1.1, U17.13 (P1.5)
TLK_CB1: R70.2, U22.1 (K)
TLK_CB2: R71.2, U23.1 (K)
TLK_CB3: R72.2, U24.1 (K)
TLK_CB4: R73.2, U25.1 (K)
TRIM_PS4: PS4.4 (Trim), R32.1
TRIM_PS5: PS5.4 (Trim), R33.1
TRIM_U1_HI: R5.2, RV2.1
TRIM_U2_HI: R7.2, RV3.1
UVLO_U16: R12.2, R13.1, U16.7 (UVLO)
UVLO_U19: R82.2, U19.7 (UVLO)
VCAP_U15: C9.1, U15.4 (VCAP)
VREF_2V5: R41.1, R63.2, U20.2 (-), U21.1 (K), U21.2 (REF)

Notes on the sheet:
BLOQUE M5: Entrada 24 V, polaridad (LM74502 + 2 x CSD18534Q5A, +24 V y retorno), eFuse U16 y supervisor M5
BLOQUE DCDC: Convertidores: THN 30 (+-12 rack), URB (+5 digital M1), 3 x THN 20 (+5 rack, +-15.5)
BLOQUE LC: Tope M3 (#334): TPS26631 + filtro LC 22 uH / 47 uF / 0.68 ohm + 220 uF + SMBJ16A
BLOQUE DF4: Detector D-F4: LM393 + TL431, umbral 14.5 V con histeresis
BLOQUE PRE: Pre-reguladores LT1963A (+13.1 V) y LT3015 (-12.9 V)
BLOQUE ULTRA: Cascada ultra: 2 x LT3045 y 2 x LT3094 en paralelo, R_SET = 60k
BLOQUE DF6: Rack: fusibles y crowbars D-F6 (TL431 -> PNP -> BT151)
BLOQUE TEL: Telemetria I2C: 4 x INA226, ADS1115, TMP1075 e ISO1541
BLOQUE CON: Conectores
PWR_FLAG: redes que alimenta algo pasivo o un conector

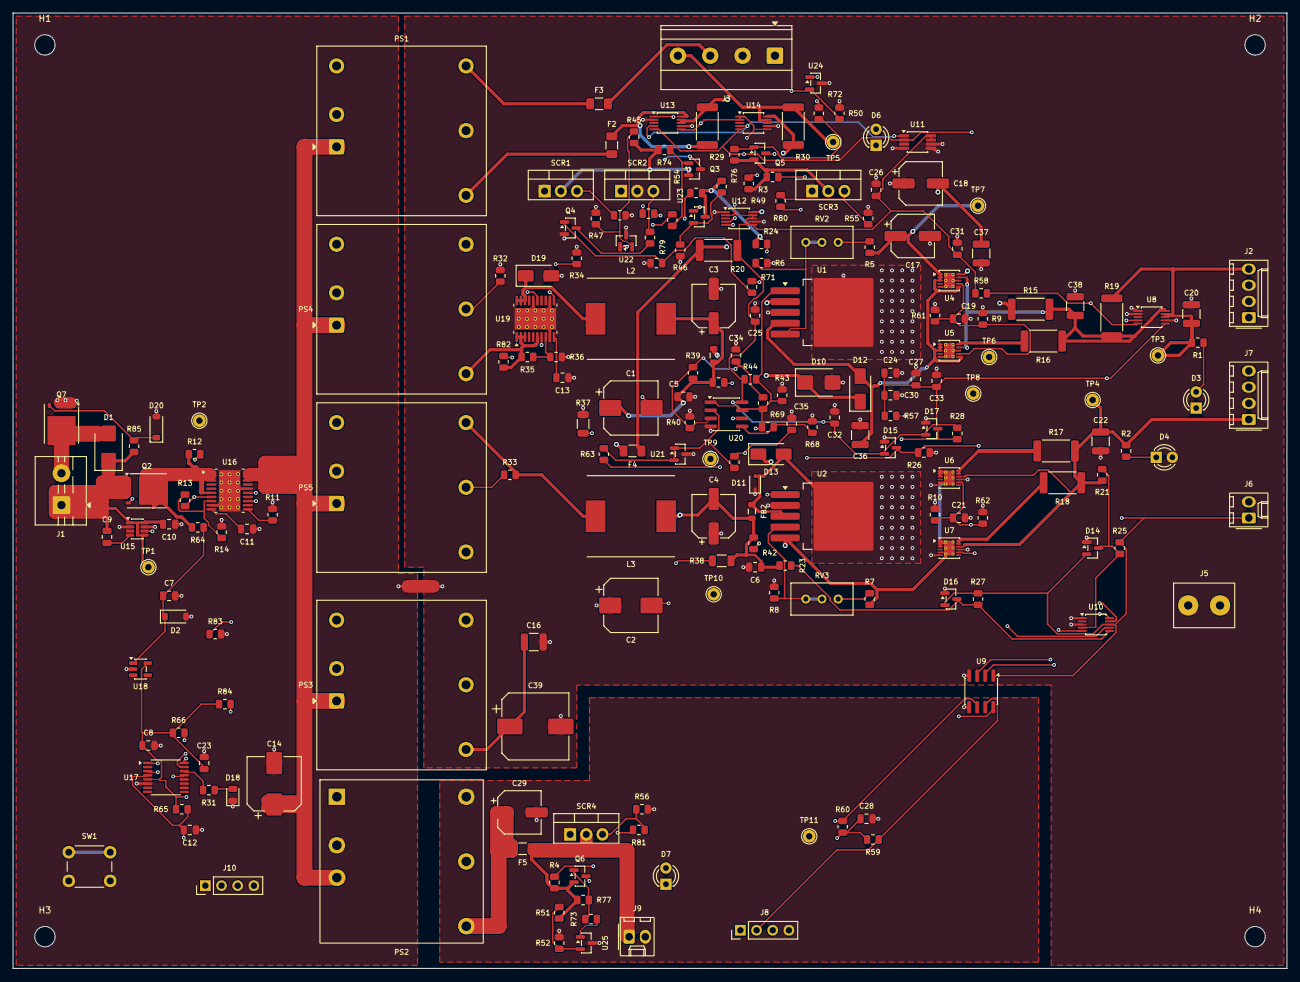
[picture p10: board sam17-power-v5.kicad_pcb from above]

Board: 4 copper layers, 200.0 x 150.0 mm, 215 parts (0 on the bottom side), 103 nets.

Other parts of the board:
H1, H2, H3, H4: MountingHole_3.2mm_M3
