sssamuelll/sam17/(commit log)

2026-10-24 docs: el README dice que la fuente que se construye es la v5
    El README raíz trataba la v4 y la v5 como dos versiones aparcadas y daba las
    decisiones de la v5 por condicionales; D-V1..D-V5 están firmadas desde el
    2026-09-08. Ahora dice que la placa de la v5 está ruteada, con el DRC en cero
    y las puertas en verde, y qué la separa del cobre: los 16 HUECOS de §9.2, la
    propuesta de piezas sin firmar y los issues abiertos del hito 1.
    El README de 01-power-supply seguía diciendo que la que se fabrica es la v2.
    Su banner pasa a ser el mapa de las cinco versiones con su estado; el cuerpo
    sigue describiendo la v1.
2026-10-25 hardware: fuente v5, #334 lo corta el disparo rapido de U19 y L2 pasa a SRP1265A-220M
    check_absmax.py daba 18,11 V en IN de U1 llevando 12,7 A por L2 con sus
    22 uH enteros hasta el OVP de U19, a los 14 us. La SRR1260-220M satura a
    3,7 A, y con la bobina saturada el pico dependia de una curva L-I que su
    hoja no publica: 18,9 o 21,4 V segun la curva supuesta, contra 20 V.
    - L2 = Bourns SRP1265A-220M (LCSC C2041465): 22 uH +-20 %, Isat 12 A,
    DCR 37 mOhm max, SRF 6 MHz tip. y curva L-I publicada hasta 12 A
    (bourns_srp1265a.pdf p. 1 y 3). L3 sigue en SRR1260-220M.
    - El modelo RK4 corta por lo primero que llegue en U19: el disparo rapido
    a 3 x I(OL) (3,28 A max con R34) en <= 4,5 us, el SCP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
2026-10-25 hardware: fuente v5, placa y fabricacion con L2 en SRP1265A-220M
    Placa colocada y ruteada de nuevo: Freerouting en 3 rondas y el rescate
    cierra las 7 conexiones que deja abiertas. L2 sigue en (97, 48); su
    cuerpo pasa de 12,5 a 13,5 mm en x.
    build_pcb.py: Freerouting salio de U4.9 por su cuenta y puso la via a
    mitad de la salida fija de OUTS_POS, con 0,8 mm de punta colgando.
    limpiar_colgantes() ya no deja asi una pista fija: la recorta hasta el
    ultimo contacto de su red (_recortar), y lo de antes no cambia.
    - 1510 pistas y 284 vias (263 de 0,6/0,3 mm y 21 de 0,8/0,4 mm).
    - Bajo el cuerpo de L2 pasan ahora +15V5_FILT en F.Cu, entre sus pads, y
    SCL_A/SDA_A en In2, debajo del plano de In1.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
2026-10-25 docs: propuesta de piezas v5, el piso de 80 W aguanta y los crudos van a 450 mA
    Los dos puntos de §8 que quedaban antes de la junta, contestados:
    - El piso de cribado de 80 W aguanta. ladrillo_budget.py pide al ladrillo
    65,36 W en el peor caso declarado, y el TE90, el candidato de menos
    margen, da 82,5 W a 45 °C (ae-TE90-datasheet.pdf p. 3): +17,14 W.
    H-PL-ENTREGA sigue abierto, porque tres de los cuatro modelos montados
    solo publican rendimientos típicos.
    - Los crudos se dimensionaron el 2026-10-23 a 450 mA/riel. Cada
    THN 20-2413WI lleva hasta 0,620 A (9,85 W, el 49 % de sus 20 W); un
    módulo de 10 W quedaría al 98 %.
2026-10-25 docs: junta de las piezas de la fuente v5
    Dictamen sobre las siete piezas de la propuesta del 2026-10-22, contra lo
    firmado (v5 §8 y §9, las D-F vigentes de la v4, el pliego y el censo) y
    contra la placa v5-B. Ninguna sale firmable tal cual: P1, P2, P3, P4 y P6
    con condición, el TE90 con condición, el respaldo Mean Well y P7 no
    firmables aún, y ninguna a tumbar.
    Defectos del árbol, cada uno con su issue:
    - El arnés de X1 une los pines 1 y 2 al +24 V, y en los dos ladrillos
    candidatos son de polo contrario: pone en corto el ladrillo (#487).
    - TE90A2403F01 es la variante de barril; el camino 1 necesita la opción
    49 (#488).
    - La placa no tiene los interruptores de carga del ±12 V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
2026-10-25 docs: notas de aplicación de TRACO para los THN de la fuente v5
    Versiona las tres notas a las que remiten las hojas de los THN 20WI y
    30WI: las curvas características de cada serie (derating, pérdida contra
    carga y escalón de carga del 25 %) y el ajuste de tensión de las THN
    15WI, 20WI y 30WI. La BOM cita la nota de ajuste en PS4/PS5 y R32/R33:
    G = 10000, H = 5110, K = 12,5 y L = 2,5 son las constantes de los xx13WI
    que ya usaba, y la resistencia de subida va de Trim a -Vout, como en la
    netlist.
    La junta de las piezas anota lo que cambian. En P3, la constante del
    recorte ya tiene hoja; la captura típica de un escalón del 25 % sube unos
    0,19 V contra los 0,18 V de ventana de U19, que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
2026-10-26 fix(fuente-v5): derating de los THN con las curvas de TRACO, por potencia total
    curvas.py atribuia a los THN 30-2422WI y THN 20-2413WI una frase de derating
    que sus hojas no tienen (#492). Las curvas salen ahora de las notas de TRACO
    (traco_thn30wi_characteristic_curves.pdf p. 11 y traco_thn20wi_characteristic_curves.pdf
    p. 7), traza de conveccion natural sin disipador, con cada punto en el borde
    frio del trazo:
    - THN 30-2422WI: 100 % hasta 54 C (antes 65 C), 50 % en 75,5 C, 0 % en 100 C.
    - THN 20-2413WI: 100 % hasta 63 C (antes 75 C), 50 % en 80,3 C, 0 % en 101 C.
    test_curvas.py coteja las dos curvas con la banda del trazo a cada
    temperatura leida de la figura, y salta si un punto se muev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
2026-10-26 docs(fuente-v5): decisiones firmadas de la junta de piezas
    La junta registra las decisiones de sec. 4.1, 4.2, 4.4 y 4.5:
    - 4.1: el arnes de X1 lleva un pin por polo (X1.1 -> J1.1, X1.2 -> J1.2).
    - 4.2: el TE90 va en su variante A, con la salida flotante: TE90A2449F01.
    - 4.4: D-F4 sale del par de rack si TRACO confirma por escrito que una falta
    en una salida del THN 30 baja las dos; si no, la restitucion vuelve a la mesa.
    - 4.5: SCR4 queda sin montar, y el modulo 2 hereda el requisito de aguantar
    los 8,0 V del OVP maximo del URB.
    Sec. 5 se ajusta a esas decisiones: SCR4 sin montar ya no es condicional, el
    filtro de los crowbars sale de la placa, y el banco suma el punto «los dos o
    ning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
2026-10-26 fix(fuente-v5): el respaldo Mean Well sale de los guiones y los papeles
    La junta de piezas v5 (sec. 4.3) retira los GST120A24-R7B y GSM120A24-R7B
    como respaldo del ladrillo: los dos se enclavan en sobretension desde el
    105 %, y el TE90 queda como unica referencia.
    - curvas.py pierde sus tres curvas de derating y sus citas; test_curvas.py,
    sus dos anclas a 45 C.
    - ladrillo_budget.py los saca de LADRILLOS_45C_W. Sus veredictos no cambian:
    el TE90 (82,5 W a 45 C) ya era el candidato mas justo.
    - check_bringup.py y docs/modules/01-power-supply.md nombran solo el TE90.
    - La propuesta lleva la nota en su sec. 3, y docs/references.md marca las dos
    hojas como respaldo retirado. Las hojas se q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
2026-10-26 fix(fuente-v5): arnes de X1 con dos pines por polo para el TE90, y su puerta
    bom-chasis.csv cableaba 1+2 -> J1.1 y 3+4 -> J1.2, y en la clavija del TE90
    (opcion 49, ae-TE90-datasheet.pdf p. 6) los pines 1 y 2 son de polo contrario:
    el arnes ponia en corto el ladrillo delante de D1, del LM74502 y de U16 (#487).
    El arnes queda 1+3 -> J1.1 (+24V_RAW) y 2+4 -> J1.2 (GND24). Un pin por polo
    no cabe: U16 deja pasar 2 x I_OL durante 25,5 ms (tps2663.pdf p. 7 y 23),
    9,64 A en lo alto de su banda contra los 7,5 A de un pin, y ninguna R11 deja
    a la vez el pulso por debajo y la holgura del cordon por encima (junta de
    piezas v5, sec. 4.1).
    - check_arnes.py cruza el mapa de las notas de X1 con la polar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
2026-10-26 fix(fuente-v5): el TE90 con la opción 49, TE90A2449F01
    La hoja del TE90 codifica el enchufe en la referencia: «The "03" in the
    standard model number is replaced by the applicable digits below»
    (ae-TE90-datasheet.pdf p. 6). TE90A2403F01 es el modelo estándar, con
    barril de 2,5 x 5,5 mm; el mini-DIN de 4 polos que acopla con el
    KPJX-PM-4S es la opción 49. La variante «A» (salida flotante) es la de la
    junta de piezas §4.2.
    La clave de curvas.py, la constante de ladrillo_budget.py, los comentarios
    de recuperacion_budget.py, el punto 7 de check_bringup.py y su fila en
    medidas.csv pasan a TE90A2449F01. Las cifras no cambian: la opción solo
    cambia el enchufe. docs/references.md conserva T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
2026-10-26 fix(fuente-v5): SCR4 y su disparo sin montar; el digital, requisito al módulo 2
    El crowbar del +5 V digital disparaba dentro del transitorio sano del
    URB2405YMD-20WR3: ±8 % máximo ante un escalón de carga del 25 %
    (mornsun_urb_ymd20wr3.pdf p. 2) contra un disparo de 5,66 V ± 0,30 V, y
    REF_CB4 sin condensador. D-F6 es crowbar en los rieles de rack, y solo
    ahí (junta de piezas v5 §3.4, §4.5).
    - bom.csv: SCR4, U25, Q6, R51, R52, R56, R73, R77 y R81 en filas propias
    con supplier «SIN MONTAR»; las cantidades compradas bajan con ellas.
    Las huellas y el cobre no cambian.
    - bom_jlc.py no manda esas filas ni a JLC ni a la lista de soldar a mano;
    el BOM y el CPL de JLC pierden las och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
2026-10-26 fix(fuente-v5): banda de disparo de D-F6 desde la hoja del TL431BI
    check_absmax.py aplicaba ±0,30 V a los tres crowbars de rack. La cifra se
    derivó en la v4 para un disparo de 14 V (±1,84 % del TL431BI más el
    divisor) y la v5 copió los voltios al disparo de 5,8 V.
    banda_disparo_v() la calcula riel a riel con tl431.pdf p. 13: V_ref de
    2483 a 2507 mV con V_I(dev) de 34 mV, I_ref hasta 4 + 2,5 µA por la rama
    alta, dV_ref/dV_KA hasta −2,7 mV/V y divisores de 0,1 %.
    - ±12 V: 13,37..14,37 V (antes 13,50..14,10). Sigue bajo los 16 V de los
    invitados.
    - +5 V de rack: 5,68..6,01 V (antes 5,51..6,11).
    SANO_HOJA lleva la desviación transitoria de la hoja. El K78 declara
    150 mV ante un es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
2026-10-26 fix(fuente-v5): PS3 a THN 20-2411WI aislado, con C39 y +5V_AUX tras F4
    El K7805T de PS3 era un buck no aislado: con la entrada puenteada a la
    salida, +5V_AUX pasaba de los 6,0 V de los INA226 y del ISO1541. En el
    THN 20-2411WI la entrada y la salida solo se tocan por la barrera de
    1600 VDC, el camino que la propuesta de piezas (sec. 9.1) deja fuera del
    contrato de fallo simple.
    - C39, 1000 uF / 16 V (Lelon VZH102M1CTR-1010, C249844): con el THN a su
    limite la subida del riel baja a 0,0095 V/us y el pico queda en 5,88 V.
    - +5V_AUX cuelga de +5V_FUSED_RACK: si F4 abre tras el disparo, se apaga
    en vez de quedarse con el OVP del THN (hasta 8,20 V).
    - R49 = 12,7 kohm: SCR3 dispara entre 5,53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
2026-10-26 feat(case): escuadra del suelo para el enchufe de 24 V, y ventana de 30 x 18
    El Kycon KPJX-PM-4S de la fuente v5 (bom-chasis X1) se atornilla con dos
    M2.5 a un panel de 6.6 + espesor, y la trasera es PMMA de 8 +-1.2 que se
    quita: no puede llevarlo. Va al dorso de una escuadra de 6082-T6 de 2 mm
    con un doblez, cuyo pie se apoya en el del talon con dos CLS-M4 y cuya
    placa cierra por dentro la ventana de la trasera.
    - La placa queda a 2.0 de la cara interior nominal de la trasera: la
    regla de la trasera pide tol_pmma + 0.5 = 1.70.
    - Ventana de la trasera: 30 x 18 con esquinas R3 (iec_radio_esq), con el
    centro de la de 48 x 27.5. Las cabezas de los dos M2.5 x 8 alomados
    (23.9 de punta a p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
2026-10-26 docs(referencias): revisiones de las hojas de Kycon que hay en el repo
    kycon_KPJX-PM-4S.pdf es la Rev. C2 (2026-01-08) y kycon_KPPX-4P.pdf la
    Rev. A17 (2025-05-29), las que cita params.scad; la tabla decia A10 y A12.
2026-10-27 fix(fuente-v5): el temporizador real de U16 y el colapso tras confirmar sano
    Con PGTH a GND24 el pulso de 2 x I_OL del TPS26631 no se activa (tps2663.pdf
    p. 19 y 23): con MODE al aire, U16 limita a 1 x I_OL durante tCL_PLIM(dly),
    hasta 202 ms (p. 9), y enclava (Tabla 8-1, p. 28). El guion usaba el tCB de
    31 ms. Ahora lee PGTH y MODE de la netlist y sale rojo si cambian, y el aserto
    del pulso de 2 x I_OL contra el conector deja su sitio a esa comprobacion.
    La confirmacion de sano pasa de 200 a 225 ms: la rampa de U16 mas tCL_PLIM
    son 221,0 ms.
    Un intento confirmado queda EN PRUEBA en la FRAM hasta el rearme sano de
    60 s. Si la entrada cae antes, por ejemplo con el ladrillo en hiccup por una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
2026-10-27 docs(case): el banco del enchufe antes de pedir la escuadra (#130)
    La escuadra del enchufe no va a cotizar hasta probar un KPJX-PM-4S con una
    KPPX-4P sobre recortes de aluminio de 1, 1.5 y 2 mm. Leida a escala la hoja
    de la clavija (Rev. A17), la cara de enganche de las rampas queda de 0 a
    0.5 mm mas alla de la cara del enchufe con la placa de 2, y ninguna de las dos
    hojas da la profundidad que pide el bloqueo. El mismo banco mide la fuerza de
    insercion y de extraccion, que el calculo de flexion supone en 30 N. Si 2 mm
    no engancha y 1 mm si, la placa lleva un avellanado de 13.2 x 1.0.
    Los dos HUECO de guarda_enchufe() nombran el banco.
2026-10-27 docs(fuente-v5): las cifras de la propuesta de piezas, al dia (#495)
    Cada cifra vieja queda tachada con la actual y el guion o la hoja que la da:
    - Convertidores: cinco modulos aislados (PS1-PS5 de bom.csv); el quinto es
    el URB2405YMD-20WR3, no uno sin aislar. +5 V de rack a 0,800 A / 4,0 W con
    +5V_AUX. El RPMB si declara UVLO (recom_rpmb20.pdf p. 1 y 7).
    - Conector: el Kycon KPJX-PM-4S del camino 1; las caidas de la tabla, a los
    2,884 A del peor caso de ladrillo_budget.py (87 mV con 2 pines por polo,
    173 mV con 1; cordon 152 mV). Paginas del Mean Well corregidas a la p. 3.
    - Demanda: 65,75 W al ladrillo y +16,75 W de holgura en el TE90.
    - #334: pico de 17,40 V en U1 con el disparo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
2026-10-27 docs(fuente-v5): las firmas del 2026-10-27 en la junta de piezas
    - §3.7: PGTH a masa, confirmacion de sano a 225 ms y el intento confirmado
    en prueba hasta el rearme de 60 s.
    - §3.8: D1 pasa a SMBJ33CA, R64 a 1,2 kOhm y C10 a 100 V; el fusible queda
    fuera.
    - P7 (d): se bloquea el retorno con un N-FET de lado bajo en J1.2.
    - §4.1: el arnes se queda con dos pines por polo, ahora como margen.
    - §3.10: el banco del enchufe antes de pedir la escuadra (#130).
    - §4.6: D12 y D10 sin montar, F2/F3/F5 con nota, URB para PS2, L3 igual
    a L2 y R32/R33 al 0,1 %.
    - §4.7: +7,7 K, la cifra que imprime derating_budget.py.
    - §5: el temporizador sale de lo pendiente; el AE queda con el caso
    P-258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
2026-10-27 feat(fuente-v5): retorno bloqueado por Q7, D1 a SMBJ33CA y piezas de la lista
    Q2 solo bloqueaba la polaridad invertida por el lado positivo y J1.2 iba
    directo a GND24. J1.2 pasa a RET24_RAW, el drenador de Q7 (CSD18534Q5A, la
    pieza de Q2): su fuente es GND24 y su puerta, G_Q7, sale de +24V_RAW por R85
    (10k) con D20 (BZT52C15, V_Z max 15,6 V contra VGS +-20 V) fijando VGS. D1
    cuelga de J1 (+24V_RAW y RET24_RAW) para que un transitorio vuelva por J1
    sin cruzar Q7.
    - D1 SMBJ26CA -> SMBJ33CA (Littelfuse C83325): V_BR minimo 36,7 V, por
    encima del OVP del TE90 (36,0 V) y del de U16 (33,5 V en el borde alto);
    V_C 53,3 V a 11,3 A. R64 1k -> 1,2k (U18 IN 26,8 V, D2 315 mW) y C10 a
    100 nF / 10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
2026-10-27 feat(fuente-v5): placa y ficheros de fabricacion con Q7 en el retorno
    Regenerados con build_schematic.py, build_pcb.py y build_fab.py: DRC con
    todas las severidades y paridad con el esquematico en 0 infracciones, 0 sin
    conectar y 0 diferencias de paridad; 1464 pistas y 294 vias (271 de 0,6 mm y
    23 de 0,8 mm).
    - Q7 sobre J1.2 (rot 270, drenador abajo) y D1 a su lado; la isla
    RET24_RAW (J1.2, D1.2 y el drenador de Q7) es cobre fijo de >= 2,4 mm que
    los vertidos de GND24 rodean sin tocar, y las tres fuentes de Q7 van
    juntas a GND24 por cobre de 1,8 mm. R85 y D20 quedan junto a D1.
    - L3 en la huella de la SRP1265A (13,5 x 12,5 mm).
    - fab/: gerbers, taladros y posiciones; el BOM y el CPL d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
2026-10-27 fix(fuente-v5): medidas.csv con los limites del aire de la caja vigentes
    Los limites de subida de las aletas de U1 y U2 y de la base de los SCR salen
    de la temperatura del aire del cajon, que se calcula con los 65,44 W de
    params.scad: la hoja se escribio con los 65,31 W de antes. U1 55,3717 ->
    55,3486 K, U2 56,9194 -> 56,8963 K y los tres SCR 0,023 K menos.
2026-10-27 fix(fuente-v5): la DCR de las bobinas del LC, leida de la BOM
    margen_budget.py calculaba la caida del LC con 30 mohm heredados de la v4,
    que no eran cota de ninguna bobina montada. Ahora lee de bom.csv que pieza
    va en cada rama (L2 en U1, L3 en U2) y toma su DCR maxima de hoja: la
    SRP1265A-220M da 37,0 mohm max (bourns_srp1265a.pdf p. 1). Una bobina sin
    DCR de hoja en el guion lo pone rojo.
    Margen de U1: +872 -> +868 mV; de U2: +1109 mV.
2026-10-27 fix(fuente-v5): check_bringup.py pone rojo un criterio viejo en medidas.csv
    juzga() mide contra el rango que calcula el codigo, pero quien mide lee la
    columna criterio de la hoja, y _contrato() solo comparaba la de predicho.
    Una cota que solo vive en criterio podia quedar vieja sin que nada lo
    viera: la del aire de la aleta de U1 llevaba 55,3506 K desde la escuadra
    del enchufe con el codigo en 55,3717. Ahora cada fila tiene que decir el
    mismo rango que el codigo.
    medidas.csv regenerado con la DCR de las bobinas y Q7: U1 llega con 4 mV
    menos, y la aleta de U1 puede subir 55,3563 K.
2026-10-27 docs(case): la cuenta de potencia_disipada con Q7 en el retorno
    El literal ya era 65.44 W; el comentario que lo deriva seguia en 65.31 y sin Q7 en la cadena de entrada (0.94 W con Kycon, LM74502, Q7 y TPS26631).
2026-10-27 docs(fuente-v5): la junta y la propuesta de piezas con la placa regenerada
    - Junta: hecho el 2026-10-27 en §3.8 (D1 SMBJ33CA, R64 1,2 kOhm, C10 100 V,
    con lo que imprime check_absmax.py), P7 (d) (Q7 en el retorno: 43,3 mV y
    0,128 W a 2,889 A, DRC 0 y 0 sin conectar), §3.9 (#495) y §4.6 (D10 y
    D12 sin montar, L3 y R32/R33 unificadas, margen de U1 +868 mV). En §5
    salen D1, el bloqueo del retorno y la propuesta enmendada. La UVLO de la
    RPMB esta en la p. 7, no en la 4.
    - Propuesta: las cifras que dependen de la corriente del cordon, con Q7:
    2,889 A, 65,88 W al ladrillo, +16,62 W de holgura en el TE90, 153 mV en
    el cordon; y el margen de U1, +868 mV.
2026-10-27 docs(fuente-v5): la constante de trim de la serie WI ya no se le pregunta a TRACO (#495)
    La propuesta de piezas, §9.4 punto 1, la seguia pidiendo; esta en la nota de TRACO, traco_thn15wi_thn20wi_thn30wi_voltage_adjustment.pdf p. 1 (#497).
2026-10-27 docs: el README con el estado al 27 de octubre
    La fuente v5 con sus piezas firmadas el 26 y 27 de octubre y la placa
    regenerada, el acabado del case decidido el 11 y 12 de octubre, el soak del
    J2 de 24 h a 1 kHz en lugar de las 26 h, USB MIDI medido, y la Voz total sin
    KiCad en el repositorio. La hoja de bring-up pasa a 106 medidas.
2026-10-27 docs(fuente-v5): §9.2 sin ensayos de placa como condición de cobre, y tres decisiones de Samuel
    - §9.2: lo que solo se cierra ensayando la placa construida pasa al bring-up y no bloquea la primera placa. Con eso H-V5-INVERSION queda cerrada en diseño: U15 con Q2 y Q7, su caída en ladrillo_budget.py y sus ensayos en el paso 1 del bring-up.
    - H-V2-AISLAMIENTO: el aislamiento y la fuga son del ladrillo certificado y el SAM17 es una carga de 24 V DC en ES1, clase III. El requisito toma las cifras de la hoja del TE90 (62368-1; 4000/1500/1500 VAC; < 500 µA y < 4 mA). La cifra de 4 mA, el grado del aislamiento y el informe CB quedan con AE.
    - H-V5-CORTO y H-PL-ABANDONO-FUENTE: el cordón caut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
2026-10-27 docs(fuente-v5): mapa de fallos de la entrada, del ladrillo a los DC-DC (H-V5-CORTO)
    Cada corto franco, parcial o contra el chasis entre el TE90A2449F01 y la
    entrada de los convertidores, con lo que lo limita, su corriente, duración y
    energía, la pieza que tiene que aguantarlo contra su hoja y el dueño.
    Detrás de U16 el franco lo corta U16 (4,144-4,864 A, <= 202 ms, enclava) y
    M5 abandona a los 4 pulsos. Delante de U16 solo limita el ladrillo: un
    parcial bajo su sobrecarga (130-180 % de 3,75 A, típicos) son 117-162 W sin
    tiempo publicado, y el receptáculo, el arnés y J1 -> U16 son nuestros. Un +
    contra el chasis vuelve por J5, NT1 y Q7. Los 2,4 W del corto franco eran la
    I²R de un c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
2026-10-27 feat(fuente-v5): check_enchufe.py, el enchufe en caliente del TE90 sobre +24V_RAW (#494)
    check_absmax.py da por hecho que D1 (SMBJ33CA) recorta a V_C = 53,3 V, y eso
    solo vale mientras su corriente no pase de I_PP = 11,3 A (bourns_smbj.pdf
    p. 2). Al enchufar con el ladrillo encendido, el cordon y el arnes son una L
    casi sin R contra C10: sin D1 el nodo llega a 2 x V.
    El guion integra ese lazo (RK4, validado contra el LC y los dos condensadores
    en forma cerrada, y con la energia cuadrada en cada corrida) con el TE90 en su
    OVP maximo de 36 V. Barre lo que ninguna hoja da: la C de salida del ladrillo
    (HUECO, de 1 uF a fuente ideal), el largo y la separacion de los hilos
    (ESTIMADO), C10 de -50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
2026-10-27 fix(fuente-v5): la banda de ILIM de U16 y U19 cuenta el 1 % de R11 y R34
    La fila de tps2663.pdf p. 7 es para R(ILIM) exacta, e I_OL va con 1/R
    (ec. 5). Con el 1 % de R11 la banda de U16 pasa de 4,185..4,815 A a
    4,146..4,866 A: el techo queda a 9 mA del disparo tipico del TE90
    (4,875 A), y con un 1,2 % el aserto de selectividad sale rojo. En U19,
    el disparo rapido sube de 3,28 a 3,32 A y el pico de U1 en el #334
    sigue en 17,40 V.
2026-10-27 docs(fuente-v5): H-V5-CORTO con el mapa de fallos, y los 2,4 W corregidos
    - La fila H-V5-CORTO de §9.2 decia que un corto franco en hiccup son
    unos 2,4 W. Es la I2R del cordon de escenario (16 AWG, 2 m) con 6,75 A
    continuos: ni el hiccup, cuyo pico no se publica, ni el cordon del TE90.
    El parcial por debajo del disparo va de 117 a 162 W.
    - La fila y el bloque D-V4 apuntan al mapa: delante de U16 nada nuestro
    para un corto parcial y no hay abandono.
    - El mapa usa la banda de U16 con el 1 % de R11.
2026-10-27 docs(fuente-v5): el mapa de fallos cita la pregunta de selectividad por su numero en el correo
2026-10-27 check_absmax: guarda del OVP de U19 contra el sobreimpulso del THN al soltar carga
    El borde bajo del OVP de U19 (16,19 V) queda 0,178 V sobre el maximo sano del
    crudo (16,012 V, envolvente de +-2,5 % de margen_budget.py), y el THN 20-2413WI
    sube ~0,19 V de sobreimpulso tipico ante un escalon de carga del 25 %
    (traco_thn20wi_characteristic_curves.pdf p. 8, lectura de figura). Ninguna
    puerta cruzaba las dos cifras.
    _guarda_ovp_sobreimpulso devuelve HUECO mientras TRACO no de un maximo: FALLO
    solo si el tipico no cabe ni con lo que la hoja garantiza (15,841 V, margen
    0,349 V), y OK solo con un maximo garantizado que quepa en la envolvente del
    repo. Con R36 > 3,94 kohm la guarda se pone roja (c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
2026-10-27 check_absmax: el borde alto del OVP de U19 contra el absmax de U1
    Con el THN atascado arriba sin pasar del OVP, U19 no abre y U1 ve en
    continua el borde alto del disparo; el disparo rapido no lo ve. Hasta
    ahora ninguna guarda lo ataba a los 20 V del LT1963A: con R36 = 3,24k
    (borde alto 20,11 V) check_absmax salia verde. Canario en R36 < 3,26k.
2026-10-27 fuente-v5: inversion sin gasto de reintentos, tramo delante de U16, retencion y filas del panel
    - Sec. 9.3: una inversion no gasta reintentos y corregirla no rearma nada;
    un abandono anterior solo lo libera el boton. recuperacion_budget.py
    comprueba contra la netlist que U18 y U17 se alimentan detras de Q2 y Q7,
    con dos canarios, y el paso 1 del bring-up lee el contador de la FRAM
    antes y despues de la prueba al reves.
    - H-V5-CORTO: el tramo nuestro delante de U16 se trata como el cordon y se
    dimensiona para la corriente maxima sostenida del ladrillo (H-MF-SOSTENIDA);
    el criterio pasa al mapa de fallos y al pliego.
    - H-V5-RETENCION: Snap n Lock enganchado y abrazadera en el panel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
2026-10-27 fuente-v5: R36 a 3,74 kohm, el OVP de U19 deja sitio al sobreimpulso del THN
    R36 pasa de 3,9 kohm a 3,74 kohm 0,1 % (Yageo RT0805BRD073K74L, C865467,
    misma serie y huella). El OVP de U19 sube de 16,55 a 17,21 V nominal, con
    banda de 16,83 a 17,59 V: el margen sobre el THN sano pasa de 0,18 a 0,82 V
    en la envolvente de margen_budget.py, y el sobreimpulso tipico al soltar
    carga (~0,19 V) cabe.
    Con el borde alto por encima del pico de #334 (17,40 V), lo peor que ve U1
    es un THN atascado justo debajo del OVP. check_absmax.py toma el mayor de
    los dos en absmax.csv, en la guarda de D10 y en su canario; D10 sigue sin
    conducir (17,59 V contra V_BR 17,8 V).
    La spec v5 y la propuesta de piezas lleva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
2026-10-27 docs: el README con la fuente v5 tras las decisiones del 27 de octubre
    Quedan 14 de las 16 preguntas de §9.2: 12 frenan la placa y 2 solo el panel trasero. Las pruebas que piden la placa hecha pasan a su bring-up, Mornsun sale porque su pieza ya no está en la placa, y los issues abiertos son cuatro.
2026-10-27 fuente-v5: H-V5-PE deja de bloquear el cobre de la placa
    Tercera enmienda de §9.2. Lo que la fila le pide a la placa ya está en
    ella: J5, el único puente de GNDA al chasis, y NT1, la única unión de
    GND24 y GNDA. Lo que falta vive fuera: el convertidor aislado de la
    pantalla (#480), el espárrago del chasis y el hilo de J5 (#424) y el
    ensayo del conjunto, que pide la placa construida. La fila sigue abierta
    y bloquea la pantalla y el chasis.
2026-10-27 docs: el README con H-V5-PE y #480 fuera del cobre de la placa
    Tras #517, de las 14 preguntas abiertas de §9.2 once bloquean la placa
    y tres solo el panel trasero, el chasis y la pantalla. #480 se resuelve
    con un convertidor aislado en la pantalla y deja de contarse entre los
    issues que traban el cobre.
2026-10-28 docs: el README abre con el render de la persiana
    La portada es el render frontal de la persiana, con el título, la línea de
    specs y los enlaces centrados debajo. El «no hay unidad terminada» pasa a un
    aviso IMPORTANT de GitHub, que dice además que el render es el modelo de
    OpenSCAD y que nada de lo que se ve existe todavía. El render de noche va tras
    la lista de «The instrument», con nota de que la luz de dentro es solo del
    render. El rediseño se sitúa en Alemania, sin ciudad.
    Claude-Session: https://claude.ai/code/session_01NgapG4Naf1DQi1QLfQ8JSs
2026-10-28 J2: el soak de 144 h a 8 kHz por el tic, medido, y la fila que cubre el horizonte
    resistencia_j2.csv: la fila de la hora 144 de la corrida del 21 al 27 de octubre
    (firmware 417afe0, transporte por tic, ranura 0 en SPI5 contra el esclavo del
    banco en SPI4, SCK a 6,25 MHz): 4 147 199 999 giros con cero plazos vencidos,
    cero EOT tardios y cero subidas malas.
    La corrida dio 145 filas por hora sin saltos, todos los testigos del tic en cero,
    atrasos = 0, inestable = false y muda = false, con un solo probe-rs sin
    reenganches. Por la regla de tres, la tasa queda por debajo de 7,2e-10 por
    transferencia al 95 %.
    Es la primera fila con al menos el 90 % de 8 kHz, asi que recuperacion_j2_budget.py
    da l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
2026-10-28 hardware: fuente v5, stock de LCSC refrescado el 28-10
    Las 87 filas de lcsc_snapshot.csv pasan a fecha 2026-10-28 con el stock de ese día. Cuatro piezas figuran a 0 en LCSC: C2866319 (TPS26631PWPR), C469660, C26108 y C28323.
2026-10-30 docs(fuente-v5): registrar respuestas de AE (P-258801) y ticket TRACO Power en especificaciones
2026-10-30 feat(fuente-v5): añadir criterio de bring-up de selectividad OCP a 45 °C (#493)
2026-10-30 docs: actualizar README con el estado al 30 de octubre
2026-10-30 feat(fuente-v5): incorporar C_b=2510 uF y corriente de contacto T17 de AE en check_enchufe y check_telemetria
2026-10-30 fw: el retraso del tic cuenta los periodos fundidos
2026-10-30 El tic tardío provocado, medido: el reloj de K2 no se aparta de la pared y el testigo de retraso cuenta los periodos fundidos
    tic_tardio con 0782b90 (5 de 7: con 150 y 300 us, 0 de 200 fuera de presupuesto) y con 56386b8 (7 de 7). Un mutante que cuenta entradas falla solo contra la pared (-199 y -400 periodos). La fila de la ficha J no se mueve: 2 331 / 2 398 con el tic de main, 2 328 / 2 397 con este.
2026-10-30 fw: ranuras-6, seis maestros con doce canales del GPDMA1 y cinco ranuras sin pines
    Ranura::sin_pines construye la ranura sin poner ningún pin en AF5; nueva conserva la misma secuencia de registros. IrqsBanco ata SPI3, SPI4 y SPI6 a las ranuras 4, 1 y 5, y los canales 8 a 11 del GPDMA1. Con ranuras-6, ranuras_de_medida! arma las ranuras 1 a 5 sin pines en los canales 2·n y 2·n + 1, los que programa el tic.
2026-10-30 fw: las ranuras de ranuras-6 llevan el SCK en AF y nada más
    Sin ningún pin en AF, el canal de transmisión del GPDMA1 mueve los 25 bytes, el de recepción no recibe ninguno y el EOT no llega: con d7cba23 vencieron todas las tramas de las cinco ranuras. Con el SCK en AF (PE12, PB9, PF2, PC10 y PC12, sin cablear) giran las seis sin un plazo vencido. Ranura::sin_pines pasa a Ranura::solo_sck, que toma el AF del SckPin.
2026-10-30 fw: sin ranuras-6, la ranura y las ataduras quedan como en main
    Con Option en el tipo de la ranura en todas las compilaciones, Hw cambiaba de forma y el tic se compilaba distinto: la fila fría de la ficha J pasaba de 2 399 a 2 458 ciclos, medido en la misma sesión. Ahora el resto de los pines es un arreglo salvo con ranuras-6, solo_sck y las siete ataduras nuevas van detrás de la feature, y la ITCM de la configuración de la ficha J sale idéntica a la de main. maestros_solo_sck va fuera de la ITCM: corre al arrancar y llama a set_as_af de embassy.
2026-10-30 Seis maestros con doce canales del GPDMA1, medidos: 2 281 ciclos por giro y ranura en frío, el 13,7 % de un núcleo
    Las seis ranuras reales de §5.2 (b) del papel v3 no caben en la Nucleo: con CN2 y CN16 sin soldar, el morpho no saca seis SPI enteros. El sustituto son seis maestros, uno por SPI, con los doce canales del GPDMA1, y las cinco ranuras que no son la del banco con el SCK y nada más.
    En la configuración de la ficha J, en la misma sesión: con seis, 2 221 / 2 281 ciclos por giro y ranura, caliente / fría; con tres, 2 328 / 2 399 en main y 2 330 / 2 399 en esta rama. Ningún tic tardío ni fuera de presupuesto, ningún plazo vencido ni recuperación, el tic dura 8,74 µs de medi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
2026-10-30 PC3 del N657 no va al ST-LINK: la Tabla 16 del UM3417 da los pines del STM32 del ST-LINK
    Los PC3, PC4, PB14 y PB15 de esa tabla (el USB-C CN10) son del microcontrolador
    del ST-LINK. En el N657, PC3 es el pin 25 del CN3, el MOSI de SPI1 en la ranura
    de relleno 2, y no toca el CC1 del depurador. Se quitan la nota que lo daba por
    conectado a STLK_UCPD_CC1_C (EN-PLACA y j2_banco), la frase que decía que SPI1
    no se podía usar en la placa y la reserva de esos cuatro pines para el ST-LINK
    en la elección del pin del osciloscopio (EN-PLACA y plazos_j2). Las seis
    ranuras reales siguen sin caber: a SPI2, SPI3 y SPI6 les faltan pines en el
    morpho.
